c4deszes/bike-rotor-sensor/hardware/docs/index.rst

Rotor Sensor PCBA
=================

.. toctree::
    :maxdepth: 4

    arch/index.rst
    design/index.rst
