c4deszes/bike-rotor-sensor/software/docs/design/device_config.rst

Device configuration
--------------------

The device configuration is a single NVM sector (256 bytes).

Layout
------

Front wheel circumference (16 bit)
Rear wheel circumference (16 bit)
Crankset circumference (16 bit)

Front sensor type (8 bit)
Rear sensor type (8 bit)
Cadence sensor type (8 bit)

iTPMS threshold (16 bit)
iTPMS cycles/duration (16 bit)

IMU Acc. level X (16)
IMU Acc. level Y (16)
IMU Acc. level Z (16)
