c4deszes/bike-rotor-sensor/system/docs/reqs/mechanical.rst

Mechanical requirements
=======================

Mounting
--------

.. req-sys:: Mounting area
    :id: REQ_SYS_MECHANICAL_MOUNTING_AREA
    :status: accepted

    The mounting area can be seen on the picture below, it's where kickstands would normally be
    mounted.

    The area is a ``31mm x 52 mm`` rectangle with a ``10mm`` hole in the middle.

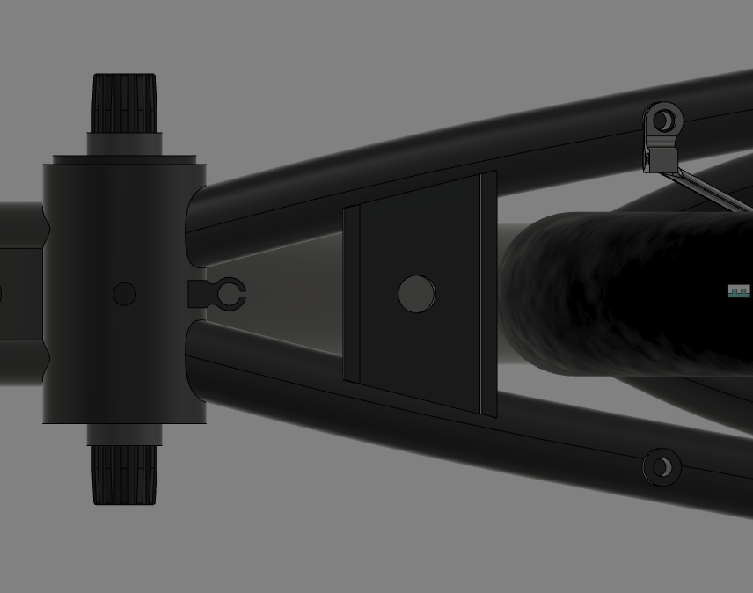
[picture p1: system/docs/reqs/assets/mounting.png]
