c4deszes/bike-rotor-sensor/hardware/docs/design/index.rst

Design
======

.. toctree::
    :maxdepth: 4

    pwr_conditioning
    output_stage
    communication
    controller
    sensor
