c4deszes/bike-rotor-sensor/hardware/docs/design/sensor.rst

Sensor
======

:download:`BMI088 <../datasheets/BMI088.pdf>` is chosen for motion sensing, it incorporates an
accelerometer and a gyroscope in one chip.

Schematic
---------

See SPI connection diagram :download:`BMI088 <../datasheets/BMI088.pdf>` , section 7.2 - page 53.
