c4deszes/bike-rotor-sensor/software/docs/design/index.rst

Design
======

.. toctree::

    clock
    communication
    inertial_estimator
    itpms_service
    measurement
    output_stage
    sensor_control
    speed_monitor
