c4deszes/bike-rotor-sensor/software/docs/index.rst

Rotor Sensor software
=====================

.. toctree::

    arch/index
    design/index
