c4deszes/bike-rotor-sensor/hardware/design/connector-pcb/models/B04B-JWPF-SK-R.step

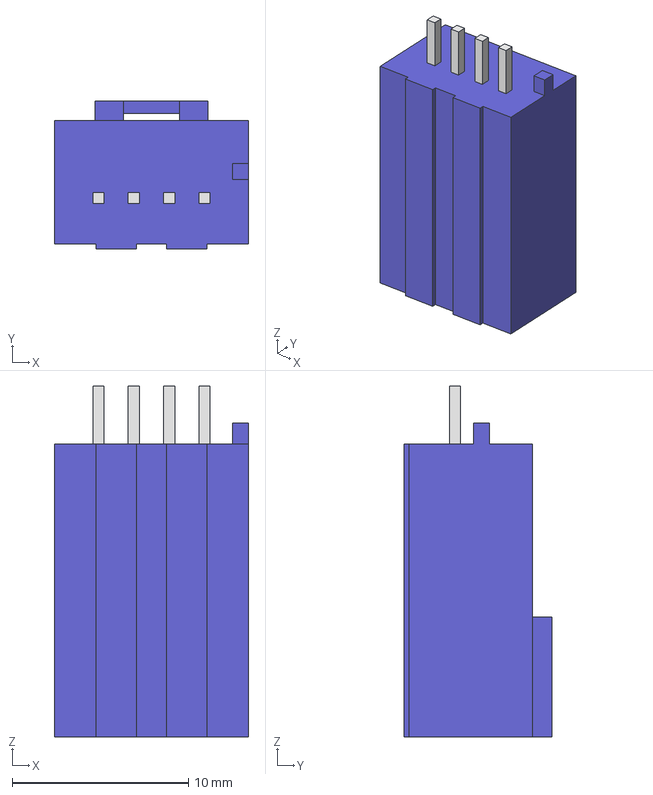
[picture p5: CAD file, 2024-10-27]
hardware/design/connector-pcb/models/B04B-JWPF-SK-R.step
11.0 x 8.40 x 19.9 mm
