c4deszes/bike-rotor-sensor/hardware/design/connector-pcb/pcba_outline.dxf

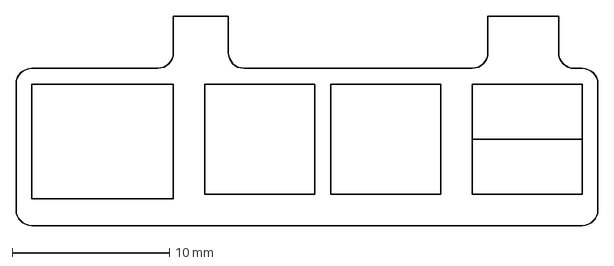
[picture p6: CAD file, 2025-10-19]
hardware/design/connector-pcb/pcba_outline.dxf
37.0 x 13.3 mm
