c4deszes/bike-rotor-sensor/hardware/design/optical-sensor/models/pcba_outline.dxf

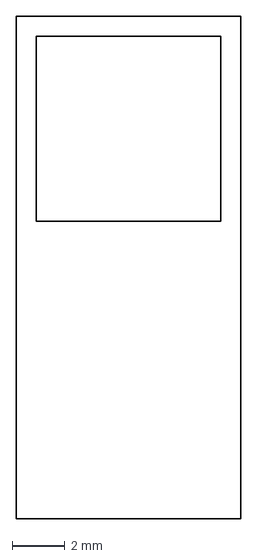
[picture p7: CAD file, 2024-10-27]
hardware/design/optical-sensor/models/pcba_outline.dxf
8.50 x 19.0 mm
