c4deszes/bike-rotor-sensor/hardware/design/rotor-sensor/models/VLS3015CX-1R0M-1.step

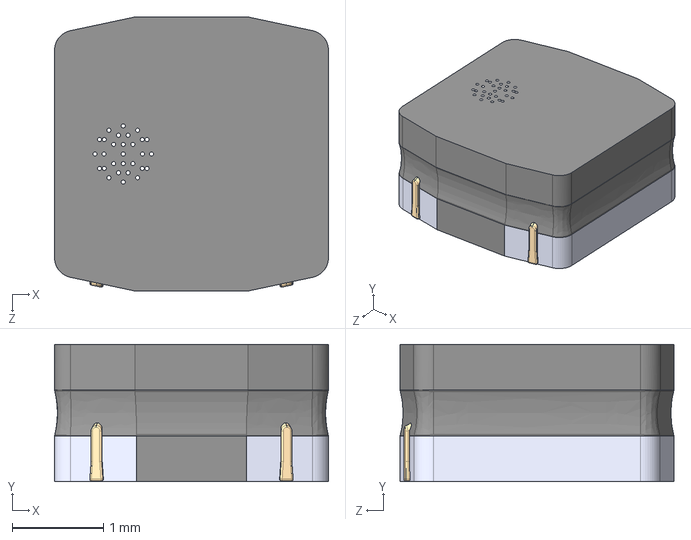
[picture p8: CAD file, 2025-10-19]
hardware/design/rotor-sensor/models/VLS3015CX-1R0M-1.step
3.00 x 1.50 x 3.00 mm
