c4deszes/bike-rotor-sensor/hardware/design/rotor-sensor/pcba_outline.dxf

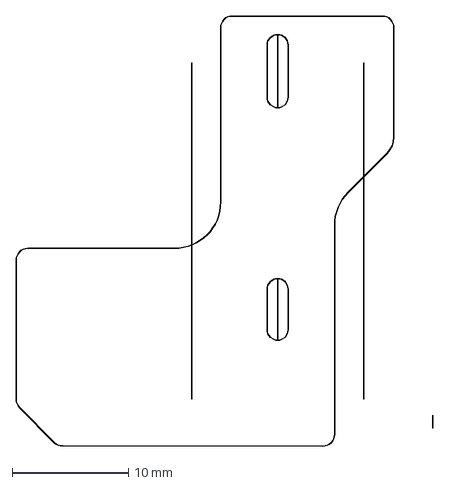
[picture p9: CAD file, 2025-10-19]
hardware/design/rotor-sensor/pcba_outline.dxf
35.9 x 37.0 mm
