c4deszes/bike-rotor-sensor/hardware/design/connector-pcb/models/B03B-JWPF-SK-R.STEP

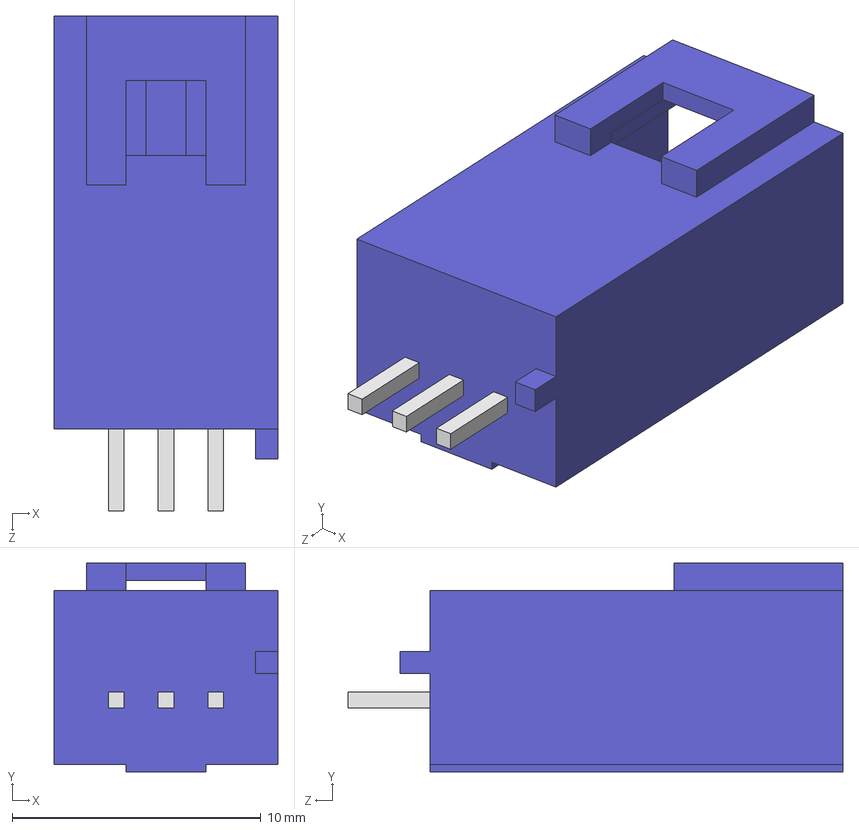
[picture p10: CAD file, 2024-10-27]
hardware/design/connector-pcb/models/B03B-JWPF-SK-R.STEP
9.00 x 8.40 x 19.9 mm
