c4deszes/bike-rotor-sensor/hardware/design/rotor-sensor/models/BMI088.step

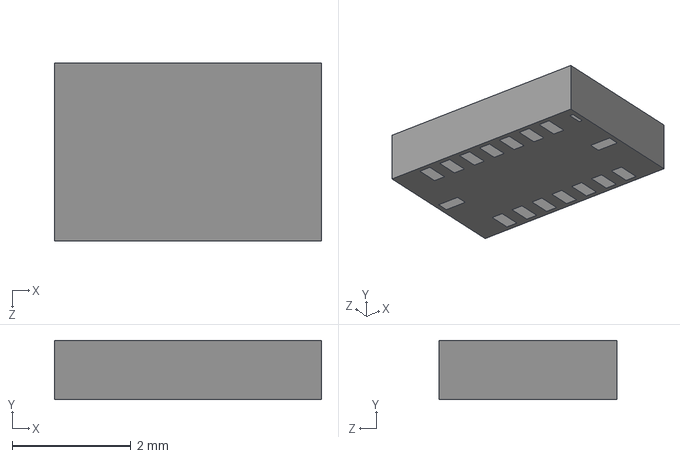
[picture p11: CAD file, 2025-10-19]
hardware/design/rotor-sensor/models/BMI088.step
4.50 x 1.00 x 3.00 mm
