c4deszes/bike-rotor-sensor/hardware/design/connector-pcb/models/B02B-JWPF-SK-R.step

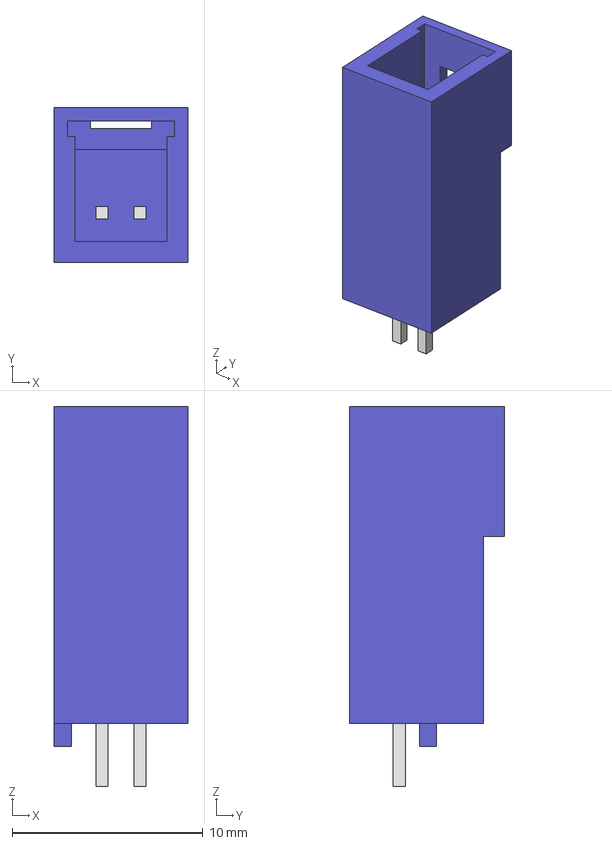
[picture p12: CAD file, 2024-10-27]
hardware/design/connector-pcb/models/B02B-JWPF-SK-R.step
7.00 x 8.10 x 19.9 mm
