c4deszes/bike-rotor-sensor/hardware/design/rotor-sensor/models/BMP581.step

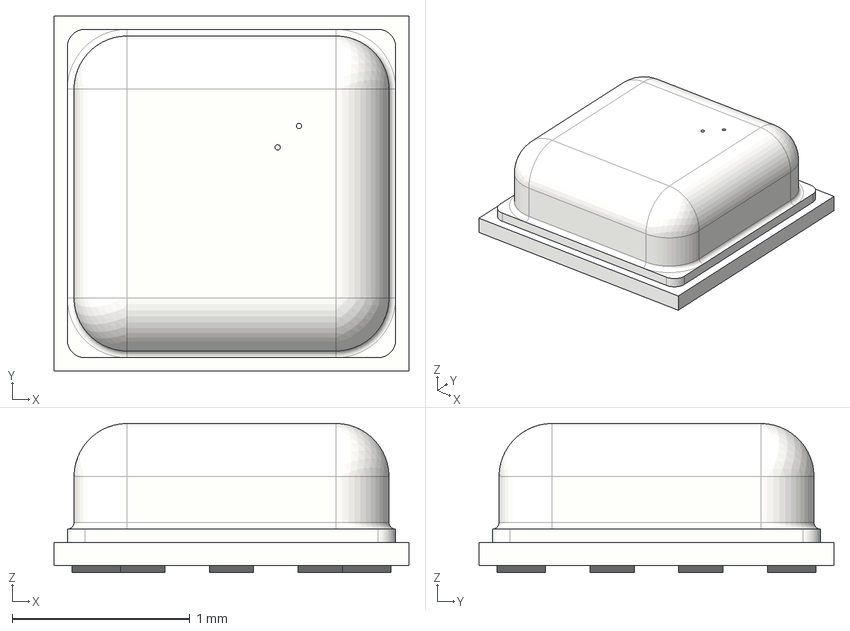
[picture p13: CAD file, 2025-10-19]
hardware/design/rotor-sensor/models/BMP581.step
2.00 x 2.00 x 0.84 mm
