c4deszes/bike-rotor-sensor/(list of files, cad)

Other CAD files:
mechanics/design/gen1.0/Housing_v53.stl
mechanics/design/gen2.0/Cover_v54_2wire.stl
mechanics/design/gen2.1/Cover_v23.stl
mechanics/design/magnet-holder/ValveMagnetHolder_v6.stl
mechanics/design/sensor-holder/SpeedSensor_MagneticRear_wCrank_v18_Cover.stl
mechanics/tools/motor-jig/MotorHolder.stl
mechanics/tools/probe/SensorProbeMount.stl
mechanics/tools/testjig/BearingFlange.stl
mechanics/design/gen1.0/Cover_v53.stl
mechanics/design/gen2.0/Base_v54_2wire.stl
mechanics/design/gen2.1/Base_v23.stl
mechanics/design/magnet-holder/CrankMagnetHolder_Hex6_v3.stl
mechanics/design/sensor-holder/SpeedSensor_MagneticRear_wCrank_v18_Body.stl
mechanics/tools/motor-jig/RotorHolder2.stl
mechanics/tools/probe/ProbeBottomHolder.stl
mechanics/tools/testjig/Base.stl
mechanics/design/gen2.0/Base_v9_3wire.stl
mechanics/design/gen2.1/Seal_v23.stl
mechanics/design/sensor-holder/SpeedSensor_MagneticFront_v26.stl
mechanics/tools/motor-jig/RotorHolder.stl
mechanics/tools/probe/SensorProbeMount2.stl
mechanics/tools/testjig/MotorHolder.stl
mechanics/design/gen2.0/Cover_v9_3wire.stl
mechanics/design/sensor-holder/SpeedSensor_OpticalRear_v11.stl
mechanics/tools/motor-jig/RotorBase.stl
mechanics/tools/testjig/MagnetHolderTop.stl
mechanics/design/sensor-holder/SpeedSensor_MagneticRear_v16.stl
mechanics/tools/motor-jig/Rotor.stl
mechanics/tools/testjig/CenterLockCarrier.stl
mechanics/tools/testjig/MagnetHolderBottom.stl
mechanics/tools/testjig/MotorFlange.stl
hardware/design/connector-pcb/models/pcba_outline.dxf
hardware/design/rotor-sensor/models/TPS629210DRLR.step
hardware/design/rotor-sensor/models/pcba_outline.dxf
