c4deszes/bike-rotor-sensor/system/docs/tests/index.rst

Test plan
---------

.. toctree::
    :maxdepth: 1

    electrical
    environmental
