c4deszes/bike-rotor-sensor/system/docs/fmea/index.rst

Failure mode analysis and evaluation
====================================

.. toctree::

    measurement
    sensors
