c4deszes/bike-rotor-sensor/hardware/design/rotor-sensor/rotor-sensor.kicad_pcb

## KiCad design hardware/design/rotor-sensor/rotor-sensor.kicad_pcb (2025-10-19)

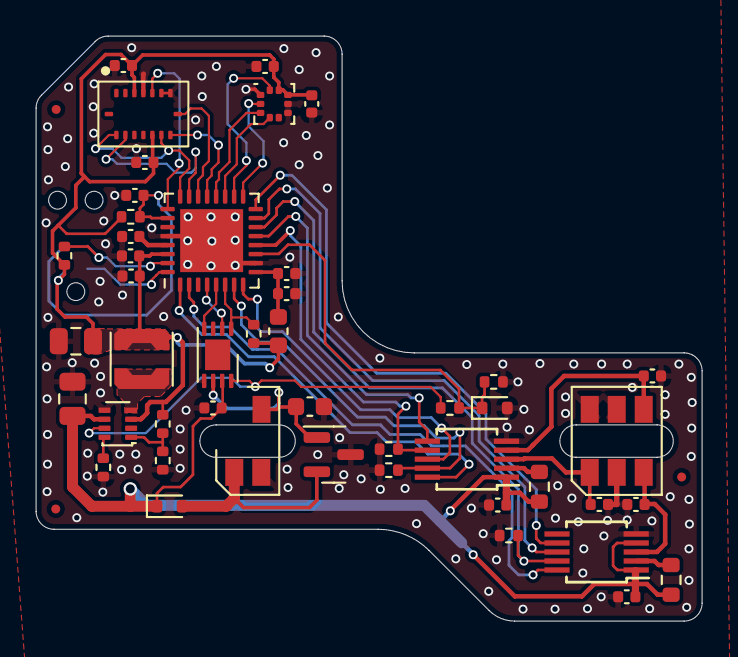
[picture p14: board rotor-sensor.kicad_pcb from above]

Board: 2 copper layers, 37.0 x 32.5 mm, 50 parts (1 on the bottom side), 41 nets.

Parts:
C1, C2, C3, C6, C8, C9, C12, C15, C20, C23, C27, C600, C601: 100n; C_0402_1005Metric
C4, C5: 10u; C_0402_1005Metric
C7: 2.2u; C_0402_1005Metric
C10: 220p; C_0603_1608Metric
C11: 22u; C_0805_2012Metric
C16: 10u; C_0805_2012Metric
D1: BAS3005B02; D_SOD-523
D2: MM5Z3V6T1G; D_SOD-523
D4: SDT23C15L02; SOT-23
FID1, FID3, FID4: Fiducial; Fiducial_0.5mm_Mask1mm
J1: Conn_ARM_SWD_TagConnect_TC2030-NL; Tag-Connect_TC2030-IDC-NL_2x03_P1.27mm_Vertical
J2: Conn_01x06; SOIC-6
L1: 10uH; L_0603_1608Metric
L3: 2.2u; L_Coilcraft_LPS3010
R1, R3, R4, R6, R15, R17: 4.7k; R_0402_1005Metric
R2: 47k; R_0402_1005Metric
R5: 20k; R_0402_1005Metric
R7: 0; R_0402_1005Metric
R9, R18: 63.4k; R_0603_1608Metric
R12: 1k; R_0402_1005Metric
R13: 10k; R_0402_1005Metric
U1, U8: MAX9621AUB+T; MSOP-10_3x3mm_P0.5mm
U2: MCP2003BT-E/MC; DFN-8-1EP_3x2mm_P0.5mm_EP1.7x1.4mm
U3: BMI088; Bosch_LGA16
U6: TPS629210DRLR; SOT-583-8
U7: SOIC-4
U10: ATSAMD21E18A-MUT; VQFN-32-1EP_5x5mm_P0.5mm_EP3.5x3.5mm
U600: BMP581; Bosch_LGA10

Connections:
+3.3V: C4.2, C8.2, C9.1, C11.1, C12.2, C600.2, C601.2, J1.1 (VCC), L1.1, L3.2, R4.1, R5.1, R12.1, R13.1, U3.3 (VDD), U3.11 (VDDIO), U6.3 (VOS), U10.30 (VDDIN), U600.1 (VDDIO), U600.10 (VDD)
+BATT: C1.2, C2.2, C6.2, C16.2, D1.1 (K), R9.1, R18.1, U1.1 (BAT), U2.7 (V_{BB}), U6.6 (VIN), U8.1 (BAT), U8.4 (IN2)
/M03_EN: U2.2 (CS), U10.4 (PA03)
/M03_LINE: C10.1, D4.1 (K), U2.6 (L_{BUS}), U7.3
/M03_REGEN: R2.1, U2.8 (V_{REN}), U6.7 (EN)
/M03_RXD: R4.2, U2.1 (R_{XD}), U10.6 (PA05)
/M03_TXD: U2.4 (T_{XD}), U10.5 (PA04)
/M03_VMON: D2.1 (K), R2.2, R3.1, U10.11 (PA08)
/M04_IN1_IN: C3.2, J2.1, U1.3 (IN1)
/M04_IN2_IN: C27.2, J2.4, U1.4 (IN2)
/M04_IN3_IN: C23.2, J2.3, U8.3 (IN1)
/M04_INPUT1_DIAG/OE: R17.2, U1.9 (AOUT1), U10.7 (PA06)
/M04_INPUT1/~ERR: U1.8 (DOUT1), U10.8 (PA07)
/M04_INPUT2_DIAG/INPUT1: R15.2, U1.7 (AOUT2), U10.12 (PA09)
/M04_INPUT2/INPUT2: U1.6 (DOUT2), U10.13 (PA10)
/M04_INPUT3_DIAG/OE: R1.2, U8.9 (AOUT1), U10.14 (PA11)
/M04_INPUT3/~ERR: U8.8 (DOUT1), U10.15 (PA14)
/M04_NC/INPUT3: U8.7 (AOUT2), U10.16 (PA15)
/M04_~SLEEP1/DIAG1: U1.10 (~SLEEP), U10.1 (PA00)
/M04_~SLEEP2/DIAG2: U8.10 (~SLEEP), U10.2 (PA01)
/M05_BMI088_MOSI: U3.9 (SDI), U10.21 (PA22)
/M05_BMI088_SCK: U3.8 (SCK), U10.22 (PA23)
/M05_RESET: C20.2, J1.3 (~RESET), R13.2, U10.26 (~RESET)
/M05_SWCLK: J1.4 (SWCLK), R12.2, U10.31 (PA30)
/M05_SWDIO: J1.2 (SWDIO), U10.32 (PA31)
/M06_BMI088_CSA: U3.14 (CSB1), U10.23 (PA24)
/M06_BMI088_CSG: U3.5 (CSB2), U10.25 (PA27)
/M06_BMI088_MISO: U3.10 (SDO2), U3.15 (SDO1), U10.24 (PA25)
/M06_BMP581_CS: U10.19 (PA18), U600.6 (CSB)
/M06_BMP581_MISO: U10.20 (PA19), U600.5 (SDO)
/M06_BMP581_MOSI: U10.17 (PA16), U600.4 (SDI)
/M06_BMP581_SCK: U10.18 (PA17), U600.2 (SCK)
/TPS629210_FB: R5.2, R6.1, U6.1 (FB)
/TPS629210_MODE: R7.1, U6.8 (MODE)
/TPS629210_SW: L3.1, U6.4 (SW)
/VDDANA: C5.2, C15.2, L1.2, U10.9 (VDDANA)
/VDDCORE: C7.2, U10.29 (VDDCORE)
GND: C1.1, C2.1, C3.1, C4.1, C5.1, C6.1, C7.1, C8.1, C9.2, C10.2, C11.2, C12.1, C15.1, C16.1, C20.1, C23.1, C27.1, C600.1, C601.1, D2.2 (A), D4.3 (A), J1.5 (GND), J2.2, J2.5, J2.6, R1.1, R3.2, R6.2, R7.2, R15.1, R17.1, U1.5 (GND), U2.5 (V_{SS}), U3.4 (GND), U3.6 (GNDIO), U3.7 (PS), U6.5 (GND), U7.2, U8.5 (GND), U10.10 (GND), U10.28 (GND), U10.33 (GND), U600.3 (GND), U600.8 (GND), U600.9 (GND)
unnamed: R18.2, U1.2 (ISET)
unnamed: R9.2, U8.2 (ISET)
VS: D1.2 (A), D4.2 (K), U7.1
