c4deszes/bike-rotor-sensor/hardware/design/connector-pcb/connector-pcb.kicad_pcb

## KiCad design hardware/design/connector-pcb/connector-pcb.kicad_pcb (2025-10-19)

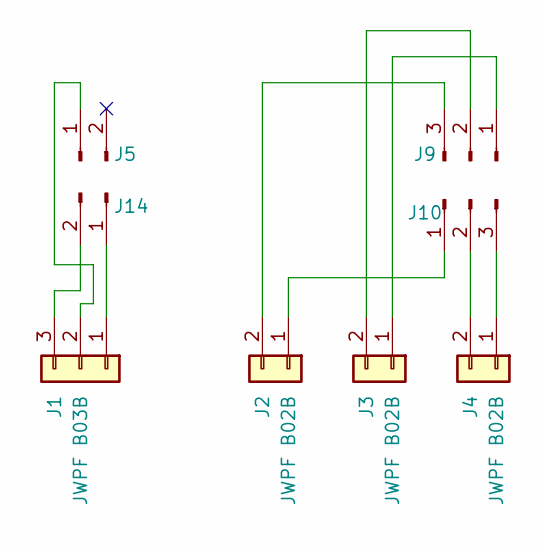
[picture p15: schematic connector-pcb.kicad_sch]

Parts:
J1: JWPF B03B; JST_JWPF_B03B-JWPF-SK-R_1x03_P2.00mm_Vertical
J2, J3, J4: JWPF B02B; JST_JWPF_B02B-JWPF-SK-R_1x02_P2.00mm_Vertical
J5, J14: Conn_01x02_Pin; SMD_2PIN
J9, J10: Conn_01x03_Pin; SMD_3PIN

Connections:
unnamed: J1.1, J14.1
unnamed: J1.2, J5.1
unnamed: J1.3, J14.2
unnamed: J2.2, J9.3
unnamed: J3.1, J9.1
unnamed: J3.2, J9.2
unnamed: J2.1, J10.1
unnamed: J4.2, J10.2
unnamed: J4.1, J10.3

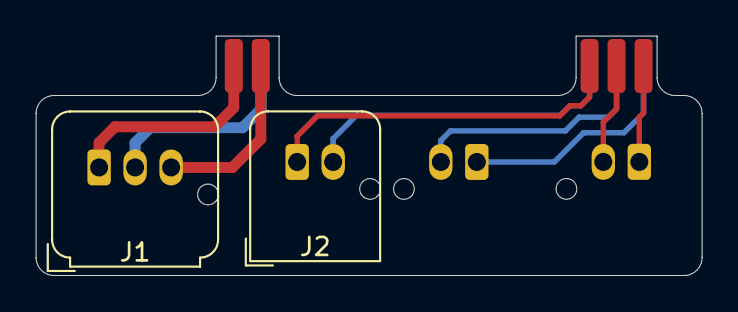
[picture p16: board connector-pcb.kicad_pcb from above]

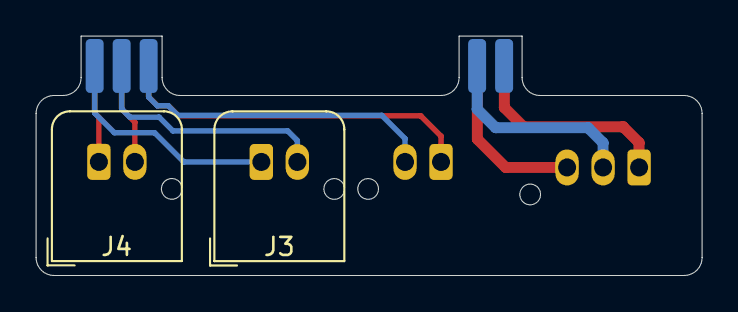
[picture p17: board connector-pcb.kicad_pcb from below]

Board: 2 copper layers, 37.0 x 13.3 mm, 8 parts (4 on the bottom side), 9 nets.
