c4deszes/bike-rotor-sensor/hardware/design/optical-sensor/optical-sensor.kicad_pcb

## KiCad design hardware/design/optical-sensor/optical-sensor.kicad_pcb (2024-10-27)

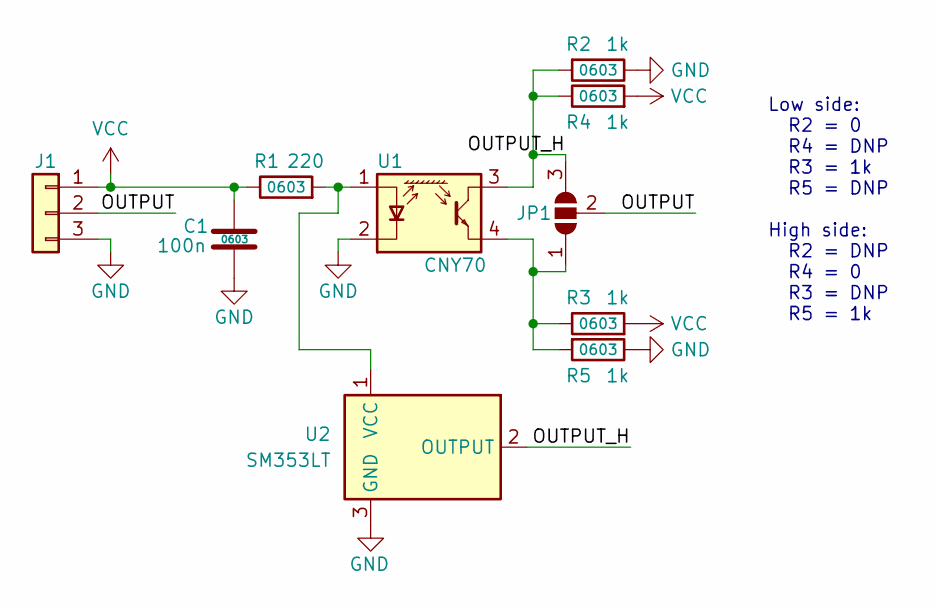
[picture p18: schematic optical-sensor.kicad_sch]

Parts:
C1: 100n; C_0603_1608Metric
J1: PinHeader_1x03_P2.54mm_Vertical
JP1: SolderJumper_3_Open; SolderJumper-3_P1.3mm_Open_RoundedPad1.0x1.5mm
R1: 220; R_0603_1608Metric
R2, R3, R4, R5: 1k; R_0603_1608Metric
U1: CNY70; Vishay_CNY70
U2: SM353LT; SOT-23

Connections:
/OUTPUT: J1.2, JP1.2 (C)
/OUTPUT_H: JP1.3 (B), R2.2, R4.1, U1.3 (C), U2.2 (OUTPUT)
GND: C1.2, J1.3, R2.1, R5.1, U1.2 (K), U2.3 (GND)
unnamed: JP1.1 (A), R3.1, R5.2, U1.4 (E)
unnamed: R1.2, U1.1 (A), U2.1 (VCC)
VCC: C1.1, J1.1, R1.1, R3.2, R4.2

Notes on the sheet:
Low side: R2 = 0 R4 = DNP R3 = 1k R5 = DNP High side: R2 = DNP R4 = 0 R3 = DNP R5 = 1k

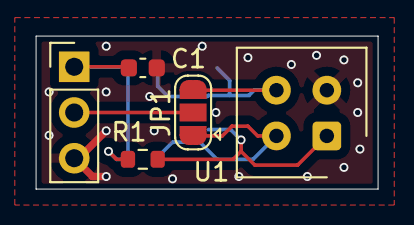
[picture p19: board optical-sensor.kicad_pcb from above]

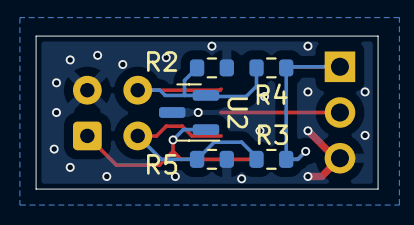
[picture p20: board optical-sensor.kicad_pcb from below]

Board: 2 copper layers, 19.0 x 8.5 mm, 10 parts (5 on the bottom side), 6 nets.
