c4deszes/bike-rotor-sensor/software/include/app/sys_state.h

#if !defined(APP_SYS_STATE_H_)
#define APP_SYS_STATE_H_

/**
 * @brief Initialize the system state machine
 */
void SYSSTATE_Initialize(void);

/**
 * @brief Updates the system state machine
 */
void SYSSTATE_Update(void);

#endif // APP_SYS_STATE_H_
