c4deszes/bike-rotor-sensor/software/src/app/altitude.c

#include "app/altitude.h"
#include "bsp/bmp581.h"
#include "app/config.h"

#include "common/swtimer.h"

#include "bmp5.h"
#include "bmp5_defs.h"

/* Altitude measurement status */
static ALT_Status_t ALT_Status;
static uint32_t ALT_Pressure;
static int16_t ALT_Altitude;
static uint16_t ALT_Temperature;

/* Altitude sensor */
static swtimer_t* ALT_SensorTimer;
static uint8_t ALT_StartupAttempts;
static bool ALT_SensorInitialized;
static int8_t ALT_BMP5_InitCode;
static uint8_t ALT_RuntimeErrorCnt;

/* BMP58X configuration */
static struct bmp5_osr_odr_press_config ALT_BMP5_RateConfig = { 0 };
static struct bmp5_iir_config ALT_BMP5_IIRConfig = {
    .set_iir_t = BMP5_IIR_FILTER_COEFF_1,   // TODO: choose filter coefficient
    .set_iir_p = BMP5_IIR_FILTER_COEFF_1,   // TODO: choose filter coefficient
    .shdw_set_iir_t = BMP5_ENABLE,
    .shdw_set_iir_p = BMP5_ENABLE
};
static struct bmp5_sensor_data ALT_BMP5_SensorData = { 0 };

static void ALT_SetupSensor() {
    bmp5_init(&BMP581_Device);

    ALT_BMP5_InitCode = bmp5_set_power_mode(BMP5_POWERMODE_STANDBY, &BMP581_Device);

    if (ALT_BMP5_InitCode != BMP5_OK) {
        return;
    }

    ALT_BMP5_InitCode = bmp5_get_osr_odr_press_config(&ALT_BMP5_RateConfig, &BMP581_Device);
    if (ALT_BMP5_InitCode != BMP5_OK) {
        return;
    }

    ALT_BMP5_RateConfig.press_en = BMP5_ENABLE;
    // TODO: output data rate

    ALT_BMP5_InitCode = bmp5_set_osr_odr_press_config(&ALT_BMP5_RateConfig, &BMP581_Device);
    if (ALT_BMP5_InitCode != BMP5_OK) {
        return;
    }

    ALT_BMP5_InitCode = bmp5_set_iir_config(&ALT_BMP5_IIRConfig, &BMP581_Device);
    if (ALT_BMP5_InitCode != BMP5_OK) {
        return;
    }

    ALT_BMP5_InitCode = bmp5_set_power_mode(BMP5_POWERMODE_CONTINOUS, &BMP581_Device);
    if (ALT_BMP5_InitCode != BMP5_OK) {
        return;
    }
}

void ALT_Initialize(void) {
    ALT_Status = ALT_Status_NotAvailable;
    ALT_Pressure = 0;
    ALT_Altitude = 0;
    ALT_Temperature = 0;

    ALT_SensorTimer = SWTIMER_Create();
    ALT_StartupAttempts = 0;
    ALT_SensorInitialized = false;
    ALT_BMP5_InitCode = BMP5_OK;
    ALT_RuntimeErrorCnt = 0;

    SWTIMER_Setup(ALT_SensorTimer, ALT_SENSOR_STARTUP_TIME);
}

ALT_Status_t ALT_GetStatus(void) {
    return ALT_Status;
}

bool ALT_HasPressureError(void) {
    // TODO: implement
    return false;
}

bool ALT_HasTemperatureError(void) {
    // TODO: implement
    return false;
}

int16_t ALT_GetAltitude(void) {
    return ALT_Altitude;
}

uint32_t ALT_GetPressure(void) {
    return ALT_Pressure;
}

uint16_t ALT_GetTemperature(void) {
    return ALT_Temperature;
}

int16_t CalculateAltitude(uint32_t qnh, uint16_t temperature, uint32_t pressure);

void ALT_Update(void) {
    if (!ALT_SensorInitialized && CONFIG_Props.Altitude_Enabled && SWTIMER_Elapsed(ALT_SensorTimer)) {
        ALT_SetupSensor();

        if (ALT_BMP5_InitCode == BMP5_OK) {
            ALT_Status = ALT_Status_Ok;
            ALT_SensorInitialized = true;
        } else {
            SWTIMER_Setup(ALT_SensorTimer, ALT_SENSOR_STARTUP_ATTEMPT_DELAY);
            ALT_Status = ALT_Status_Error;

#if ALT_SENSOR_STARTUP_ATTEMPTS > 0
            if (ALT_StartupAttempts < ALT_SENSOR_STARTUP_ATTEMPTS) {
                ALT_StartupAttempts++;
            }
            else {
                ALT_Status = ALT_Status_PermanentError;
            }
#endif
        }
    }

    if (ALT_SensorInitialized && ALT_Status != ALT_Status_PermanentError) {
        int8_t read_status = bmp5_get_sensor_data(&ALT_BMP5_SensorData,
                                                  &ALT_BMP5_RateConfig,
                                                  &BMP581_Device);

        if (read_status == BMP5_OK) {
            ALT_Pressure = ALT_BMP5_SensorData.pressure / 100;
            ALT_Temperature = ALT_BMP5_SensorData.temperature / 100 + 273;
            ALT_Altitude = CalculateAltitude(CONFIG_Props.Altitude_QNH * 100,
                                             ALT_Temperature,
                                             ALT_Pressure);
            
            // TODO: verify pressure, temperature in plausible range
            if (ALT_Altitude > 5000 || ALT_Altitude < -500) {
                ALT_Status = ALT_Status_Error;
            }
            else {
                ALT_Status = ALT_Status_Ok;
            }
        }
        else {
            ALT_Status = ALT_Status_Error;
#if ALT_SENSOR_POLL_MAX_ERRORS > 0
            if (ALT_RuntimeErrorCnt < ALT_SENSOR_POLL_MAX_ERRORS) {
                ALT_RuntimeErrorCnt++;
            }
            else {
                ALT_Status = ALT_Status_PermanentError;
            }
#endif
        }
    }
}

#define LOOKUP_OUT_OF_RANGE 0xFF

static inline uint8_t QNH_Index(uint32_t qnh) {
    if (qnh < 100000 || qnh > 104000) {
        return LOOKUP_OUT_OF_RANGE;
    }
    uint8_t index = (qnh - 100000) / 100;
    if (index >= 41) {
        return LOOKUP_OUT_OF_RANGE;
    }
    return index;
}

static inline uint8_t TEMP_Index(uint16_t temp) {
    if (temp < 263) {
        return LOOKUP_OUT_OF_RANGE;
    } else if (temp < 268) {
        return 0;
    } else if (temp < 278) {
        return 1;
    } else if (temp < 288) {
        return 2;
    } else if (temp < 298) {
        return 3;
    } else if (temp < 308) {
        return 4;
    } else if (temp < 318) {
        return 5;
    } else if (temp <= 338) {
        return 6;
    }
    return LOOKUP_OUT_OF_RANGE;
}

static inline int16_t Index_ToAlt(uint8_t index) {
    return 100 * index - 500;
}

#define ALTITUDE_LOOKUP_SIZE 56
#define PRESSURE_OFFSET 48000u

const uint16_t ALT_Lookup[41][7][56] = {
  /*  */
  { /* QNH=100000 Pa */
 /* T=263K (-10.1C) */   {58666u, 57305u, 55958u, 54624u, 53305u, 52000u, 50708u, 49429u, 48164u, 46913u, 45674u, 44449u, 43237u, 42037u, 40851u, 39677u, 38515u, 37367u, 36230u, 35106u, 33994u, 32894u, 31806u, 30730u, 29666u, 28613u, 27572u, 26543u, 25525u, 24518u, 23522u, 22538u, 21564u, 20601u, 19650u, 18709u, 17778u, 16858u, 15949u, 15049u, 14161u, 13282u, 12413u, 11555u, 10706u, 9867u, 9038u, 8218u, 7408u, 6608u, 5817u, 5035u, 4262u, 3499u, 2745u, 1999u},
 /* T=273K (-0.1C) */   {58416u, 57107u, 55811u, 54527u, 53257u, 52000u, 50755u, 49522u, 48303u, 47095u, 45900u, 44717u, 43546u, 42387u, 41240u, 40105u, 38982u, 37870u, 36770u, 35681u, 34604u, 33537u, 32482u, 31438u, 30405u, 29383u, 28372u, 27372u, 26382u, 25402u, 24434u, 23475u, 22527u, 21589u, 20661u, 19743u, 18835u, 17937u, 17049u, 16171u, 15302u, 14443u, 13593u, 12753u, 11921u, 11100u, 10287u, 9483u, 8688u, 7903u, 7126u, 6358u, 5598u, 4847u, 4105u, 3371u},
 /* T=283K (9.9C) */   {58184u, 56923u, 55674u, 54437u, 53212u, 52000u, 50798u, 49609u, 48431u, 47265u, 46110u, 44967u, 43835u, 42714u, 41604u, 40505u, 39417u, 38340u, 37274u, 36218u, 35173u, 34139u, 33115u, 32101u, 31098u, 30105u, 29121u, 28148u, 27185u, 26232u, 25289u, 24355u, 23431u, 22517u, 21612u, 20717u, 19830u, 18954u, 18086u, 17227u, 16378u, 15537u, 14706u, 13883u, 13069u, 12264u, 11467u, 10679u, 9899u, 9128u, 8365u, 7611u, 6864u, 6126u, 5396u, 4674u},
 /* T=293K (19.9C) */   {57968u, 56752u, 55547u, 54353u, 53171u, 52000u, 50839u, 49690u, 48551u, 47424u, 46306u, 45200u, 44104u, 43019u, 41944u, 40879u, 39824u, 38780u, 37746u, 36721u, 35707u, 34702u, 33708u, 32723u, 31747u, 30781u, 29825u, 28878u, 27941u, 27012u, 26093u, 25183u, 24282u, 23391u, 22508u, 21634u, 20768u, 19912u, 19064u, 18225u, 17394u, 16571u, 15757u, 14952u, 14155u, 13365u, 12584u, 11811u, 11047u, 10290u, 9540u, 8799u, 8066u, 7340u, 6622u, 5911u},
 /* T=303K (29.9C) */   {57766u, 56592u, 55428u, 54275u, 53132u, 52000u, 50877u, 49765u, 48664u, 47572u, 46490u, 45418u, 44356u, 43304u, 42262u, 41229u, 40206u, 39192u, 38188u, 37193u, 36208u, 35232u, 34264u, 33307u, 32358u, 31418u, 30487u, 29565u, 28651u, 27747u, 26851u, 25963u, 25085u, 24214u, 23352u, 22499u, 21654u, 20817u, 19988u, 19167u, 18354u, 17549u, 16753u, 15964u, 15182u, 14409u, 13643u, 12885u, 12134u, 11391u, 10656u, 9928u, 9207u, 8493u, 7787u, 7088u},
 /* T=313K (39.9C) */   {57578u, 56443u, 55317u, 54201u, 53096u, 52000u, 50913u, 49836u, 48769u, 47711u, 46662u, 45623u, 44593u, 43572u, 42561u, 41558u, 40564u, 39580u, 38604u, 37637u, 36679u, 35729u, 34789u, 33856u, 32933u, 32017u, 31110u, 30212u, 29322u, 28440u, 27566u, 26700u, 25842u, 24993u, 24151u, 23317u, 22491u, 21672u, 20862u, 20059u, 19263u, 18476u, 17695u, 16922u, 16157u, 15399u, 14648u, 13904u, 13168u, 12438u, 11716u, 11000u, 10292u, 9590u, 8896u, 8208u},
 /* T=323K (49.9C) */   {57401u, 56303u, 55213u, 54133u, 53062u, 52000u, 50947u, 49903u, 48867u, 47841u, 46824u, 45815u, 44815u, 43824u, 42842u, 41867u, 40902u, 39945u, 38996u, 38055u, 37123u, 36199u, 35283u, 34375u, 33475u, 32583u, 31699u, 30823u, 29955u, 29094u, 28241u, 27396u, 26559u, 25729u, 24906u, 24091u, 23283u, 22483u, 21690u, 20904u, 20126u, 19354u, 18590u, 17832u, 17082u, 16339u, 15602u, 14873u, 14150u, 13434u, 12724u, 12021u, 11325u, 10635u, 9952u, 9276u},
  },
  { /* QNH=100100 Pa */
 /* T=263K (-10.1C) */   {58773u, 57410u, 56062u, 54727u, 53406u, 52100u, 50806u, 49527u, 48260u, 47007u, 45768u, 44541u, 43328u, 42127u, 40939u, 39764u, 38602u, 37452u, 36314u, 35189u, 34076u, 32975u, 31886u, 30809u, 29744u, 28690u, 27648u, 26617u, 25598u, 24590u, 23594u, 22608u, 21634u, 20670u, 19717u, 18775u, 17844u, 16923u, 16013u, 15113u, 14223u, 13343u, 12474u, 11614u, 10765u, 9925u, 9095u, 8275u, 7464u, 6663u, 5871u, 5088u, 4315u, 3551u, 2795u, 2049u},
 /* T=273K (-0.1C) */   {58522u, 57212u, 55914u, 54630u, 53358u, 52100u, 50853u, 49620u, 48399u, 47190u, 45994u, 44810u, 43638u, 42478u, 41330u, 40193u, 39069u, 37956u, 36855u, 35765u, 34686u, 33619u, 32563u, 31518u, 30484u, 29461u, 28448u, 27447u, 26456u, 25476u, 24506u, 23547u, 22597u, 21659u, 20730u, 19811u, 18902u, 18003u, 17114u, 16235u, 15365u, 14505u, 13655u, 12813u, 11981u, 11159u, 10345u, 9541u, 8745u, 7959u, 7181u, 6412u, 5652u, 4900u, 4157u, 3423u},
 /* T=283K (9.9C) */   {58290u, 57028u, 55778u, 54540u, 53314u, 52100u, 50897u, 49707u, 48528u, 47360u, 46204u, 45060u, 43926u, 42804u, 41693u, 40593u, 39505u, 38426u, 37359u, 36302u, 35256u, 34221u, 33196u, 32181u, 31177u, 30183u, 29199u, 28225u, 27261u, 26306u, 25362u, 24428u, 23503u, 22587u, 21682u, 20785u, 19898u, 19021u, 18152u, 17293u, 16442u, 15601u, 14769u, 13945u, 13130u, 12324u, 11527u, 10738u, 9957u, 9185u, 8422u, 7666u, 6919u, 6180u, 5449u, 4726u},
 /* T=293K (19.9C) */   {58074u, 56856u, 55650u, 54456u, 53272u, 52100u, 50938u, 49788u, 48648u, 47519u, 46401u, 45293u, 44196u, 43110u, 42034u, 40968u, 39912u, 38867u, 37831u, 36806u, 35791u, 34785u, 33789u, 32803u, 31827u, 30860u, 29903u, 28955u, 28016u, 27087u, 26167u, 25256u, 24355u, 23462u, 22578u, 21703u, 20837u, 19980u, 19131u, 18291u, 17459u, 16636u, 15821u, 15015u, 14217u, 13427u, 12645u, 11871u, 11106u, 10348u, 9598u, 8856u, 8122u, 7395u, 6676u, 5965u},
 /* T=303K (29.9C) */   {57872u, 56696u, 55531u, 54377u, 53233u, 52100u, 50976u, 49863u, 48760u, 47667u, 46585u, 45512u, 44449u, 43396u, 42352u, 41318u, 40294u, 39279u, 38274u, 37278u, 36292u, 35315u, 34347u, 33388u, 32438u, 31497u, 30565u, 29642u, 28728u, 27823u, 26926u, 26037u, 25158u, 24287u, 23424u, 22569u, 21723u, 20885u, 20056u, 19234u, 18420u, 17615u, 16817u, 16028u, 15246u, 14471u, 13705u, 12946u, 12195u, 11451u, 10714u, 9986u, 9264u, 8550u, 7843u, 7143u},
 /* T=313K (39.9C) */   {57683u, 56547u, 55420u, 54304u, 53197u, 52100u, 51012u, 49934u, 48865u, 47806u, 46757u, 45717u, 44686u, 43664u, 42651u, 41648u, 40653u, 39667u, 38691u, 37723u, 36764u, 35813u, 34871u, 33938u, 33014u, 32097u, 31190u, 30290u, 29399u, 28516u, 27641u, 26775u, 25916u, 25066u, 24223u, 23388u, 22561u, 21742u, 20931u, 20127u, 19331u, 18542u, 17761u, 16987u, 16221u, 15462u, 14710u, 13966u, 13229u, 12499u, 11775u, 11059u, 10350u, 9648u, 8953u, 8264u},
 /* T=323K (49.9C) */   {57507u, 56407u, 55316u, 54235u, 53163u, 52100u, 51045u, 50000u, 48964u, 47937u, 46919u, 45909u, 44908u, 43916u, 42932u, 41957u, 40991u, 40032u, 39083u, 38141u, 37208u, 36283u, 35366u, 34457u, 33556u, 32664u, 31779u, 30902u, 30033u, 29171u, 28318u, 27472u, 26633u, 25802u, 24979u, 24163u, 23355u, 22554u, 21760u, 20973u, 20194u, 19422u, 18656u, 17898u, 17147u, 16403u, 15666u, 14935u, 14212u, 13495u, 12785u, 12081u, 11384u, 10694u, 10010u, 9333u},
  },
  { /* QNH=100200 Pa */
 /* T=263K (-10.1C) */   {58880u, 57516u, 56166u, 54830u, 53508u, 52200u, 50905u, 49624u, 48357u, 47102u, 45861u, 44634u, 43419u, 42217u, 41028u, 39852u, 38688u, 37537u, 36399u, 35272u, 34158u, 33056u, 31966u, 30888u, 29821u, 28767u, 27723u, 26692u, 25672u, 24663u, 23665u, 22679u, 21703u, 20739u, 19785u, 18842u, 17910u, 16988u, 16077u, 15176u, 14285u, 13404u, 12534u, 11674u, 10823u, 9983u, 9152u, 8331u, 7519u, 6717u, 5924u, 5141u, 4367u, 3602u, 2846u, 2099u},
 /* T=273K (-0.1C) */   {58629u, 57317u, 56018u, 54732u, 53460u, 52200u, 50952u, 49717u, 48495u, 47285u, 46088u, 44902u, 43729u, 42568u, 41419u, 40281u, 39156u, 38042u, 36939u, 35848u, 34769u, 33700u, 32643u, 31597u, 30562u, 29538u, 28525u, 27522u, 26530u, 25549u, 24578u, 23618u, 22668u, 21728u, 20798u, 19879u, 18969u, 18069u, 17179u, 16299u, 15429u, 14568u, 13716u, 12874u, 12041u, 11218u, 10403u, 9598u, 8802u, 8015u, 7236u, 6466u, 5705u, 4953u, 4209u, 3474u},
 /* T=283K (9.9C) */   {58396u, 57133u, 55881u, 54642u, 53415u, 52200u, 50996u, 49804u, 48624u, 47456u, 46298u, 45153u, 44018u, 42895u, 41783u, 40682u, 39592u, 38513u, 37444u, 36387u, 35340u, 34303u, 33277u, 32261u, 31256u, 30261u, 29276u, 28301u, 27336u, 26381u, 25435u, 24500u, 23574u, 22658u, 21751u, 20854u, 19966u, 19087u, 18218u, 17358u, 16507u, 15665u, 14831u, 14007u, 13191u, 12384u, 11586u, 10796u, 10015u, 9243u, 8478u, 7722u, 6974u, 6234u, 5503u, 4779u},
 /* T=293K (19.9C) */   {58180u, 56961u, 55754u, 54558u, 53373u, 52200u, 51037u, 49885u, 48744u, 47614u, 46495u, 45386u, 44288u, 43201u, 42123u, 41057u, 40000u, 38953u, 37917u, 36891u, 35874u, 34868u, 33871u, 32884u, 31907u, 30939u, 29981u, 29032u, 28092u, 27162u, 26241u, 25330u, 24427u, 23533u, 22649u, 21773u, 20906u, 20048u, 19198u, 18357u, 17525u, 16701u, 15885u, 15078u, 14279u, 13488u, 12706u, 11931u, 11165u, 10406u, 9656u, 8913u, 8178u, 7450u, 6731u, 6019u},
 /* T=303K (29.9C) */   {57978u, 56801u, 55635u, 54479u, 53334u, 52200u, 51075u, 49961u, 48857u, 47763u, 46679u, 45605u, 44541u, 43487u, 42442u, 41408u, 40382u, 39367u, 38360u, 37364u, 36376u, 35398u, 34429u, 33469u, 32518u, 31577u, 30644u, 29720u, 28805u, 27898u, 27001u, 26111u, 25231u, 24359u, 23495u, 22640u, 21793u, 20954u, 20124u, 19301u, 18487u, 17680u, 16882u, 16091u, 15309u, 14534u, 13766u, 13007u, 12255u, 11510u, 10773u, 10043u, 9321u, 8606u, 7898u, 7198u},
 /* T=313K (39.9C) */   {57789u, 56651u, 55524u, 54406u, 53298u, 52200u, 51111u, 50032u, 48962u, 47902u, 46852u, 45810u, 44778u, 43755u, 42742u, 41737u, 40742u, 39755u, 38777u, 37808u, 36848u, 35897u, 34954u, 34020u, 33094u, 32177u, 31269u, 30368u, 29476u, 28592u, 27717u, 26849u, 25990u, 25139u, 24295u, 23459u, 22632u, 21812u, 21000u, 20195u, 19398u, 18609u, 17827u, 17052u, 16285u, 15526u, 14773u, 14028u, 13290u, 12559u, 11835u, 11118u, 10409u, 9706u, 9010u, 8320u},
 /* T=323K (49.9C) */   {57612u, 56511u, 55419u, 54337u, 53264u, 52200u, 51144u, 50098u, 49061u, 48033u, 47014u, 46003u, 45001u, 44008u, 43023u, 42047u, 41080u, 40120u, 39170u, 38227u, 37293u, 36367u, 35449u, 34540u, 33638u, 32744u, 31858u, 30981u, 30111u, 29248u, 28394u, 27547u, 26708u, 25876u, 25052u, 24235u, 23426u, 22624u, 21829u, 21042u, 20262u, 19489u, 18723u, 17964u, 17212u, 16467u, 15729u, 14998u, 14274u, 13556u, 12846u, 12141u, 11444u, 10753u, 10068u, 9390u},
  },
  { /* QNH=100300 Pa */
 /* T=263K (-10.1C) */   {58986u, 57621u, 56270u, 54932u, 53609u, 52300u, 51004u, 49721u, 48453u, 47197u, 45955u, 44726u, 43510u, 42307u, 41117u, 39940u, 38775u, 37623u, 36483u, 35355u, 34240u, 33137u, 32046u, 30966u, 29899u, 28843u, 27799u, 26766u, 25745u, 24735u, 23737u, 22749u, 21773u, 20807u, 19853u, 18909u, 17975u, 17053u, 16140u, 15239u, 14347u, 13466u, 12595u, 11733u, 10882u, 10041u, 9209u, 8387u, 7575u, 6772u, 5978u, 5194u, 4419u, 3654u, 2897u, 2149u},
 /* T=273K (-0.1C) */   {58735u, 57422u, 56122u, 54835u, 53561u, 52300u, 51051u, 49815u, 48591u, 47380u, 46182u, 44995u, 43821u, 42658u, 41508u, 40370u, 39243u, 38128u, 37024u, 35932u, 34851u, 33782u, 32724u, 31677u, 30641u, 29615u, 28601u, 27598u, 26605u, 25623u, 24651u, 23689u, 22738u, 21798u, 20867u, 19947u, 19036u, 18135u, 17244u, 16363u, 15492u, 14630u, 13778u, 12935u, 12101u, 11277u, 10462u, 9656u, 8859u, 8070u, 7291u, 6521u, 5759u, 5006u, 4261u, 3525u},
 /* T=283K (9.9C) */   {58502u, 57237u, 55985u, 54744u, 53516u, 52300u, 51095u, 49902u, 48721u, 47551u, 46393u, 45246u, 44110u, 42986u, 41873u, 40771u, 39679u, 38599u, 37530u, 36471u, 35423u, 34385u, 33358u, 32341u, 31335u, 30339u, 29353u, 28377u, 27411u, 26455u, 25509u, 24572u, 23646u, 22728u, 21821u, 20923u, 20034u, 19154u, 18284u, 17423u, 16571u, 15728u, 14894u, 14069u, 13252u, 12445u, 11646u, 10855u, 10073u, 9300u, 8534u, 7778u, 7029u, 6288u, 5556u, 4832u},
 /* T=293K (19.9C) */   {58286u, 57066u, 55857u, 54660u, 53474u, 52300u, 51136u, 49983u, 48841u, 47710u, 46589u, 45480u, 44380u, 43292u, 42213u, 41145u, 40088u, 39040u, 38003u, 36975u, 35958u, 34950u, 33953u, 32965u, 31986u, 31018u, 30058u, 29109u, 28168u, 27237u, 26315u, 25403u, 24499u, 23605u, 22719u, 21842u, 20975u, 20115u, 19265u, 18423u, 17590u, 16765u, 15949u, 15141u, 14341u, 13550u, 12766u, 11991u, 11224u, 10464u, 9713u, 8970u, 8234u, 7506u, 6785u, 6073u},
 /* T=303K (29.9C) */   {58083u, 56906u, 55738u, 54582u, 53435u, 52300u, 51174u, 50059u, 48954u, 47859u, 46774u, 45699u, 44633u, 43578u, 42533u, 41497u, 40471u, 39454u, 38447u, 37449u, 36460u, 35481u, 34511u, 33550u, 32599u, 31656u, 30722u, 29797u, 28881u, 27974u, 27075u, 26185u, 25304u, 24431u, 23567u, 22710u, 21863u, 21023u, 20192u, 19368u, 18553u, 17746u, 16947u, 16155u, 15372u, 14596u, 13828u, 13068u, 12315u, 11570u, 10832u, 10101u, 9378u, 8663u, 7954u, 7253u},
 /* T=313K (39.9C) */   {57895u, 56756u, 55627u, 54508u, 53399u, 52300u, 51210u, 50130u, 49059u, 47998u, 46946u, 45904u, 44871u, 43847u, 42832u, 41827u, 40830u, 39842u, 38864u, 37894u, 36933u, 35981u, 35037u, 34102u, 33175u, 32257u, 31348u, 30447u, 29554u, 28669u, 27792u, 26924u, 26064u, 25212u, 24367u, 23531u, 22702u, 21881u, 21068u, 20263u, 19465u, 18675u, 17892u, 17117u, 16349u, 15589u, 14836u, 14090u, 13351u, 12619u, 11895u, 11177u, 10467u, 9763u, 9067u, 8377u},
 /* T=323K (49.9C) */   {57718u, 56616u, 55523u, 54439u, 53365u, 52300u, 51243u, 50196u, 49158u, 48129u, 47108u, 46097u, 45094u, 44100u, 43114u, 42137u, 41168u, 40208u, 39257u, 38313u, 37378u, 36451u, 35533u, 34622u, 33719u, 32825u, 31938u, 31059u, 30189u, 29325u, 28470u, 27622u, 26782u, 25950u, 25125u, 24307u, 23497u, 22695u, 21899u, 21111u, 20330u, 19556u, 18790u, 18030u, 17277u, 16532u, 15793u, 15061u, 14336u, 13618u, 12906u, 12201u, 11503u, 10811u, 10126u, 9447u},
  },
  { /* QNH=100400 Pa */
 /* T=263K (-10.1C) */   {59093u, 57726u, 56374u, 55035u, 53710u, 52400u, 51102u, 49819u, 48549u, 47292u, 46049u, 44819u, 43601u, 42397u, 41206u, 40027u, 38861u, 37708u, 36567u, 35438u, 34322u, 33218u, 32125u, 31045u, 29977u, 28920u, 27875u, 26841u, 25819u, 24808u, 23808u, 22820u, 21842u, 20876u, 19920u, 18975u, 18041u, 17118u, 16204u, 15302u, 14409u, 13527u, 12655u, 11793u, 10941u, 10099u, 9266u, 8443u, 7630u, 6826u, 6032u, 5247u, 4472u, 3705u, 2948u, 2199u},
 /* T=273K (-0.1C) */   {58842u, 57527u, 56226u, 54937u, 53662u, 52400u, 51150u, 49912u, 48688u, 47475u, 46276u, 45088u, 43912u, 42749u, 41597u, 40458u, 39330u, 38214u, 37109u, 36016u, 34934u, 33863u, 32804u, 31756u, 30719u, 29693u, 28678u, 27673u, 26679u, 25696u, 24723u, 23761u, 22809u, 21867u, 20936u, 20014u, 19103u, 18201u, 17310u, 16428u, 15555u, 14693u, 13839u, 12996u, 12161u, 11336u, 10520u, 9713u, 8915u, 8126u, 7346u, 6575u, 5813u, 5059u, 4314u, 3577u},
 /* T=283K (9.9C) */   {58608u, 57342u, 56089u, 54847u, 53617u, 52400u, 51194u, 49999u, 48817u, 47646u, 46487u, 45339u, 44202u, 43077u, 41962u, 40859u, 39767u, 38685u, 37615u, 36555u, 35506u, 34467u, 33439u, 32421u, 31414u, 30417u, 29430u, 28453u, 27486u, 26529u, 25582u, 24645u, 23717u, 22799u, 21890u, 20991u, 20102u, 19221u, 18350u, 17488u, 16635u, 15792u, 14957u, 14131u, 13313u, 12505u, 11705u, 10914u, 10131u, 9357u, 8591u, 7833u, 7084u, 6343u, 5609u, 4884u},
 /* T=293K (19.9C) */   {58392u, 57171u, 55961u, 54763u, 53575u, 52400u, 51235u, 50081u, 48938u, 47805u, 46684u, 45573u, 44473u, 43383u, 42303u, 41234u, 40176u, 39127u, 38089u, 37060u, 36042u, 35033u, 34034u, 33045u, 32066u, 31096u, 30136u, 29186u, 28244u, 27312u, 26390u, 25476u, 24572u, 23676u, 22790u, 21912u, 21043u, 20183u, 19332u, 18489u, 17655u, 16830u, 16013u, 15204u, 14403u, 13611u, 12827u, 12051u, 11283u, 10523u, 9771u, 9026u, 8290u, 7561u, 6840u, 6127u},
 /* T=303K (29.9C) */   {58189u, 57010u, 55842u, 54684u, 53536u, 52400u, 51273u, 50156u, 49050u, 47954u, 46868u, 45792u, 44726u, 43669u, 42623u, 41586u, 40559u, 39541u, 38533u, 37534u, 36545u, 35564u, 34594u, 33632u, 32679u, 31735u, 30801u, 29875u, 28958u, 28050u, 27150u, 26259u, 25377u, 24503u, 23638u, 22781u, 21932u, 21092u, 20260u, 19436u, 18620u, 17812u, 17012u, 16219u, 15435u, 14659u, 13890u, 13129u, 12375u, 11629u, 10890u, 10159u, 9436u, 8719u, 8010u, 7308u},
 /* T=313K (39.9C) */   {58000u, 56860u, 55730u, 54610u, 53500u, 52400u, 51309u, 50227u, 49156u, 48094u, 47041u, 45997u, 44963u, 43939u, 42923u, 41916u, 40919u, 39930u, 38950u, 37980u, 37018u, 36064u, 35120u, 34184u, 33256u, 32337u, 31427u, 30525u, 29631u, 28745u, 27868u, 26999u, 26138u, 25285u, 24439u, 23602u, 22773u, 21951u, 21137u, 20331u, 19533u, 18742u, 17958u, 17182u, 16414u, 15652u, 14898u, 14152u, 13412u, 12680u, 11955u, 11236u, 10525u, 9821u, 9123u, 8433u},
 /* T=323K (49.9C) */   {57823u, 56720u, 55626u, 54541u, 53466u, 52400u, 51342u, 50294u, 49255u, 48225u, 47203u, 46191u, 45187u, 44191u, 43205u, 42227u, 41257u, 40296u, 39344u, 38399u, 37463u, 36535u, 35616u, 34704u, 33801u, 32905u, 32018u, 31138u, 30267u, 29403u, 28546u, 27698u, 26857u, 26024u, 25198u, 24379u, 23569u, 22765u, 21969u, 21180u, 20398u, 19624u, 18856u, 18096u, 17342u, 16596u, 15857u, 15124u, 14398u, 13679u, 12967u, 12261u, 11562u, 10870u, 10184u, 9505u},
  },
  { /* QNH=100500 Pa */
 /* T=263K (-10.1C) */   {59200u, 57832u, 56478u, 55138u, 53812u, 52500u, 51201u, 49916u, 48645u, 47387u, 46143u, 44911u, 43693u, 42487u, 41295u, 40115u, 38948u, 37793u, 36651u, 35522u, 34404u, 33299u, 32205u, 31124u, 30054u, 28996u, 27950u, 26916u, 25892u, 24880u, 23880u, 22890u, 21912u, 20944u, 19988u, 19042u, 18107u, 17182u, 16268u, 15365u, 14471u, 13588u, 12715u, 11852u, 10999u, 10156u, 9323u, 8499u, 7685u, 6881u, 6086u, 5300u, 4524u, 3757u, 2998u, 2249u},
 /* T=273K (-0.1C) */   {58948u, 57632u, 56330u, 55040u, 53763u, 52500u, 51248u, 50010u, 48784u, 47571u, 46369u, 45181u, 44004u, 42839u, 41687u, 40546u, 39417u, 38299u, 37194u, 36099u, 35017u, 33945u, 32885u, 31836u, 30797u, 29770u, 28754u, 27748u, 26754u, 25769u, 24796u, 23832u, 22880u, 21937u, 21004u, 20082u, 19170u, 18267u, 17375u, 16492u, 15619u, 14755u, 13901u, 13056u, 12221u, 11395u, 10578u, 9771u, 8972u, 8182u, 7401u, 6630u, 5866u, 5112u, 4366u, 3628u},
 /* T=283K (9.9C) */   {58715u, 57447u, 56192u, 54949u, 53718u, 52500u, 51292u, 50097u, 48913u, 47741u, 46581u, 45432u, 44294u, 43167u, 42052u, 40948u, 39854u, 38772u, 37700u, 36639u, 35589u, 34549u, 33520u, 32502u, 31493u, 30495u, 29507u, 28529u, 27561u, 26603u, 25655u, 24717u, 23788u, 22869u, 21960u, 21060u, 20170u, 19288u, 18416u, 17554u, 16700u, 15855u, 15019u, 14193u, 13375u, 12565u, 11765u, 10973u, 10189u, 9414u, 8647u, 7889u, 7139u, 6397u, 5663u, 4937u},
 /* T=293K (19.9C) */   {58497u, 57275u, 56064u, 54865u, 53677u, 52500u, 51333u, 50178u, 49034u, 47901u, 46778u, 45666u, 44565u, 43474u, 42393u, 41323u, 40263u, 39214u, 38174u, 37145u, 36125u, 35116u, 34116u, 33126u, 32146u, 31175u, 30214u, 29262u, 28320u, 27387u, 26464u, 25549u, 24644u, 23747u, 22860u, 21982u, 21112u, 20251u, 19399u, 18556u, 17721u, 16894u, 16076u, 15267u, 14465u, 13672u, 12887u, 12111u, 11342u, 10581u, 9828u, 9083u, 8346u, 7616u, 6895u, 6180u},
 /* T=303K (29.9C) */   {58295u, 57115u, 55945u, 54786u, 53638u, 52500u, 51372u, 50254u, 49147u, 48050u, 46963u, 45885u, 44818u, 43761u, 42713u, 41675u, 40647u, 39628u, 38619u, 37619u, 36629u, 35648u, 34676u, 33713u, 32759u, 31815u, 30879u, 29953u, 29035u, 28125u, 27225u, 26333u, 25450u, 24575u, 23709u, 22851u, 22002u, 21161u, 20328u, 19503u, 18686u, 17877u, 17076u, 16283u, 15498u, 14721u, 13951u, 13189u, 12435u, 11688u, 10949u, 10217u, 9493u, 8776u, 8066u, 7363u},
 /* T=313K (39.9C) */   {58106u, 56965u, 55834u, 54712u, 53601u, 52500u, 51408u, 50325u, 49253u, 48189u, 47136u, 46091u, 45056u, 44030u, 43013u, 42006u, 41007u, 40018u, 39037u, 38065u, 37102u, 36148u, 35203u, 34266u, 33337u, 32417u, 31506u, 30603u, 29708u, 28822u, 27944u, 27073u, 26211u, 25357u, 24512u, 23673u, 22843u, 22021u, 21206u, 20399u, 19600u, 18808u, 18024u, 17247u, 16478u, 15716u, 14961u, 14214u, 13473u, 12740u, 12014u, 11295u, 10583u, 9878u, 9180u, 8489u},
 /* T=323K (49.9C) */   {57928u, 56824u, 55729u, 54643u, 53567u, 52500u, 51441u, 50392u, 49352u, 48320u, 47298u, 46284u, 45280u, 44283u, 43296u, 42317u, 41346u, 40384u, 39431u, 38485u, 37548u, 36620u, 35699u, 34787u, 33882u, 32986u, 32098u, 31217u, 30344u, 29480u, 28623u, 27773u, 26931u, 26097u, 25271u, 24452u, 23640u, 22836u, 22039u, 21249u, 20466u, 19691u, 18923u, 18162u, 17408u, 16660u, 15920u, 15187u, 14460u, 13741u, 13028u, 12321u, 11622u, 10929u, 10242u, 9562u},
  },
  { /* QNH=100600 Pa */
 /* T=263K (-10.1C) */   {59306u, 57937u, 56581u, 55240u, 53913u, 52600u, 51300u, 50014u, 48741u, 47482u, 46236u, 45004u, 43784u, 42577u, 41384u, 40203u, 39034u, 37879u, 36736u, 35605u, 34486u, 33380u, 32285u, 31203u, 30132u, 29073u, 28026u, 26990u, 25966u, 24953u, 23951u, 22961u, 21981u, 21013u, 20056u, 19109u, 18173u, 17247u, 16332u, 15428u, 14534u, 13650u, 12776u, 11912u, 11058u, 10214u, 9380u, 8556u, 7741u, 6936u, 6140u, 5353u, 4576u, 3808u, 3049u, 2299u},
 /* T=273K (-0.1C) */   {59054u, 57737u, 56433u, 55143u, 53865u, 52600u, 51347u, 50107u, 48880u, 47666u, 46463u, 45273u, 44095u, 42930u, 41776u, 40634u, 39504u, 38385u, 37278u, 36183u, 35099u, 34027u, 32965u, 31915u, 30876u, 29848u, 28830u, 27824u, 26828u, 25843u, 24868u, 23904u, 22950u, 22006u, 21073u, 20150u, 19236u, 18333u, 17440u, 16556u, 15682u, 14817u, 13963u, 13117u, 12281u, 11454u, 10637u, 9828u, 9029u, 8238u, 7457u, 6684u, 5920u, 5165u, 4418u, 3680u},
 /* T=283K (9.9C) */   {58821u, 57552u, 56296u, 55052u, 53820u, 52600u, 51391u, 50195u, 49010u, 47837u, 46675u, 45525u, 44386u, 43258u, 42141u, 41036u, 39942u, 38858u, 37785u, 36723u, 35672u, 34632u, 33601u, 32582u, 31572u, 30573u, 29584u, 28605u, 27637u, 26678u, 25729u, 24789u, 23860u, 22940u, 22030u, 21129u, 20237u, 19355u, 18482u, 17619u, 16764u, 15919u, 15082u, 14254u, 13436u, 12625u, 11824u, 11031u, 10247u, 9471u, 8704u, 7944u, 7193u, 6451u, 5716u, 4990u},
 /* T=293K (19.9C) */   {58603u, 57380u, 56168u, 54967u, 53778u, 52600u, 51432u, 50276u, 49131u, 47996u, 46872u, 45759u, 44657u, 43565u, 42483u, 41412u, 40351u, 39301u, 38260u, 37230u, 36209u, 35199u, 34198u, 33207u, 32226u, 31254u, 30292u, 29339u, 28396u, 27462u, 26538u, 25622u, 24716u, 23819u, 22931u, 22051u, 21181u, 20319u, 19466u, 18622u, 17786u, 16959u, 16140u, 15330u, 14527u, 13734u, 12948u, 12170u, 11401u, 10639u, 9886u, 9140u, 8402u, 7672u, 6949u, 6234u},
 /* T=303K (29.9C) */   {58401u, 57219u, 56049u, 54888u, 53739u, 52600u, 51471u, 50352u, 49244u, 48145u, 47057u, 45979u, 44911u, 43852u, 42803u, 41764u, 40735u, 39715u, 38705u, 37704u, 36713u, 35731u, 34758u, 33794u, 32840u, 31894u, 30958u, 30030u, 29111u, 28201u, 27300u, 26407u, 25523u, 24648u, 23781u, 22922u, 22072u, 21229u, 20396u, 19570u, 18752u, 17943u, 17141u, 16347u, 15561u, 14783u, 14013u, 13250u, 12495u, 11748u, 11008u, 10275u, 9550u, 8832u, 8122u, 7418u},
 /* T=313K (39.9C) */   {58211u, 57069u, 55937u, 54815u, 53702u, 52600u, 51506u, 50423u, 49349u, 48285u, 47230u, 46185u, 45149u, 44122u, 43104u, 42095u, 41096u, 40105u, 39124u, 38151u, 37187u, 36232u, 35285u, 34347u, 33418u, 32497u, 31585u, 30681u, 29786u, 28898u, 28019u, 27148u, 26285u, 25430u, 24584u, 23745u, 22914u, 22090u, 21275u, 20467u, 19667u, 18875u, 18090u, 17312u, 16542u, 15779u, 15024u, 14276u, 13535u, 12801u, 12074u, 11354u, 10642u, 9936u, 9237u, 8545u},
 /* T=323K (49.9C) */   {58034u, 56928u, 55832u, 54746u, 53668u, 52600u, 51540u, 50490u, 49449u, 48416u, 47393u, 46378u, 45372u, 44375u, 43387u, 42407u, 41435u, 40472u, 39518u, 38571u, 37634u, 36704u, 35782u, 34869u, 33964u, 33067u, 32177u, 31296u, 30422u, 29557u, 28699u, 27849u, 27006u, 26171u, 25344u, 24524u, 23711u, 22906u, 22108u, 21318u, 20534u, 19758u, 18989u, 18227u, 17473u, 16725u, 15984u, 15250u, 14523u, 13802u, 13088u, 12381u, 11681u, 10987u, 10300u, 9619u},
  },
  { /* QNH=100700 Pa */
 /* T=263K (-10.1C) */   {59413u, 58042u, 56685u, 55343u, 54014u, 52700u, 51399u, 50111u, 48837u, 47577u, 46330u, 45096u, 43875u, 42667u, 41473u, 40290u, 39121u, 37964u, 36820u, 35688u, 34568u, 33460u, 32365u, 31281u, 30210u, 29150u, 28101u, 27065u, 26039u, 25025u, 24023u, 23031u, 22051u, 21082u, 20123u, 19175u, 18239u, 17312u, 16396u, 15491u, 14596u, 13711u, 12836u, 11972u, 11117u, 10272u, 9437u, 8612u, 7796u, 6990u, 6194u, 5406u, 4628u, 3860u, 3100u, 2349u},
 /* T=273K (-0.1C) */   {59161u, 57842u, 56537u, 55245u, 53966u, 52700u, 51446u, 50205u, 48977u, 47761u, 46557u, 45366u, 44187u, 43020u, 41865u, 40722u, 39591u, 38471u, 37363u, 36267u, 35182u, 34108u, 33046u, 31994u, 30954u, 29925u, 28907u, 27899u, 26902u, 25916u, 24941u, 23975u, 23021u, 22076u, 21142u, 20217u, 19303u, 18399u, 17505u, 16620u, 15745u, 14880u, 14024u, 13178u, 12341u, 11513u, 10695u, 9886u, 9085u, 8294u, 7512u, 6738u, 5973u, 5217u, 4470u, 3731u},
 /* T=283K (9.9C) */   {58927u, 57657u, 56400u, 55154u, 53921u, 52700u, 51490u, 50292u, 49106u, 47932u, 46769u, 45618u, 44477u, 43349u, 42231u, 41125u, 40029u, 38944u, 37871u, 36808u, 35755u, 34714u, 33683u, 32662u, 31651u, 30651u, 29661u, 28681u, 27712u, 26752u, 25802u, 24862u, 23931u, 23011u, 22099u, 21198u, 20305u, 19422u, 18549u, 17684u, 16829u, 15982u, 15145u, 14316u, 13497u, 12686u, 11884u, 11090u, 10305u, 9528u, 8760u, 8000u, 7248u, 6505u, 5770u, 5042u},
 /* T=293K (19.9C) */   {58709u, 57485u, 56272u, 55070u, 53879u, 52700u, 51531u, 50374u, 49227u, 48092u, 46967u, 45852u, 44749u, 43656u, 42573u, 41501u, 40439u, 39387u, 38346u, 37314u, 36293u, 35281u, 34280u, 33288u, 32305u, 31333u, 30370u, 29416u, 28472u, 27537u, 26612u, 25696u, 24788u, 23890u, 23001u, 22121u, 21250u, 20387u, 19533u, 18688u, 17851u, 17023u, 16204u, 15393u, 14590u, 13795u, 13009u, 12230u, 11460u, 10698u, 9943u, 9197u, 8458u, 7727u, 7004u, 6288u},
 /* T=303K (29.9C) */   {58507u, 57324u, 56152u, 54991u, 53840u, 52700u, 51569u, 50450u, 49340u, 48241u, 47152u, 46072u, 45003u, 43943u, 42894u, 41854u, 40823u, 39803u, 38791u, 37790u, 36797u, 35814u, 34840u, 33876u, 32920u, 31974u, 31036u, 30108u, 29188u, 28277u, 27375u, 26481u, 25596u, 24720u, 23852u, 22992u, 22141u, 21298u, 20464u, 19637u, 18819u, 18008u, 17206u, 16411u, 15625u, 14846u, 14075u, 13311u, 12555u, 11807u, 11066u, 10333u, 9607u, 8889u, 8177u, 7473u},
 /* T=313K (39.9C) */   {58317u, 57174u, 56040u, 54917u, 53803u, 52700u, 51605u, 50521u, 49446u, 48381u, 47325u, 46278u, 45241u, 44213u, 43194u, 42185u, 41184u, 40193u, 39210u, 38237u, 37272u, 36316u, 35368u, 34429u, 33499u, 32577u, 31664u, 30759u, 29863u, 28975u, 28095u, 27223u, 26359u, 25503u, 24656u, 23816u, 22984u, 22160u, 21344u, 20535u, 19734u, 18941u, 18155u, 17377u, 16606u, 15843u, 15086u, 14337u, 13596u, 12861u, 12134u, 11413u, 10700u, 9994u, 9294u, 8601u},
 /* T=323K (49.9C) */   {58139u, 57033u, 55936u, 54848u, 53769u, 52700u, 51639u, 50588u, 49546u, 48512u, 47488u, 46472u, 45465u, 44467u, 43477u, 42496u, 41524u, 40560u, 39605u, 38657u, 37719u, 36788u, 35866u, 34951u, 34045u, 33147u, 32257u, 31375u, 30500u, 29634u, 28775u, 27924u, 27081u, 26245u, 25417u, 24596u, 23782u, 22976u, 22178u, 21387u, 20603u, 19826u, 19056u, 18293u, 17538u, 16789u, 16047u, 15313u, 14585u, 13864u, 13149u, 12441u, 11740u, 11046u, 10358u, 9677u},
  },
  { /* QNH=100800 Pa */
 /* T=263K (-10.1C) */   {59520u, 58147u, 56789u, 55445u, 54116u, 52800u, 51497u, 50209u, 48933u, 47672u, 46424u, 45188u, 43966u, 42757u, 41561u, 40378u, 39208u, 38050u, 36904u, 35771u, 34650u, 33541u, 32445u, 31360u, 30287u, 29226u, 28177u, 27139u, 26113u, 25098u, 24094u, 23102u, 22121u, 21150u, 20191u, 19242u, 18304u, 17377u, 16460u, 15554u, 14658u, 13772u, 12897u, 12031u, 11176u, 10330u, 9494u, 8668u, 7852u, 7045u, 6247u, 5459u, 4681u, 3911u, 3151u, 2399u},
 /* T=273K (-0.1C) */   {59267u, 57948u, 56641u, 55348u, 54067u, 52800u, 51545u, 50303u, 49073u, 47856u, 46651u, 45459u, 44279u, 43110u, 41954u, 40810u, 39678u, 38557u, 37448u, 36350u, 35264u, 34190u, 33126u, 32074u, 31033u, 30002u, 28983u, 27975u, 26977u, 25990u, 25013u, 24047u, 23091u, 22146u, 21210u, 20285u, 19370u, 18465u, 17570u, 16684u, 15808u, 14942u, 14086u, 13239u, 12401u, 11572u, 10753u, 9943u, 9142u, 8350u, 7567u, 6793u, 6027u, 5270u, 4522u, 3782u},
 /* T=283K (9.9C) */   {59033u, 57762u, 56503u, 55257u, 54022u, 52800u, 51589u, 50390u, 49203u, 48027u, 46863u, 45711u, 44569u, 43439u, 42321u, 41213u, 40116u, 39031u, 37956u, 36892u, 35839u, 34796u, 33764u, 32742u, 31730u, 30729u, 29738u, 28758u, 27787u, 26826u, 25875u, 24934u, 24003u, 23081u, 22169u, 21266u, 20373u, 19489u, 18615u, 17749u, 16893u, 16046u, 15208u, 14378u, 13558u, 12746u, 11943u, 11149u, 10363u, 9585u, 8816u, 8056u, 7303u, 6559u, 5823u, 5095u},
 /* T=293K (19.9C) */   {58815u, 57590u, 56375u, 55172u, 53980u, 52800u, 51630u, 50471u, 49324u, 48187u, 47061u, 45946u, 44841u, 43747u, 42663u, 41590u, 40527u, 39474u, 38432u, 37399u, 36377u, 35364u, 34361u, 33368u, 32385u, 31412u, 30448u, 29493u, 28548u, 27612u, 26686u, 25769u, 24861u, 23962u, 23072u, 22191u, 21318u, 20455u, 19600u, 18754u, 17917u, 17088u, 16268u, 15456u, 14652u, 13856u, 13069u, 12290u, 11519u, 10756u, 10001u, 9254u, 8514u, 7782u, 7058u, 6342u},
 /* T=303K (29.9C) */   {58612u, 57429u, 56255u, 55093u, 53941u, 52800u, 51668u, 50547u, 49437u, 48336u, 47246u, 46166u, 45095u, 44035u, 42984u, 41943u, 40912u, 39890u, 38878u, 37875u, 36881u, 35897u, 34923u, 33957u, 33001u, 32053u, 31115u, 30185u, 29265u, 28353u, 27450u, 26555u, 25669u, 24792u, 23923u, 23063u, 22211u, 21367u, 20532u, 19704u, 18885u, 18074u, 17271u, 16475u, 15688u, 14908u, 14136u, 13372u, 12616u, 11867u, 11125u, 10391u, 9664u, 8945u, 8233u, 7528u},
 /* T=313K (39.9C) */   {58422u, 57278u, 56144u, 55019u, 53904u, 52800u, 51704u, 50619u, 49543u, 48476u, 47420u, 46372u, 45334u, 44305u, 43285u, 42274u, 41273u, 40280u, 39297u, 38322u, 37356u, 36399u, 35451u, 34511u, 33580u, 32657u, 31743u, 30838u, 29940u, 29051u, 28170u, 27298u, 26433u, 25576u, 24728u, 23887u, 23055u, 22230u, 21413u, 20603u, 19802u, 19007u, 18221u, 17442u, 16670u, 15906u, 15149u, 14399u, 13657u, 12922u, 12193u, 11472u, 10758u, 10051u, 9351u, 8658u},
 /* T=323K (49.9C) */   {58245u, 57137u, 56039u, 54950u, 53870u, 52800u, 51738u, 50686u, 49642u, 48608u, 47583u, 46566u, 45558u, 44559u, 43568u, 42586u, 41613u, 40648u, 39692u, 38744u, 37804u, 36872u, 35949u, 35034u, 34127u, 33228u, 32337u, 31454u, 30578u, 29711u, 28851u, 27999u, 27155u, 26319u, 25489u, 24668u, 23854u, 23047u, 22248u, 21456u, 20671u, 19893u, 19123u, 18359u, 17603u, 16853u, 16111u, 15376u, 14647u, 13925u, 13210u, 12501u, 11800u, 11105u, 10416u, 9734u},
  },
  { /* QNH=100900 Pa */
 /* T=263K (-10.1C) */   {59626u, 58253u, 56893u, 55548u, 54217u, 52900u, 51596u, 50306u, 49030u, 47767u, 46517u, 45281u, 44058u, 42848u, 41650u, 40466u, 39294u, 38135u, 36988u, 35854u, 34732u, 33622u, 32524u, 31439u, 30365u, 29303u, 28253u, 27214u, 26186u, 25171u, 24166u, 23172u, 22190u, 21219u, 20258u, 19309u, 18370u, 17442u, 16524u, 15617u, 14720u, 13833u, 12957u, 12091u, 11234u, 10388u, 9551u, 8724u, 7907u, 7099u, 6301u, 5512u, 4733u, 3963u, 3201u, 2449u},
 /* T=273K (-0.1C) */   {59374u, 58053u, 56745u, 55450u, 54168u, 52900u, 51643u, 50400u, 49169u, 47951u, 46745u, 45551u, 44370u, 43201u, 42044u, 40898u, 39765u, 38643u, 37533u, 36434u, 35347u, 34271u, 33207u, 32153u, 31111u, 30080u, 29059u, 28050u, 27051u, 26063u, 25085u, 24118u, 23162u, 22215u, 21279u, 20353u, 19437u, 18531u, 17635u, 16748u, 15872u, 15005u, 14147u, 13299u, 12461u, 11631u, 10811u, 10001u, 9199u, 8406u, 7622u, 6847u, 6081u, 5323u, 4574u, 3834u},
 /* T=283K (9.9C) */   {59139u, 57867u, 56607u, 55359u, 54123u, 52900u, 51688u, 50488u, 49299u, 48122u, 46957u, 45804u, 44661u, 43530u, 42410u, 41302u, 40204u, 39117u, 38041u, 36976u, 35922u, 34878u, 33845u, 32822u, 31810u, 30807u, 29816u, 28834u, 27862u, 26900u, 25948u, 25006u, 24074u, 23152u, 22239u, 21335u, 20441u, 19556u, 18681u, 17814u, 16957u, 16109u, 15270u, 14440u, 13619u, 12806u, 12002u, 11207u, 10421u, 9642u, 8873u, 8111u, 7358u, 6613u, 5876u, 5148u},
 /* T=293K (19.9C) */   {58921u, 57694u, 56479u, 55274u, 54081u, 52900u, 51729u, 50569u, 49420u, 48282u, 47155u, 46039u, 44933u, 43838u, 42753u, 41679u, 40615u, 39561u, 38517u, 37484u, 36460u, 35447u, 34443u, 33449u, 32465u, 31490u, 30525u, 29570u, 28624u, 27687u, 26760u, 25842u, 24933u, 24033u, 23142u, 22260u, 21387u, 20523u, 19667u, 18821u, 17982u, 17153u, 16331u, 15518u, 14714u, 13918u, 13130u, 12350u, 11578u, 10814u, 10058u, 9310u, 8570u, 7838u, 7113u, 6396u},
 /* T=303K (29.9C) */   {58718u, 57533u, 56359u, 55195u, 54042u, 52900u, 51767u, 50645u, 49534u, 48432u, 47341u, 46259u, 45188u, 44126u, 43074u, 42032u, 41000u, 39977u, 38964u, 37960u, 36966u, 35981u, 35005u, 34038u, 33081u, 32133u, 31193u, 30263u, 29341u, 28428u, 27524u, 26629u, 25742u, 24864u, 23995u, 23133u, 22280u, 21436u, 20600u, 19771u, 18951u, 18139u, 17335u, 16539u, 15751u, 14971u, 14198u, 13433u, 12676u, 11926u, 11184u, 10449u, 9722u, 9002u, 8289u, 7583u},
 /* T=313K (39.9C) */   {58528u, 57383u, 56247u, 55121u, 54005u, 52900u, 51803u, 50717u, 49640u, 48572u, 47514u, 46466u, 45426u, 44396u, 43376u, 42364u, 41361u, 40368u, 39383u, 38408u, 37441u, 36483u, 35534u, 34593u, 33661u, 32737u, 31822u, 30916u, 30018u, 29128u, 28246u, 27372u, 26507u, 25649u, 24800u, 23959u, 23125u, 22299u, 21482u, 20671u, 19869u, 19074u, 18287u, 17507u, 16734u, 15969u, 15212u, 14461u, 13718u, 12982u, 12253u, 11531u, 10817u, 10109u, 9408u, 8714u},
 /* T=323K (49.9C) */   {58350u, 57241u, 56142u, 55052u, 53971u, 52900u, 51837u, 50784u, 49739u, 48704u, 47677u, 46660u, 45651u, 44651u, 43659u, 42676u, 41702u, 40736u, 39779u, 38830u, 37889u, 36956u, 36032u, 35116u, 34208u, 33308u, 32416u, 31532u, 30656u, 29788u, 28928u, 28075u, 27230u, 26392u, 25562u, 24740u, 23925u, 23117u, 22317u, 21524u, 20739u, 19960u, 19189u, 18425u, 17668u, 16918u, 16175u, 15438u, 14709u, 13986u, 13271u, 12561u, 11859u, 11163u, 10474u, 9791u},
  },
  { /* QNH=101000 Pa */
 /* T=263K (-10.1C) */   {59733u, 58358u, 56997u, 55651u, 54318u, 53000u, 51695u, 50403u, 49126u, 47862u, 46611u, 45373u, 44149u, 42938u, 41739u, 40553u, 39381u, 38220u, 37072u, 35937u, 34814u, 33703u, 32604u, 31517u, 30443u, 29379u, 28328u, 27288u, 26260u, 25243u, 24237u, 23243u, 22260u, 21287u, 20326u, 19376u, 18436u, 17507u, 16588u, 15680u, 14782u, 13895u, 13017u, 12150u, 11293u, 10446u, 9608u, 8781u, 7963u, 7154u, 6355u, 5565u, 4785u, 4014u, 3252u, 2499u},
 /* T=273K (-0.1C) */   {59480u, 58158u, 56849u, 55553u, 54270u, 53000u, 51742u, 50498u, 49266u, 48046u, 46839u, 45644u, 44462u, 43291u, 42133u, 40986u, 39852u, 38729u, 37617u, 36518u, 35430u, 34353u, 33287u, 32233u, 31189u, 30157u, 29136u, 28125u, 27126u, 26136u, 25158u, 24190u, 23232u, 22285u, 21348u, 20421u, 19504u, 18597u, 17700u, 16813u, 15935u, 15067u, 14209u, 13360u, 12521u, 11691u, 10870u, 10058u, 9255u, 8462u, 7677u, 6901u, 6134u, 5376u, 4626u, 3885u},
 /* T=283K (9.9C) */   {59246u, 57972u, 56711u, 55462u, 54225u, 53000u, 51786u, 50585u, 49396u, 48218u, 47051u, 45896u, 44753u, 43621u, 42500u, 41390u, 40291u, 39203u, 38127u, 37060u, 36005u, 34960u, 33926u, 32902u, 31889u, 30886u, 29893u, 28910u, 27937u, 26975u, 26022u, 25079u, 24146u, 23222u, 22308u, 21404u, 20509u, 19623u, 18747u, 17880u, 17022u, 16173u, 15333u, 14502u, 13680u, 12867u, 12062u, 11266u, 10478u, 9700u, 8929u, 8167u, 7413u, 6667u, 5930u, 5200u},
 /* T=293K (19.9C) */   {59027u, 57799u, 56582u, 55377u, 54183u, 53000u, 51828u, 50667u, 49517u, 48378u, 47250u, 46132u, 45025u, 43929u, 42843u, 41768u, 40702u, 39648u, 38603u, 37568u, 36544u, 35529u, 34525u, 33530u, 32545u, 31569u, 30603u, 29647u, 28700u, 27762u, 26834u, 25915u, 25005u, 24104u, 23213u, 22330u, 21456u, 20591u, 19734u, 18887u, 18048u, 17217u, 16395u, 15581u, 14776u, 13979u, 13190u, 12410u, 11637u, 10872u, 10116u, 9367u, 8626u, 7893u, 7168u, 6450u},
 /* T=303K (29.9C) */   {58824u, 57638u, 56462u, 55298u, 54143u, 53000u, 51866u, 50743u, 49630u, 48528u, 47435u, 46352u, 45280u, 44217u, 43164u, 42121u, 41088u, 40064u, 39050u, 38045u, 37050u, 36064u, 35087u, 34120u, 33161u, 32212u, 31272u, 30340u, 29418u, 28504u, 27599u, 26703u, 25816u, 24937u, 24066u, 23204u, 22350u, 21505u, 20668u, 19839u, 19018u, 18205u, 17400u, 16603u, 15814u, 15033u, 14260u, 13494u, 12736u, 11985u, 11242u, 10507u, 9779u, 9058u, 8345u, 7639u},
 /* T=313K (39.9C) */   {58634u, 57487u, 56350u, 55223u, 54107u, 53000u, 51902u, 50814u, 49736u, 48668u, 47609u, 46559u, 45519u, 44488u, 43466u, 42454u, 41450u, 40456u, 39470u, 38493u, 37526u, 36567u, 35616u, 34675u, 33742u, 32817u, 31902u, 30994u, 30095u, 29204u, 28321u, 27447u, 26581u, 25722u, 24872u, 24030u, 23196u, 22369u, 21550u, 20739u, 19936u, 19140u, 18352u, 17572u, 16798u, 16033u, 15274u, 14523u, 13779u, 13043u, 12313u, 11590u, 10875u, 10166u, 9465u, 8770u},
 /* T=323K (49.9C) */   {58455u, 57346u, 56245u, 55154u, 54072u, 53000u, 51936u, 50882u, 49836u, 48800u, 47772u, 46753u, 45744u, 44742u, 43750u, 42766u, 41791u, 40824u, 39866u, 38916u, 37974u, 37041u, 36116u, 35199u, 34290u, 33389u, 32496u, 31611u, 30734u, 29865u, 29004u, 28150u, 27304u, 26466u, 25635u, 24812u, 23996u, 23188u, 22387u, 21593u, 20807u, 20028u, 19256u, 18491u, 17733u, 16982u, 16238u, 15501u, 14771u, 14048u, 13331u, 12621u, 11918u, 11222u, 10532u, 9848u},
  },
  { /* QNH=101100 Pa */
 /* T=263K (-10.1C) */   {59840u, 58463u, 57101u, 55753u, 54419u, 53100u, 51793u, 50501u, 49222u, 47957u, 46705u, 45466u, 44240u, 43028u, 41828u, 40641u, 39467u, 38306u, 37157u, 36020u, 34896u, 33784u, 32684u, 31596u, 30520u, 29456u, 28404u, 27363u, 26333u, 25316u, 24309u, 23314u, 22329u, 21356u, 20394u, 19442u, 18502u, 17572u, 16652u, 15743u, 14844u, 13956u, 13078u, 12210u, 11352u, 10504u, 9665u, 8837u, 8018u, 7209u, 6409u, 5618u, 4837u, 4066u, 3303u, 2549u},
 /* T=273K (-0.1C) */   {59587u, 58263u, 56952u, 55655u, 54371u, 53100u, 51841u, 50595u, 49362u, 48141u, 46933u, 45737u, 44553u, 43382u, 42222u, 41074u, 39939u, 38815u, 37702u, 36601u, 35512u, 34434u, 33368u, 32312u, 31268u, 30235u, 29212u, 28201u, 27200u, 26210u, 25230u, 24261u, 23303u, 22354u, 21416u, 20488u, 19571u, 18663u, 17765u, 16877u, 15998u, 15130u, 14270u, 13421u, 12581u, 11750u, 10928u, 10115u, 9312u, 8518u, 7732u, 6956u, 6188u, 5429u, 4678u, 3936u},
 /* T=283K (9.9C) */   {59352u, 58077u, 56814u, 55564u, 54326u, 53100u, 51885u, 50683u, 49492u, 48313u, 47145u, 45989u, 44845u, 43712u, 42589u, 41479u, 40379u, 39290u, 38212u, 37145u, 36088u, 35042u, 34007u, 32982u, 31968u, 30964u, 29970u, 28986u, 28012u, 27049u, 26095u, 25151u, 24217u, 23293u, 22378u, 21472u, 20577u, 19690u, 18813u, 17945u, 17086u, 16236u, 15396u, 14564u, 13741u, 12927u, 12121u, 11325u, 10536u, 9757u, 8985u, 8222u, 7468u, 6721u, 5983u, 5253u},
 /* T=293K (19.9C) */   {59133u, 57904u, 56686u, 55479u, 54284u, 53100u, 51926u, 50764u, 49613u, 48473u, 47344u, 46225u, 45117u, 44020u, 42933u, 41856u, 40790u, 39734u, 38689u, 37653u, 36628u, 35612u, 34606u, 33611u, 32624u, 31648u, 30681u, 29724u, 28776u, 27837u, 26908u, 25988u, 25077u, 24176u, 23283u, 22399u, 21525u, 20659u, 19802u, 18953u, 18113u, 17282u, 16459u, 15644u, 14838u, 14040u, 13251u, 12469u, 11696u, 10931u, 10173u, 9424u, 8682u, 7948u, 7222u, 6504u},
 /* T=303K (29.9C) */   {58930u, 57742u, 56566u, 55400u, 54244u, 53100u, 51965u, 50841u, 49727u, 48623u, 47529u, 46446u, 45372u, 44309u, 43255u, 42211u, 41176u, 40151u, 39136u, 38130u, 37134u, 36147u, 35169u, 34201u, 33242u, 32291u, 31350u, 30418u, 29495u, 28580u, 27674u, 26777u, 25889u, 25009u, 24137u, 23274u, 22420u, 21574u, 20736u, 19906u, 19084u, 18270u, 17465u, 16667u, 15877u, 15095u, 14321u, 13555u, 12796u, 12045u, 11301u, 10565u, 9836u, 9115u, 8400u, 7694u},
 /* T=313K (39.9C) */   {58739u, 57591u, 56454u, 55326u, 54208u, 53100u, 52001u, 50912u, 49833u, 48764u, 47704u, 46653u, 45612u, 44580u, 43557u, 42543u, 41539u, 40543u, 39557u, 38579u, 37610u, 36650u, 35699u, 34757u, 33823u, 32898u, 31981u, 31072u, 30172u, 29280u, 28397u, 27522u, 26655u, 25795u, 24944u, 24101u, 23266u, 22439u, 21619u, 20807u, 20003u, 19207u, 18418u, 17637u, 16863u, 16096u, 15337u, 14585u, 13840u, 13103u, 12373u, 11649u, 10933u, 10224u, 9522u, 8826u},
 /* T=323K (49.9C) */   {58561u, 57450u, 56348u, 55256u, 54173u, 53100u, 52035u, 50979u, 49933u, 48896u, 47867u, 46847u, 45836u, 44834u, 43841u, 42856u, 41880u, 40912u, 39953u, 39002u, 38059u, 37125u, 36199u, 35281u, 34371u, 33469u, 32576u, 31690u, 30812u, 29942u, 29080u, 28226u, 27379u, 26540u, 25708u, 24884u, 24068u, 23258u, 22457u, 21662u, 20875u, 20095u, 19322u, 18557u, 17798u, 17046u, 16302u, 15564u, 14833u, 14109u, 13392u, 12682u, 11978u, 11280u, 10590u, 9906u},
  },
  { /* QNH=101200 Pa */
 /* T=263K (-10.1C) */   {59946u, 58569u, 57205u, 55856u, 54521u, 53200u, 51892u, 50598u, 49318u, 48051u, 46798u, 45558u, 44331u, 43118u, 41917u, 40729u, 39554u, 38391u, 37241u, 36103u, 34978u, 33865u, 32764u, 31675u, 30598u, 29533u, 28479u, 27437u, 26407u, 25388u, 24380u, 23384u, 22399u, 21425u, 20461u, 19509u, 18567u, 17636u, 16716u, 15806u, 14907u, 14017u, 13138u, 12269u, 11410u, 10561u, 9722u, 8893u, 8073u, 7263u, 6463u, 5671u, 4890u, 4117u, 3354u, 2599u},
 /* T=273K (-0.1C) */   {59693u, 58368u, 57056u, 55758u, 54472u, 53200u, 51940u, 50693u, 49458u, 48236u, 47027u, 45830u, 44645u, 43472u, 42311u, 41162u, 40026u, 38900u, 37787u, 36685u, 35595u, 34516u, 33448u, 32392u, 31346u, 30312u, 29289u, 28276u, 27274u, 26283u, 25303u, 24333u, 23373u, 22424u, 21485u, 20556u, 19637u, 18729u, 17830u, 16941u, 16062u, 15192u, 14332u, 13482u, 12640u, 11809u, 10986u, 10173u, 9369u, 8574u, 7787u, 7010u, 6241u, 5482u, 4730u, 3988u},
 /* T=283K (9.9C) */   {59458u, 58182u, 56918u, 55666u, 54427u, 53200u, 51984u, 50780u, 49588u, 48408u, 47240u, 46082u, 44937u, 43802u, 42679u, 41567u, 40466u, 39376u, 38297u, 37229u, 36171u, 35124u, 34088u, 33062u, 32047u, 31042u, 30047u, 29062u, 28088u, 27123u, 26168u, 25224u, 24288u, 23363u, 22447u, 21541u, 20644u, 19757u, 18879u, 18010u, 17151u, 16300u, 15458u, 14626u, 13802u, 12987u, 12181u, 11383u, 10594u, 9814u, 9042u, 8278u, 7523u, 6776u, 6037u, 5306u},
 /* T=293K (19.9C) */   {59239u, 58009u, 56789u, 55581u, 54385u, 53200u, 52025u, 50862u, 49710u, 48569u, 47438u, 46318u, 45209u, 44111u, 43023u, 41945u, 40878u, 39821u, 38774u, 37738u, 36711u, 35695u, 34688u, 33691u, 32704u, 31727u, 30759u, 29801u, 28852u, 27912u, 26982u, 26061u, 25150u, 24247u, 23354u, 22469u, 21593u, 20727u, 19869u, 19019u, 18178u, 17346u, 16523u, 15707u, 14900u, 14102u, 13311u, 12529u, 11755u, 10989u, 10231u, 9481u, 8738u, 8004u, 7277u, 6558u},
 /* T=303K (29.9C) */   {59035u, 57847u, 56669u, 55502u, 54346u, 53200u, 52064u, 50939u, 49824u, 48719u, 47624u, 46539u, 45465u, 44400u, 43345u, 42300u, 41264u, 40239u, 39222u, 38216u, 37218u, 36230u, 35252u, 34282u, 33322u, 32371u, 31429u, 30495u, 29571u, 28656u, 27749u, 26851u, 25962u, 25081u, 24209u, 23345u, 22489u, 21642u, 20804u, 19973u, 19150u, 18336u, 17530u, 16731u, 15941u, 15158u, 14383u, 13616u, 12856u, 12104u, 11360u, 10623u, 9893u, 9171u, 8456u, 7749u},
 /* T=313K (39.9C) */   {58845u, 57696u, 56557u, 55428u, 54309u, 53200u, 52100u, 51010u, 49930u, 48859u, 47798u, 46746u, 45704u, 44671u, 43647u, 42633u, 41627u, 40631u, 39643u, 38665u, 37695u, 36734u, 35782u, 34839u, 33904u, 32978u, 32060u, 31150u, 30250u, 29357u, 28473u, 27596u, 26728u, 25868u, 25017u, 24173u, 23337u, 22508u, 21688u, 20876u, 20071u, 19273u, 18484u, 17702u, 16927u, 16160u, 15400u, 14647u, 13902u, 13163u, 12432u, 11708u, 10991u, 10282u, 9579u, 8882u},
 /* T=323K (49.9C) */   {58666u, 57554u, 56452u, 55358u, 54274u, 53200u, 52134u, 51077u, 50030u, 48991u, 47962u, 46941u, 45929u, 44926u, 43932u, 42946u, 41969u, 41000u, 40040u, 39088u, 38144u, 37209u, 36282u, 35363u, 34453u, 33550u, 32655u, 31769u, 30890u, 30019u, 29156u, 28301u, 27453u, 26613u, 25781u, 24956u, 24139u, 23329u, 22526u, 21731u, 20943u, 20162u, 19389u, 18622u, 17863u, 17111u, 16365u, 15627u, 14895u, 14171u, 13453u, 12742u, 12037u, 11339u, 10648u, 9963u},
  },
  { /* QNH=101300 Pa */
 /* T=263K (-10.1C) */   {60053u, 58674u, 57309u, 55959u, 54622u, 53300u, 51991u, 50696u, 49414u, 48146u, 46892u, 45651u, 44423u, 43208u, 42006u, 40817u, 39640u, 38476u, 37325u, 36186u, 35060u, 33946u, 32844u, 31754u, 30676u, 29609u, 28555u, 27512u, 26481u, 25461u, 24452u, 23455u, 22468u, 21493u, 20529u, 19576u, 18633u, 17701u, 16780u, 15869u, 14969u, 14079u, 13199u, 12329u, 11469u, 10619u, 9779u, 8949u, 8129u, 7318u, 6516u, 5725u, 4942u, 4169u, 3404u, 2649u},
 /* T=273K (-0.1C) */   {59799u, 58473u, 57160u, 55860u, 54573u, 53300u, 52038u, 50790u, 49554u, 48331u, 47121u, 45922u, 44736u, 43562u, 42400u, 41251u, 40113u, 38986u, 37872u, 36769u, 35677u, 34597u, 33529u, 32471u, 31425u, 30389u, 29365u, 28351u, 27349u, 26357u, 25375u, 24404u, 23444u, 22494u, 21554u, 20624u, 19704u, 18795u, 17895u, 17005u, 16125u, 15255u, 14394u, 13542u, 12700u, 11868u, 11045u, 10230u, 9425u, 8629u, 7842u, 7064u, 6295u, 5534u, 4783u, 4039u},
 /* T=283K (9.9C) */   {59564u, 58287u, 57022u, 55769u, 54528u, 53300u, 52083u, 50878u, 49685u, 48503u, 47334u, 46175u, 45029u, 43893u, 42769u, 41656u, 40554u, 39462u, 38382u, 37313u, 36254u, 35207u, 34169u, 33142u, 32126u, 31120u, 30124u, 29138u, 28163u, 27197u, 26242u, 25296u, 24360u, 23434u, 22517u, 21610u, 20712u, 19824u, 18945u, 18075u, 17215u, 16363u, 15521u, 14688u, 13863u, 13047u, 12240u, 11442u, 10652u, 9871u, 9098u, 8334u, 7578u, 6830u, 6090u, 5358u},
 /* T=293K (19.9C) */   {59345u, 58113u, 56893u, 55684u, 54486u, 53300u, 52124u, 50960u, 49806u, 48664u, 47532u, 46412u, 45301u, 44202u, 43113u, 42034u, 40966u, 39908u, 38860u, 37823u, 36795u, 35777u, 34770u, 33772u, 32784u, 31806u, 30837u, 29878u, 28928u, 27987u, 27056u, 26135u, 25222u, 24319u, 23424u, 22539u, 21662u, 20795u, 19936u, 19085u, 18244u, 17411u, 16586u, 15770u, 14963u, 14163u, 13372u, 12589u, 11814u, 11047u, 10288u, 9538u, 8794u, 8059u, 7332u, 6612u},
 /* T=303K (29.9C) */   {59141u, 57952u, 56773u, 55604u, 54447u, 53300u, 52163u, 51036u, 49920u, 48814u, 47718u, 46633u, 45557u, 44491u, 43435u, 42389u, 41353u, 40326u, 39309u, 38301u, 37302u, 36314u, 35334u, 34364u, 33402u, 32450u, 31507u, 30573u, 29648u, 28731u, 27824u, 26925u, 26035u, 25153u, 24280u, 23415u, 22559u, 21711u, 20872u, 20040u, 19217u, 18402u, 17594u, 16795u, 16004u, 15220u, 14445u, 13677u, 12916u, 12164u, 11418u, 10681u, 9950u, 9228u, 8512u, 7804u},
 /* T=313K (39.9C) */   {58950u, 57800u, 56660u, 55530u, 54410u, 53300u, 52199u, 51108u, 50027u, 48955u, 47893u, 46840u, 45797u, 44763u, 43738u, 42722u, 41716u, 40718u, 39730u, 38750u, 37780u, 36818u, 35865u, 34920u, 33985u, 33058u, 32139u, 31229u, 30327u, 29433u, 28548u, 27671u, 26802u, 25941u, 25089u, 24244u, 23407u, 22578u, 21757u, 20944u, 20138u, 19340u, 18549u, 17766u, 16991u, 16223u, 15462u, 14709u, 13963u, 13224u, 12492u, 11767u, 11050u, 10339u, 9635u, 8939u},
 /* T=323K (49.9C) */   {58772u, 57659u, 56555u, 55460u, 54375u, 53300u, 52233u, 51175u, 50127u, 49087u, 48057u, 47035u, 46022u, 45018u, 44022u, 43036u, 42057u, 41088u, 40127u, 39174u, 38229u, 37293u, 36365u, 35446u, 34534u, 33631u, 32735u, 31848u, 30968u, 30096u, 29233u, 28376u, 27528u, 26687u, 25854u, 25028u, 24210u, 23399u, 22596u, 21800u, 21011u, 20230u, 19456u, 18688u, 17928u, 17175u, 16429u, 15690u, 14958u, 14232u, 13513u, 12802u, 12096u, 11398u, 10706u, 10020u},
  },
  { /* QNH=101400 Pa */
 /* T=263K (-10.1C) */   {60160u, 58779u, 57413u, 56061u, 54723u, 53400u, 52089u, 50793u, 49510u, 48241u, 46986u, 45743u, 44514u, 43298u, 42095u, 40904u, 39727u, 38562u, 37409u, 36269u, 35142u, 34027u, 32924u, 31832u, 30753u, 29686u, 28630u, 27586u, 26554u, 25533u, 24524u, 23525u, 22538u, 21562u, 20597u, 19642u, 18699u, 17766u, 16844u, 15932u, 15031u, 14140u, 13259u, 12388u, 11528u, 10677u, 9836u, 9005u, 8184u, 7372u, 6570u, 5778u, 4994u, 4220u, 3455u, 2699u},
 /* T=273K (-0.1C) */   {59906u, 58578u, 57264u, 55963u, 54675u, 53400u, 52137u, 50888u, 49651u, 48426u, 47215u, 46015u, 44828u, 43653u, 42490u, 41339u, 40200u, 39072u, 37957u, 36853u, 35760u, 34679u, 33609u, 32550u, 31503u, 30467u, 29441u, 28427u, 27423u, 26430u, 25448u, 24476u, 23514u, 22563u, 21622u, 20692u, 19771u, 18861u, 17960u, 17069u, 16188u, 15317u, 14455u, 13603u, 12760u, 11927u, 11103u, 10288u, 9482u, 8685u, 7898u, 7119u, 6349u, 5587u, 4835u, 4091u},
 /* T=283K (9.9C) */   {59670u, 58392u, 57125u, 55871u, 54629u, 53400u, 52182u, 50976u, 49781u, 48599u, 47428u, 46268u, 45120u, 43984u, 42858u, 41744u, 40641u, 39549u, 38468u, 37397u, 36338u, 35289u, 34250u, 33222u, 32205u, 31198u, 30201u, 29215u, 28238u, 27271u, 26315u, 25368u, 24431u, 23504u, 22587u, 21679u, 20780u, 19891u, 19011u, 18141u, 17279u, 16427u, 15584u, 14750u, 13924u, 13108u, 12300u, 11501u, 10710u, 9928u, 9154u, 8389u, 7632u, 6884u, 6143u, 5411u},
 /* T=293K (19.9C) */   {59451u, 58218u, 56996u, 55786u, 54587u, 53400u, 52223u, 51057u, 49903u, 48759u, 47627u, 46505u, 45394u, 44293u, 43203u, 42123u, 41054u, 39995u, 38946u, 37907u, 36879u, 35860u, 34851u, 33853u, 32864u, 31884u, 30915u, 29954u, 29004u, 28062u, 27130u, 26208u, 25294u, 24390u, 23495u, 22608u, 21731u, 20862u, 20003u, 19152u, 18309u, 17475u, 16650u, 15833u, 15025u, 14225u, 13433u, 12649u, 11873u, 11106u, 10346u, 9594u, 8851u, 8115u, 7386u, 6666u},
 /* T=303K (29.9C) */   {59247u, 58056u, 56876u, 55707u, 54548u, 53400u, 52262u, 51134u, 50017u, 48910u, 47813u, 46726u, 45649u, 44582u, 43525u, 42478u, 41441u, 40413u, 39395u, 38386u, 37387u, 36397u, 35416u, 34445u, 33483u, 32530u, 31586u, 30651u, 29724u, 28807u, 27899u, 26999u, 26108u, 25225u, 24351u, 23486u, 22629u, 21780u, 20939u, 20107u, 19283u, 18467u, 17659u, 16859u, 16067u, 15283u, 14506u, 13737u, 12976u, 12223u, 11477u, 10739u, 10008u, 9284u, 8568u, 7859u},
 /* T=313K (39.9C) */   {59056u, 57905u, 56764u, 55632u, 54511u, 53400u, 52298u, 51206u, 50123u, 49051u, 47987u, 46934u, 45889u, 44854u, 43828u, 42812u, 41804u, 40806u, 39816u, 38836u, 37864u, 36902u, 35948u, 35002u, 34066u, 33138u, 32218u, 31307u, 30404u, 29510u, 28624u, 27746u, 26876u, 26014u, 25161u, 24315u, 23478u, 22648u, 21826u, 21012u, 20205u, 19406u, 18615u, 17831u, 17055u, 16286u, 15525u, 14771u, 14024u, 13284u, 12552u, 11826u, 11108u, 10397u, 9692u, 8995u},
 /* T=323K (49.9C) */   {58877u, 57763u, 56658u, 55563u, 54476u, 53400u, 52332u, 51273u, 50224u, 49183u, 48151u, 47129u, 46115u, 45110u, 44113u, 43126u, 42146u, 41176u, 40214u, 39260u, 38315u, 37377u, 36449u, 35528u, 34616u, 33711u, 32815u, 31927u, 31046u, 30174u, 29309u, 28452u, 27603u, 26761u, 25927u, 25100u, 24281u, 23470u, 22666u, 21869u, 21079u, 20297u, 19522u, 18754u, 17993u, 17239u, 16493u, 15753u, 15020u, 14294u, 13574u, 12862u, 12156u, 11456u, 10764u, 10077u},
  },
  { /* QNH=101500 Pa */
 /* T=263K (-10.1C) */   {60266u, 58885u, 57517u, 56164u, 54825u, 53500u, 52188u, 50891u, 49607u, 48336u, 47079u, 45836u, 44605u, 43388u, 42183u, 40992u, 39813u, 38647u, 37494u, 36353u, 35224u, 34108u, 33003u, 31911u, 30831u, 29763u, 28706u, 27661u, 26628u, 25606u, 24595u, 23596u, 22608u, 21630u, 20664u, 19709u, 18765u, 17831u, 16908u, 15995u, 15093u, 14201u, 13319u, 12448u, 11587u, 10735u, 9893u, 9062u, 8240u, 7427u, 6624u, 5831u, 5046u, 4272u, 3506u, 2749u},
 /* T=273K (-0.1C) */   {60012u, 58683u, 57368u, 56065u, 54776u, 53500u, 52236u, 50985u, 49747u, 48522u, 47308u, 46108u, 44919u, 43743u, 42579u, 41427u, 40287u, 39158u, 38041u, 36936u, 35843u, 34760u, 33690u, 32630u, 31581u, 30544u, 29518u, 28502u, 27497u, 26503u, 25520u, 24547u, 23585u, 22633u, 21691u, 20759u, 19838u, 18927u, 18025u, 17133u, 16252u, 15379u, 14517u, 13664u, 12820u, 11986u, 11161u, 10345u, 9539u, 8741u, 7953u, 7173u, 6402u, 5640u, 4887u, 4142u},
 /* T=283K (9.9C) */   {59776u, 58497u, 57229u, 55974u, 54731u, 53500u, 52280u, 51073u, 49878u, 48694u, 47522u, 46361u, 45212u, 44074u, 42948u, 41833u, 40728u, 39635u, 38553u, 37481u, 36421u, 35371u, 34331u, 33303u, 32284u, 31276u, 30278u, 29291u, 28313u, 27346u, 26388u, 25441u, 24503u, 23575u, 22656u, 21747u, 20848u, 19958u, 19077u, 18206u, 17344u, 16491u, 15647u, 14811u, 13985u, 13168u, 12359u, 11559u, 10768u, 9985u, 9211u, 8445u, 7687u, 6938u, 6197u, 5464u},
 /* T=293K (19.9C) */   {59557u, 58323u, 57100u, 55888u, 54688u, 53500u, 52322u, 51155u, 50000u, 48855u, 47721u, 46598u, 45486u, 44384u, 43293u, 42212u, 41142u, 40082u, 39032u, 37992u, 36962u, 35943u, 34933u, 33933u, 32943u, 31963u, 30992u, 30031u, 29080u, 28137u, 27205u, 26281u, 25367u, 24461u, 23565u, 22678u, 21800u, 20930u, 20070u, 19218u, 18375u, 17540u, 16714u, 15896u, 15087u, 14286u, 13493u, 12709u, 11932u, 11164u, 10404u, 9651u, 8907u, 8170u, 7441u, 6720u},
 /* T=303K (29.9C) */   {59353u, 58161u, 56979u, 55809u, 54649u, 53500u, 52360u, 51232u, 50114u, 49005u, 47907u, 46820u, 45742u, 44674u, 43616u, 42568u, 41529u, 40500u, 39481u, 38471u, 37471u, 36480u, 35498u, 34526u, 33563u, 32609u, 31664u, 30728u, 29801u, 28883u, 27974u, 27073u, 26181u, 25298u, 24423u, 23556u, 22698u, 21849u, 21007u, 20174u, 19349u, 18533u, 17724u, 16923u, 16130u, 15345u, 14568u, 13798u, 13037u, 12282u, 11536u, 10797u, 10065u, 9341u, 8624u, 7914u},
 /* T=313K (39.9C) */   {59162u, 58009u, 56867u, 55734u, 54612u, 53500u, 52397u, 51304u, 50220u, 49146u, 48082u, 47027u, 45982u, 44946u, 43919u, 42901u, 41893u, 40893u, 39903u, 38922u, 37949u, 36985u, 36030u, 35084u, 34147u, 33218u, 32297u, 31385u, 30481u, 29586u, 28699u, 27820u, 26950u, 26087u, 25233u, 24387u, 23548u, 22718u, 21895u, 21080u, 20272u, 19473u, 18681u, 17896u, 17119u, 16350u, 15588u, 14833u, 14085u, 13345u, 12611u, 11885u, 11166u, 10454u, 9749u, 9051u},
 /* T=323K (49.9C) */   {58982u, 57867u, 56761u, 55665u, 54577u, 53500u, 52431u, 51371u, 50320u, 49279u, 48246u, 47223u, 46208u, 45202u, 44204u, 43215u, 42235u, 41264u, 40301u, 39346u, 38400u, 37462u, 36532u, 35610u, 34697u, 33792u, 32895u, 32005u, 31124u, 30251u, 29385u, 28527u, 27677u, 26835u, 26000u, 25172u, 24353u, 23540u, 22735u, 21938u, 21148u, 20365u, 19589u, 18820u, 18058u, 17304u, 16556u, 15816u, 15082u, 14355u, 13635u, 12922u, 12215u, 11515u, 10822u, 10135u},
  },
  { /* QNH=101600 Pa */
 /* T=263K (-10.1C) */   {60373u, 58990u, 57621u, 56266u, 54926u, 53600u, 52287u, 50988u, 49703u, 48431u, 47173u, 45928u, 44696u, 43478u, 42272u, 41080u, 39900u, 38732u, 37578u, 36436u, 35306u, 34188u, 33083u, 31990u, 30909u, 29839u, 28782u, 27736u, 26701u, 25678u, 24667u, 23666u, 22677u, 21699u, 20732u, 19776u, 18831u, 17896u, 16972u, 16058u, 15155u, 14262u, 13380u, 12508u, 11645u, 10793u, 9951u, 9118u, 8295u, 7482u, 6678u, 5884u, 5099u, 4323u, 3557u, 2799u},
 /* T=273K (-0.1C) */   {60119u, 58788u, 57472u, 56168u, 54877u, 53600u, 52335u, 51083u, 49843u, 48617u, 47402u, 46200u, 45011u, 43834u, 42668u, 41515u, 40374u, 39244u, 38126u, 37020u, 35925u, 34842u, 33770u, 32709u, 31660u, 30621u, 29594u, 28578u, 27572u, 26577u, 25592u, 24619u, 23655u, 22702u, 21760u, 20827u, 19905u, 18992u, 18090u, 17198u, 16315u, 15442u, 14578u, 13725u, 12880u, 12045u, 11219u, 10403u, 9596u, 8797u, 8008u, 7227u, 6456u, 5693u, 4939u, 4193u},
 /* T=283K (9.9C) */   {59883u, 58601u, 57333u, 56076u, 54832u, 53600u, 52379u, 51171u, 49974u, 48789u, 47616u, 46454u, 45304u, 44165u, 43037u, 41921u, 40816u, 39721u, 38638u, 37566u, 36504u, 35453u, 34413u, 33383u, 32363u, 31354u, 30355u, 29367u, 28388u, 27420u, 26462u, 25513u, 24574u, 23645u, 22726u, 21816u, 20916u, 20025u, 19143u, 18271u, 17408u, 16554u, 15709u, 14873u, 14046u, 13228u, 12419u, 11618u, 10826u, 10042u, 9267u, 8501u, 7742u, 6992u, 6250u, 5516u},
 /* T=293K (19.9C) */   {59663u, 58428u, 57203u, 55991u, 54790u, 53600u, 52421u, 51253u, 50096u, 48950u, 47815u, 46691u, 45578u, 44475u, 43383u, 42301u, 41229u, 40168u, 39117u, 38077u, 37046u, 36026u, 35015u, 34014u, 33023u, 32042u, 31070u, 30108u, 29156u, 28212u, 27279u, 26354u, 25439u, 24533u, 23636u, 22748u, 21869u, 20998u, 20137u, 19284u, 18440u, 17605u, 16778u, 15959u, 15149u, 14347u, 13554u, 12768u, 11991u, 11222u, 10461u, 9708u, 8963u, 8225u, 7495u, 6773u},
 /* T=303K (29.9C) */   {59458u, 58265u, 57083u, 55911u, 54750u, 53600u, 52459u, 51330u, 50210u, 49101u, 48002u, 46913u, 45834u, 44765u, 43706u, 42657u, 41617u, 40587u, 39567u, 38556u, 37555u, 36563u, 35581u, 34607u, 33643u, 32688u, 31743u, 30806u, 29878u, 28959u, 28048u, 27147u, 26254u, 25370u, 24494u, 23627u, 22768u, 21918u, 21075u, 20242u, 19416u, 18598u, 17789u, 16987u, 16193u, 15407u, 14629u, 13859u, 13097u, 12342u, 11594u, 10854u, 10122u, 9397u, 8679u, 7969u},
 /* T=313K (39.9C) */   {59267u, 58114u, 56970u, 55837u, 54713u, 53600u, 52496u, 51401u, 50317u, 49242u, 48177u, 47121u, 46074u, 45037u, 44010u, 42991u, 41981u, 40981u, 39990u, 39007u, 38034u, 37069u, 36113u, 35166u, 34228u, 33298u, 32376u, 31463u, 30559u, 29663u, 28775u, 27895u, 27024u, 26160u, 25305u, 24458u, 23619u, 22787u, 21964u, 21148u, 20340u, 19539u, 18746u, 17961u, 17183u, 16413u, 15650u, 14895u, 14146u, 13405u, 12671u, 11944u, 11225u, 10512u, 9806u, 9107u},
 /* T=323K (49.9C) */   {59088u, 57971u, 56864u, 55767u, 54679u, 53600u, 52530u, 51469u, 50417u, 49375u, 48341u, 47316u, 46300u, 45293u, 44295u, 43305u, 42324u, 41352u, 40388u, 39432u, 38485u, 37546u, 36615u, 35693u, 34779u, 33872u, 32974u, 32084u, 31202u, 30328u, 29461u, 28603u, 27752u, 26908u, 26073u, 25245u, 24424u, 23611u, 22805u, 22007u, 21216u, 20432u, 19655u, 18886u, 18123u, 17368u, 16620u, 15879u, 15144u, 14416u, 13696u, 12982u, 12274u, 11574u, 10880u, 10192u},
  },
  { /* QNH=101700 Pa */
 /* T=263K (-10.1C) */   {60480u, 59095u, 57725u, 56369u, 55027u, 53700u, 52386u, 51085u, 49799u, 48526u, 47267u, 46020u, 44788u, 43568u, 42361u, 41167u, 39986u, 38818u, 37662u, 36519u, 35388u, 34269u, 33163u, 32069u, 30986u, 29916u, 28857u, 27810u, 26775u, 25751u, 24738u, 23737u, 22747u, 21768u, 20800u, 19843u, 18896u, 17961u, 17036u, 16121u, 15217u, 14324u, 13440u, 12567u, 11704u, 10851u, 10008u, 9174u, 8350u, 7536u, 6732u, 5937u, 5151u, 4375u, 3607u, 2849u},
 /* T=273K (-0.1C) */   {60225u, 58894u, 57575u, 56270u, 54978u, 53700u, 52433u, 51180u, 49940u, 48712u, 47496u, 46293u, 45102u, 43924u, 42757u, 41603u, 40461u, 39330u, 38211u, 37104u, 36008u, 34923u, 33850u, 32789u, 31738u, 30699u, 29670u, 28653u, 27646u, 26650u, 25665u, 24690u, 23726u, 22772u, 21828u, 20895u, 19972u, 19058u, 18155u, 17262u, 16378u, 15504u, 14640u, 13785u, 12940u, 12104u, 11278u, 10460u, 9652u, 8853u, 8063u, 7282u, 6509u, 5746u, 4991u, 4245u},
 /* T=283K (9.9C) */   {59989u, 58706u, 57436u, 56179u, 54933u, 53700u, 52478u, 51268u, 50071u, 48885u, 47710u, 46547u, 45396u, 44256u, 43127u, 42010u, 40903u, 39808u, 38723u, 37650u, 36587u, 35535u, 34494u, 33463u, 32442u, 31432u, 30433u, 29443u, 28464u, 27494u, 26535u, 25585u, 24646u, 23716u, 22795u, 21885u, 20984u, 20092u, 19209u, 18336u, 17472u, 16618u, 15772u, 14935u, 14107u, 13288u, 12478u, 11677u, 10884u, 10099u, 9324u, 8556u, 7797u, 7046u, 6304u, 5569u},
 /* T=293K (19.9C) */   {59769u, 58532u, 57307u, 56093u, 54891u, 53700u, 52519u, 51351u, 50193u, 49046u, 47910u, 46784u, 45670u, 44566u, 43473u, 42390u, 41317u, 40255u, 39203u, 38161u, 37130u, 36108u, 35097u, 34095u, 33103u, 32121u, 31148u, 30185u, 29232u, 28287u, 27353u, 26427u, 25511u, 24604u, 23706u, 22817u, 21937u, 21066u, 20204u, 19350u, 18505u, 17669u, 16841u, 16022u, 15211u, 14409u, 13614u, 12828u, 12050u, 11281u, 10519u, 9765u, 9019u, 8281u, 7550u, 6827u},
 /* T=303K (29.9C) */   {59564u, 58370u, 57186u, 56013u, 54851u, 53700u, 52558u, 51427u, 50307u, 49197u, 48096u, 47006u, 45926u, 44856u, 43796u, 42746u, 41705u, 40675u, 39653u, 38642u, 37639u, 36646u, 35663u, 34689u, 33724u, 32768u, 31821u, 30883u, 29954u, 29034u, 28123u, 27221u, 26327u, 25442u, 24565u, 23697u, 22838u, 21986u, 21143u, 20309u, 19482u, 18664u, 17853u, 17051u, 16256u, 15470u, 14691u, 13920u, 13157u, 12401u, 11653u, 10912u, 10179u, 9454u, 8735u, 8024u},
 /* T=313K (39.9C) */   {59373u, 58218u, 57073u, 55939u, 54814u, 53700u, 52595u, 51499u, 50414u, 49338u, 48271u, 47215u, 46167u, 45129u, 44100u, 43080u, 42070u, 41069u, 40076u, 39093u, 38118u, 37153u, 36196u, 35248u, 34308u, 33378u, 32455u, 31542u, 30636u, 29739u, 28850u, 27970u, 27098u, 26233u, 25377u, 24529u, 23689u, 22857u, 22032u, 21216u, 20407u, 19606u, 18812u, 18026u, 17248u, 16477u, 15713u, 14956u, 14207u, 13466u, 12731u, 12003u, 11283u, 10570u, 9863u, 9164u},
 /* T=323K (49.9C) */   {59193u, 58076u, 56968u, 55869u, 54780u, 53700u, 52629u, 51567u, 50514u, 49471u, 48436u, 47410u, 46393u, 45385u, 44386u, 43395u, 42413u, 41440u, 40475u, 39518u, 38570u, 37630u, 36699u, 35775u, 34860u, 33953u, 33054u, 32163u, 31280u, 30405u, 29538u, 28678u, 27826u, 26982u, 26146u, 25317u, 24495u, 23681u, 22875u, 22076u, 21284u, 20499u, 19722u, 18952u, 18189u, 17433u, 16683u, 15941u, 15206u, 14478u, 13756u, 13042u, 12334u, 11632u, 10938u, 10249u},
  },
  { /* QNH=101800 Pa */
 /* T=263K (-10.1C) */   {60586u, 59200u, 57829u, 56472u, 55129u, 53800u, 52484u, 51183u, 49895u, 48621u, 47360u, 46113u, 44879u, 43658u, 42450u, 41255u, 40073u, 38903u, 37746u, 36602u, 35470u, 34350u, 33243u, 32147u, 31064u, 29992u, 28933u, 27885u, 26848u, 25823u, 24810u, 23807u, 22816u, 21836u, 20867u, 19909u, 18962u, 18026u, 17100u, 16184u, 15279u, 14385u, 13501u, 12627u, 11763u, 10909u, 10065u, 9230u, 8406u, 7591u, 6786u, 5990u, 5203u, 4426u, 3658u, 2899u},
 /* T=273K (-0.1C) */   {60331u, 58999u, 57679u, 56373u, 55080u, 53800u, 52532u, 51278u, 50036u, 48807u, 47590u, 46386u, 45194u, 44014u, 42847u, 41691u, 40547u, 39416u, 38296u, 37187u, 36090u, 35005u, 33931u, 32868u, 31817u, 30776u, 29747u, 28728u, 27721u, 26724u, 25737u, 24762u, 23796u, 22842u, 21897u, 20963u, 20038u, 19124u, 18220u, 17326u, 16441u, 15567u, 14702u, 13846u, 13000u, 12163u, 11336u, 10518u, 9709u, 8909u, 8118u, 7336u, 6563u, 5799u, 5043u, 4296u},
 /* T=283K (9.9C) */   {60095u, 58811u, 57540u, 56281u, 55034u, 53800u, 52577u, 51366u, 50167u, 48980u, 47804u, 46640u, 45488u, 44347u, 43217u, 42098u, 40991u, 39894u, 38809u, 37734u, 36670u, 35617u, 34575u, 33543u, 32521u, 31510u, 30510u, 29519u, 28539u, 27568u, 26608u, 25658u, 24717u, 23786u, 22865u, 21953u, 21051u, 20159u, 19275u, 18402u, 17537u, 16681u, 15835u, 14997u, 14168u, 13349u, 12538u, 11735u, 10942u, 10157u, 9380u, 8612u, 7852u, 7100u, 6357u, 5622u},
 /* T=293K (19.9C) */   {59875u, 58637u, 57411u, 56196u, 54992u, 53800u, 52618u, 51448u, 50289u, 49141u, 48004u, 46878u, 45762u, 44657u, 43563u, 42479u, 41405u, 40342u, 39289u, 38246u, 37214u, 36191u, 35178u, 34176u, 33183u, 32199u, 31226u, 30262u, 29307u, 28362u, 27427u, 26501u, 25583u, 24676u, 23777u, 22887u, 22006u, 21134u, 20271u, 19417u, 18571u, 17734u, 16905u, 16085u, 15273u, 14470u, 13675u, 12888u, 12109u, 11339u, 10576u, 9822u, 9075u, 8336u, 7605u, 6881u},
 /* T=303K (29.9C) */   {59670u, 58474u, 57290u, 56116u, 54952u, 53800u, 52657u, 51525u, 50404u, 49292u, 48191u, 47100u, 46019u, 44948u, 43887u, 42835u, 41794u, 40762u, 39739u, 38727u, 37724u, 36730u, 35745u, 34770u, 33804u, 32847u, 31900u, 30961u, 30031u, 29110u, 28198u, 27295u, 26400u, 25514u, 24637u, 23768u, 22907u, 22055u, 21211u, 20376u, 19549u, 18729u, 17918u, 17115u, 16320u, 15532u, 14753u, 13981u, 13217u, 12460u, 11712u, 10970u, 10236u, 9510u, 8791u, 8079u},
 /* T=313K (39.9C) */   {59478u, 58322u, 57177u, 56041u, 54915u, 53800u, 52693u, 51597u, 50511u, 49434u, 48366u, 47308u, 46260u, 45221u, 44191u, 43170u, 42159u, 41156u, 40163u, 39179u, 38203u, 37237u, 36279u, 35330u, 34389u, 33458u, 32534u, 31620u, 30713u, 29816u, 28926u, 28045u, 27171u, 26306u, 25449u, 24601u, 23760u, 22927u, 22101u, 21284u, 20474u, 19672u, 18878u, 18091u, 17312u, 16540u, 15775u, 15018u, 14269u, 13526u, 12791u, 12062u, 11341u, 10627u, 9920u, 9220u},
 /* T=323K (49.9C) */   {59299u, 58180u, 57071u, 55971u, 54881u, 53800u, 52728u, 51665u, 50611u, 49566u, 48531u, 47504u, 46486u, 45477u, 44477u, 43485u, 42502u, 41528u, 40562u, 39604u, 38655u, 37714u, 36782u, 35858u, 34942u, 34034u, 33134u, 32242u, 31358u, 30482u, 29614u, 28753u, 27901u, 27056u, 26218u, 25389u, 24567u, 23752u, 22945u, 22145u, 21352u, 20567u, 19788u, 19017u, 18254u, 17497u, 16747u, 16004u, 15268u, 14539u, 13817u, 13102u, 12393u, 11691u, 10995u, 10307u},
  },
  { /* QNH=101900 Pa */
 /* T=263K (-10.1C) */   {60693u, 59306u, 57933u, 56574u, 55230u, 53900u, 52583u, 51280u, 49991u, 48716u, 47454u, 46205u, 44970u, 43748u, 42539u, 41343u, 40159u, 38989u, 37831u, 36685u, 35552u, 34431u, 33323u, 32226u, 31142u, 30069u, 29008u, 27959u, 26922u, 25896u, 24881u, 23878u, 22886u, 21905u, 20935u, 19976u, 19028u, 18090u, 17164u, 16247u, 15342u, 14446u, 13561u, 12686u, 11821u, 10967u, 10122u, 9287u, 8461u, 7646u, 6839u, 6043u, 5255u, 4478u, 3709u, 2949u},
 /* T=273K (-0.1C) */   {60438u, 59104u, 57783u, 56475u, 55181u, 53900u, 52631u, 51375u, 50132u, 48902u, 47684u, 46479u, 45286u, 44105u, 42936u, 41779u, 40634u, 39502u, 38380u, 37271u, 36173u, 35087u, 34011u, 32948u, 31895u, 30854u, 29823u, 28804u, 27795u, 26797u, 25810u, 24833u, 23867u, 22911u, 21966u, 21030u, 20105u, 19190u, 18285u, 17390u, 16505u, 15629u, 14763u, 13907u, 13060u, 12222u, 11394u, 10575u, 9766u, 8965u, 8173u, 7391u, 6617u, 5852u, 5095u, 4347u},
 /* T=283K (9.9C) */   {60201u, 58916u, 57644u, 56383u, 55135u, 53900u, 52676u, 51464u, 50263u, 49075u, 47898u, 46733u, 45580u, 44437u, 43306u, 42187u, 41078u, 39981u, 38894u, 37818u, 36753u, 35699u, 34656u, 33623u, 32601u, 31588u, 30587u, 29595u, 28614u, 27643u, 26681u, 25730u, 24788u, 23857u, 22935u, 22022u, 21119u, 20226u, 19342u, 18467u, 17601u, 16745u, 15897u, 15059u, 14230u, 13409u, 12597u, 11794u, 11000u, 10214u, 9436u, 8667u, 7907u, 7154u, 6410u, 5674u},
 /* T=293K (19.9C) */   {59981u, 58742u, 57514u, 56298u, 55093u, 53900u, 52717u, 51546u, 50386u, 49237u, 48098u, 46971u, 45854u, 44748u, 43653u, 42567u, 41493u, 40429u, 39375u, 38331u, 37297u, 36274u, 35260u, 34256u, 33262u, 32278u, 31304u, 30339u, 29383u, 28437u, 27501u, 26574u, 25656u, 24747u, 23847u, 22957u, 22075u, 21202u, 20338u, 19483u, 18636u, 17798u, 16969u, 16148u, 15336u, 14531u, 13736u, 12948u, 12168u, 11397u, 10634u, 9878u, 9131u, 8391u, 7659u, 6935u},
 /* T=303K (29.9C) */   {59776u, 58579u, 57393u, 56218u, 55053u, 53900u, 52756u, 51623u, 50500u, 49388u, 48285u, 47193u, 46111u, 45039u, 43977u, 42924u, 41882u, 40849u, 39826u, 38812u, 37808u, 36813u, 35828u, 34851u, 33884u, 32927u, 31978u, 31038u, 30108u, 29186u, 28273u, 27369u, 26473u, 25586u, 24708u, 23838u, 22977u, 22124u, 21279u, 20443u, 19615u, 18795u, 17983u, 17179u, 16383u, 15595u, 14814u, 14042u, 13277u, 12520u, 11770u, 11028u, 10294u, 9567u, 8847u, 8134u},
 /* T=313K (39.9C) */   {59584u, 58427u, 57280u, 56143u, 55016u, 53900u, 52792u, 51695u, 50607u, 49529u, 48461u, 47402u, 46352u, 45312u, 44281u, 43260u, 42247u, 41244u, 40249u, 39264u, 38288u, 37320u, 36362u, 35412u, 34470u, 33538u, 32614u, 31698u, 30791u, 29892u, 29001u, 28119u, 27245u, 26379u, 25522u, 24672u, 23830u, 22996u, 22170u, 21352u, 20541u, 19739u, 18944u, 18156u, 17376u, 16603u, 15838u, 15080u, 14330u, 13586u, 12850u, 12121u, 11400u, 10685u, 9977u, 9276u},
 /* T=323K (49.9C) */   {59404u, 58284u, 57174u, 56073u, 54982u, 53900u, 52827u, 51763u, 50708u, 49662u, 48626u, 47598u, 46579u, 45569u, 44568u, 43575u, 42591u, 41615u, 40649u, 39690u, 38740u, 37798u, 36865u, 35940u, 35023u, 34114u, 33213u, 32321u, 31436u, 30559u, 29690u, 28829u, 27975u, 27130u, 26291u, 25461u, 24638u, 23822u, 23014u, 22213u, 21420u, 20634u, 19855u, 19083u, 18319u, 17561u, 16811u, 16067u, 15331u, 14601u, 13878u, 13162u, 12452u, 11750u, 11053u, 10364u},
  },
  { /* QNH=102000 Pa */
 /* T=263K (-10.1C) */   {60800u, 59411u, 58037u, 56677u, 55331u, 54000u, 52682u, 51378u, 50087u, 48811u, 47548u, 46298u, 45061u, 43838u, 42628u, 41430u, 40246u, 39074u, 37915u, 36768u, 35634u, 34512u, 33402u, 32305u, 31219u, 30146u, 29084u, 28034u, 26995u, 25968u, 24953u, 23948u, 22955u, 21973u, 21003u, 20043u, 19094u, 18155u, 17228u, 16310u, 15404u, 14508u, 13622u, 12746u, 11880u, 11024u, 10179u, 9343u, 8517u, 7700u, 6893u, 6096u, 5308u, 4529u, 3760u, 2999u},
 /* T=273K (-0.1C) */   {60544u, 59209u, 57887u, 56578u, 55282u, 54000u, 52730u, 51473u, 50229u, 48997u, 47778u, 46571u, 45377u, 44195u, 43025u, 41867u, 40721u, 39587u, 38465u, 37355u, 36256u, 35168u, 34092u, 33027u, 31974u, 30931u, 29900u, 28879u, 27869u, 26870u, 25882u, 24905u, 23937u, 22981u, 22034u, 21098u, 20172u, 19256u, 18350u, 17454u, 16568u, 15692u, 14825u, 13968u, 13120u, 12282u, 11453u, 10633u, 9822u, 9021u, 8228u, 7445u, 6670u, 5904u, 5147u, 4399u},
 /* T=283K (9.9C) */   {60307u, 59021u, 57747u, 56486u, 55237u, 54000u, 52774u, 51561u, 50360u, 49170u, 47992u, 46826u, 45671u, 44528u, 43396u, 42275u, 41165u, 40067u, 38979u, 37903u, 36837u, 35782u, 34737u, 33703u, 32680u, 31667u, 30664u, 29671u, 28689u, 27717u, 26755u, 25802u, 24860u, 23927u, 23004u, 22091u, 21187u, 20293u, 19408u, 18532u, 17666u, 16808u, 15960u, 15121u, 14291u, 13469u, 12657u, 11853u, 11057u, 10271u, 9493u, 8723u, 7962u, 7209u, 6464u, 5727u},
 /* T=293K (19.9C) */   {60087u, 58847u, 57618u, 56400u, 55194u, 54000u, 52816u, 51644u, 50482u, 49332u, 48193u, 47064u, 45946u, 44839u, 43742u, 42656u, 41581u, 40515u, 39460u, 38416u, 37381u, 36356u, 35342u, 34337u, 33342u, 32357u, 31382u, 30416u, 29459u, 28513u, 27575u, 26647u, 25728u, 24818u, 23918u, 23026u, 22144u, 21270u, 20405u, 19549u, 18702u, 17863u, 17033u, 16211u, 15398u, 14593u, 13796u, 13008u, 12228u, 11455u, 10691u, 9935u, 9187u, 8447u, 7714u, 6989u},
 /* T=303K (29.9C) */   {59882u, 58684u, 57497u, 56320u, 55155u, 54000u, 52855u, 51721u, 50597u, 49483u, 48380u, 47287u, 46203u, 45130u, 44067u, 43014u, 41970u, 40936u, 39912u, 38897u, 37892u, 36896u, 35910u, 34933u, 33965u, 33006u, 32057u, 31116u, 30184u, 29262u, 28348u, 27443u, 26546u, 25659u, 24780u, 23909u, 23047u, 22193u, 21347u, 20510u, 19681u, 18860u, 18048u, 17243u, 16446u, 15657u, 14876u, 14103u, 13337u, 12579u, 11829u, 11086u, 10351u, 9623u, 8903u, 8189u},
 /* T=313K (39.9C) */   {59689u, 58531u, 57383u, 56246u, 55118u, 54000u, 52891u, 51793u, 50704u, 49625u, 48555u, 47495u, 46445u, 45404u, 44372u, 43349u, 42336u, 41331u, 40336u, 39350u, 38372u, 37404u, 36444u, 35493u, 34551u, 33618u, 32693u, 31776u, 30868u, 29968u, 29077u, 28194u, 27319u, 26452u, 25594u, 24743u, 23901u, 23066u, 22239u, 21420u, 20609u, 19805u, 19009u, 18221u, 17440u, 16667u, 15901u, 15142u, 14391u, 13647u, 12910u, 12180u, 11458u, 10742u, 10034u, 9332u},
 /* T=323K (49.9C) */   {59510u, 58389u, 57277u, 56175u, 55083u, 54000u, 52925u, 51861u, 50805u, 49758u, 48720u, 47692u, 46672u, 45661u, 44658u, 43665u, 42680u, 41703u, 40736u, 39776u, 38825u, 37883u, 36948u, 36022u, 35104u, 34195u, 33293u, 32399u, 31514u, 30636u, 29766u, 28904u, 28050u, 27203u, 26364u, 25533u, 24709u, 23893u, 23084u, 22282u, 21488u, 20701u, 19922u, 19149u, 18384u, 17626u, 16874u, 16130u, 15393u, 14662u, 13939u, 13222u, 12512u, 11808u, 11111u, 10421u},
  },
  { /* QNH=102100 Pa */
 /* T=263K (-10.1C) */   {60906u, 59516u, 58141u, 56780u, 55433u, 54100u, 52780u, 51475u, 50184u, 48906u, 47641u, 46390u, 45153u, 43928u, 42716u, 41518u, 40332u, 39159u, 37999u, 36851u, 35716u, 34593u, 33482u, 32384u, 31297u, 30222u, 29159u, 28108u, 27069u, 26041u, 25024u, 24019u, 23025u, 22042u, 21070u, 20109u, 19159u, 18220u, 17292u, 16374u, 15466u, 14569u, 13682u, 12805u, 11939u, 11082u, 10236u, 9399u, 8572u, 7755u, 6947u, 6149u, 5360u, 4581u, 3810u, 3049u},
 /* T=273K (-0.1C) */   {60651u, 59314u, 57991u, 56680u, 55383u, 54100u, 52828u, 51570u, 50325u, 49092u, 47872u, 46664u, 45469u, 44285u, 43114u, 41955u, 40808u, 39673u, 38550u, 37438u, 36338u, 35250u, 34172u, 33107u, 32052u, 31008u, 29976u, 28954u, 27944u, 26944u, 25955u, 24976u, 24008u, 23050u, 22103u, 21166u, 20239u, 19322u, 18415u, 17518u, 16631u, 15754u, 14886u, 14028u, 13180u, 12341u, 11511u, 10690u, 9879u, 9077u, 8284u, 7499u, 6724u, 5957u, 5199u, 4450u},
 /* T=283K (9.9C) */   {60414u, 59126u, 57851u, 56588u, 55338u, 54100u, 52873u, 51659u, 50456u, 49266u, 48087u, 46919u, 45763u, 44619u, 43486u, 42364u, 41253u, 40153u, 39065u, 37987u, 36920u, 35864u, 34818u, 33783u, 32759u, 31745u, 30741u, 29748u, 28764u, 27791u, 26828u, 25875u, 24931u, 23998u, 23074u, 22160u, 21255u, 20360u, 19474u, 18597u, 17730u, 16872u, 16023u, 15183u, 14352u, 13529u, 12716u, 11911u, 11115u, 10328u, 9549u, 8779u, 8016u, 7263u, 6517u, 5780u},
 /* T=293K (19.9C) */   {60193u, 58951u, 57721u, 56503u, 55295u, 54100u, 52915u, 51741u, 50579u, 49427u, 48287u, 47157u, 46038u, 44930u, 43832u, 42745u, 41669u, 40602u, 39546u, 38500u, 37465u, 36439u, 35423u, 34418u, 33422u, 32436u, 31459u, 30493u, 29535u, 28588u, 27649u, 26720u, 25800u, 24890u, 23988u, 23096u, 22212u, 21338u, 20472u, 19615u, 18767u, 17927u, 17096u, 16274u, 15460u, 14654u, 13857u, 13068u, 12287u, 11514u, 10749u, 9992u, 9243u, 8502u, 7769u, 7043u},
 /* T=303K (29.9C) */   {59987u, 58788u, 57600u, 56423u, 55256u, 54100u, 52954u, 51818u, 50693u, 49579u, 48474u, 47380u, 46296u, 45222u, 44157u, 43103u, 42058u, 41023u, 39998u, 38982u, 37976u, 36979u, 35992u, 35014u, 34045u, 33086u, 32135u, 31194u, 30261u, 29337u, 28423u, 27517u, 26619u, 25731u, 24851u, 23979u, 23116u, 22262u, 21415u, 20577u, 19748u, 18926u, 18112u, 17307u, 16509u, 15720u, 14938u, 14164u, 13397u, 12639u, 11888u, 11144u, 10408u, 9680u, 8958u, 8244u},
 /* T=313K (39.9C) */   {59795u, 58636u, 57487u, 56348u, 55219u, 54100u, 52990u, 51891u, 50801u, 49721u, 48650u, 47589u, 46537u, 45495u, 44462u, 43439u, 42424u, 41419u, 40423u, 39435u, 38457u, 37488u, 36527u, 35575u, 34632u, 33698u, 32772u, 31854u, 30945u, 30045u, 29153u, 28269u, 27393u, 26525u, 25666u, 24814u, 23971u, 23136u, 22308u, 21488u, 20676u, 19872u, 19075u, 18286u, 17504u, 16730u, 15963u, 15204u, 14452u, 13707u, 12970u, 12239u, 11516u, 10800u, 10091u, 9388u},
 /* T=323K (49.9C) */   {59615u, 58493u, 57381u, 56278u, 55184u, 54100u, 53024u, 51958u, 50902u, 49854u, 48815u, 47785u, 46765u, 45753u, 44749u, 43755u, 42769u, 41791u, 40823u, 39862u, 38910u, 37967u, 37032u, 36105u, 35186u, 34275u, 33373u, 32478u, 31592u, 30713u, 29842u, 28980u, 28124u, 27277u, 26437u, 25605u, 24780u, 23963u, 23154u, 22351u, 21556u, 20769u, 19988u, 19215u, 18449u, 17690u, 16938u, 16193u, 15455u, 14724u, 13999u, 13282u, 12571u, 11867u, 11169u, 10478u},
  },
  { /* QNH=102200 Pa */
 /* T=263K (-10.1C) */   {61013u, 59622u, 58245u, 56882u, 55534u, 54200u, 52879u, 51573u, 50280u, 49001u, 47735u, 46483u, 45244u, 44018u, 42805u, 41606u, 40419u, 39245u, 38083u, 36934u, 35798u, 34674u, 33562u, 32462u, 31375u, 30299u, 29235u, 28183u, 27142u, 26113u, 25096u, 24089u, 23095u, 22111u, 21138u, 20176u, 19225u, 18285u, 17355u, 16437u, 15528u, 14630u, 13742u, 12865u, 11997u, 11140u, 10293u, 9455u, 8627u, 7809u, 7001u, 6202u, 5412u, 4632u, 3861u, 3099u},
 /* T=273K (-0.1C) */   {60757u, 59419u, 58094u, 56783u, 55485u, 54200u, 52927u, 51668u, 50421u, 49187u, 47966u, 46757u, 45560u, 44376u, 43204u, 42044u, 40895u, 39759u, 38635u, 37522u, 36421u, 35331u, 34253u, 33186u, 32130u, 31086u, 30052u, 29030u, 28018u, 27017u, 26027u, 25048u, 24078u, 23120u, 22172u, 21234u, 20306u, 19388u, 18480u, 17583u, 16695u, 15817u, 14948u, 14089u, 13240u, 12400u, 11569u, 10748u, 9936u, 9133u, 8339u, 7554u, 6777u, 6010u, 5251u, 4502u},
 /* T=283K (9.9C) */   {60520u, 59231u, 57955u, 56691u, 55439u, 54200u, 52972u, 51756u, 50553u, 49361u, 48181u, 47012u, 45855u, 44709u, 43575u, 42452u, 41340u, 40240u, 39150u, 38071u, 37003u, 35946u, 34899u, 33863u, 32838u, 31823u, 30818u, 29824u, 28839u, 27865u, 26901u, 25947u, 25003u, 24068u, 23143u, 22228u, 21323u, 20427u, 19540u, 18662u, 17794u, 16935u, 16085u, 15245u, 14413u, 13590u, 12776u, 11970u, 11173u, 10385u, 9605u, 8834u, 8071u, 7317u, 6571u, 5832u},
 /* T=293K (19.9C) */   {60299u, 59056u, 57825u, 56605u, 55397u, 54200u, 53014u, 51839u, 50675u, 49523u, 48381u, 47250u, 46130u, 45021u, 43922u, 42834u, 41756u, 40689u, 39632u, 38585u, 37548u, 36522u, 35505u, 34498u, 33502u, 32515u, 31537u, 30569u, 29611u, 28663u, 27723u, 26793u, 25873u, 24961u, 24059u, 23165u, 22281u, 21406u, 20539u, 19681u, 18832u, 17992u, 17160u, 16337u, 15522u, 14715u, 13917u, 13127u, 12346u, 11572u, 10806u, 10049u, 9299u, 8557u, 7823u, 7097u},
 /* T=303K (29.9C) */   {60093u, 58893u, 57703u, 56525u, 55357u, 54200u, 53053u, 51916u, 50790u, 49674u, 48569u, 47474u, 46388u, 45313u, 44248u, 43192u, 42146u, 41111u, 40084u, 39068u, 38060u, 37063u, 36074u, 35095u, 34126u, 33165u, 32214u, 31271u, 30338u, 29413u, 28498u, 27591u, 26693u, 25803u, 24922u, 24050u, 23186u, 22331u, 21483u, 20645u, 19814u, 18991u, 18177u, 17371u, 16572u, 15782u, 14999u, 14225u, 13457u, 12698u, 11946u, 11202u, 10465u, 9736u, 9014u, 8300u},
 /* T=313K (39.9C) */   {59901u, 58740u, 57590u, 56450u, 55320u, 54200u, 53089u, 51989u, 50898u, 49816u, 48745u, 47683u, 46630u, 45587u, 44553u, 43528u, 42513u, 41507u, 40509u, 39521u, 38542u, 37571u, 36610u, 35657u, 34713u, 33778u, 32851u, 31933u, 31023u, 30121u, 29228u, 28343u, 27467u, 26598u, 25738u, 24886u, 24042u, 23205u, 22377u, 21556u, 20743u, 19938u, 19141u, 18351u, 17568u, 16793u, 16026u, 15266u, 14513u, 13768u, 13030u, 12298u, 11574u, 10857u, 10148u, 9445u},
 /* T=323K (49.9C) */   {59720u, 58597u, 57484u, 56380u, 55285u, 54200u, 53123u, 52056u, 50999u, 49950u, 48910u, 47879u, 46857u, 45844u, 44840u, 43844u, 42858u, 41879u, 40910u, 39948u, 38995u, 38051u, 37115u, 36187u, 35267u, 34356u, 33452u, 32557u, 31670u, 30790u, 29919u, 29055u, 28199u, 27351u, 26510u, 25677u, 24852u, 24034u, 23223u, 22420u, 21624u, 20836u, 20055u, 19281u, 18514u, 17754u, 17001u, 16256u, 15517u, 14785u, 14060u, 13342u, 12630u, 11925u, 11227u, 10536u},
  },
  { /* QNH=102300 Pa */
 /* T=263K (-10.1C) */   {61120u, 59727u, 58349u, 56985u, 55635u, 54300u, 52978u, 51670u, 50376u, 49096u, 47829u, 46575u, 45335u, 44108u, 42894u, 41693u, 40505u, 39330u, 38167u, 37017u, 35880u, 34755u, 33642u, 32541u, 31452u, 30375u, 29311u, 28257u, 27216u, 26186u, 25167u, 24160u, 23164u, 22179u, 21206u, 20243u, 19291u, 18350u, 17419u, 16500u, 15590u, 14691u, 13803u, 12924u, 12056u, 11198u, 10350u, 9511u, 8683u, 7864u, 7055u, 6255u, 5465u, 4684u, 3912u, 3149u},
 /* T=273K (-0.1C) */   {60864u, 59524u, 58198u, 56886u, 55586u, 54300u, 53026u, 51765u, 50517u, 49282u, 48060u, 46850u, 45652u, 44466u, 43293u, 42132u, 40982u, 39845u, 38719u, 37606u, 36503u, 35413u, 34333u, 33265u, 32209u, 31163u, 30129u, 29105u, 28093u, 27091u, 26100u, 25119u, 24149u, 23189u, 22240u, 21301u, 20373u, 19454u, 18545u, 17647u, 16758u, 15879u, 15010u, 14150u, 13300u, 12459u, 11627u, 10805u, 9992u, 9189u, 8394u, 7608u, 6831u, 6063u, 5304u, 4553u},
 /* T=283K (9.9C) */   {60626u, 59336u, 58058u, 56793u, 55540u, 54300u, 53071u, 51854u, 50649u, 49456u, 48275u, 47105u, 45947u, 44800u, 43665u, 42541u, 41428u, 40326u, 39235u, 38155u, 37086u, 36028u, 34980u, 33943u, 32917u, 31901u, 30895u, 29900u, 28915u, 27940u, 26975u, 26019u, 25074u, 24139u, 23213u, 22297u, 21391u, 20494u, 19606u, 18728u, 17859u, 16999u, 16148u, 15306u, 14474u, 13650u, 12835u, 12029u, 11231u, 10442u, 9662u, 8890u, 8126u, 7371u, 6624u, 5885u},
 /* T=293K (19.9C) */   {60405u, 59161u, 57928u, 56707u, 55498u, 54300u, 53113u, 51937u, 50772u, 49618u, 48476u, 47344u, 46223u, 45112u, 44012u, 42923u, 41844u, 40776u, 39718u, 38670u, 37632u, 36604u, 35587u, 34579u, 33581u, 32593u, 31615u, 30646u, 29687u, 28738u, 27797u, 26866u, 25945u, 25033u, 24129u, 23235u, 22350u, 21474u, 20606u, 19748u, 18898u, 18057u, 17224u, 16400u, 15584u, 14777u, 13978u, 13187u, 12405u, 11630u, 10864u, 10106u, 9355u, 8613u, 7878u, 7151u},
 /* T=303K (29.9C) */   {60199u, 58997u, 57807u, 56627u, 55458u, 54300u, 53152u, 52014u, 50887u, 49770u, 48663u, 47567u, 46481u, 45404u, 44338u, 43281u, 42235u, 41198u, 40170u, 39153u, 38145u, 37146u, 36157u, 35177u, 34206u, 33244u, 32292u, 31349u, 30414u, 29489u, 28572u, 27665u, 26766u, 25875u, 24994u, 24120u, 23256u, 22399u, 21551u, 20712u, 19880u, 19057u, 18242u, 17435u, 16636u, 15844u, 15061u, 14285u, 13518u, 12757u, 12005u, 11260u, 10523u, 9793u, 9070u, 8355u},
 /* T=313K (39.9C) */   {60006u, 58845u, 57693u, 56552u, 55421u, 54300u, 53188u, 52086u, 50994u, 49912u, 48839u, 47776u, 46723u, 45678u, 44643u, 43618u, 42601u, 41594u, 40596u, 39607u, 38627u, 37655u, 36693u, 35739u, 34794u, 33858u, 32930u, 32011u, 31100u, 30198u, 29304u, 28418u, 27541u, 26671u, 25810u, 24957u, 24112u, 23275u, 22446u, 21624u, 20811u, 20005u, 19206u, 18416u, 17633u, 16857u, 16089u, 15328u, 14574u, 13828u, 13089u, 12357u, 11633u, 10915u, 10204u, 9501u},
 /* T=323K (49.9C) */   {59826u, 58702u, 57587u, 56482u, 55386u, 54300u, 53222u, 52154u, 51095u, 50046u, 49005u, 47973u, 46950u, 45936u, 44931u, 43934u, 42947u, 41967u, 40997u, 40034u, 39081u, 38135u, 37198u, 36269u, 35349u, 34436u, 33532u, 32636u, 31748u, 30867u, 29995u, 29130u, 28274u, 27424u, 26583u, 25749u, 24923u, 24104u, 23293u, 22489u, 21693u, 20903u, 20121u, 19347u, 18579u, 17819u, 17065u, 16319u, 15579u, 14846u, 14121u, 13402u, 12690u, 11984u, 11285u, 10593u},
  },
  { /* QNH=102400 Pa */
 /* T=263K (-10.1C) */   {61226u, 59832u, 58453u, 57087u, 55736u, 54400u, 53077u, 51767u, 50472u, 49190u, 47922u, 46668u, 45426u, 44198u, 42983u, 41781u, 40592u, 39415u, 38252u, 37101u, 35962u, 34836u, 33722u, 32620u, 31530u, 30452u, 29386u, 28332u, 27289u, 26258u, 25239u, 24231u, 23234u, 22248u, 21273u, 20310u, 19357u, 18415u, 17483u, 16563u, 15652u, 14753u, 13863u, 12984u, 12115u, 11256u, 10407u, 9568u, 8738u, 7919u, 7108u, 6308u, 5517u, 4735u, 3963u, 3199u},
 /* T=273K (-0.1C) */   {60970u, 59629u, 58302u, 56988u, 55687u, 54400u, 53125u, 51863u, 50614u, 49377u, 48154u, 46942u, 45743u, 44557u, 43382u, 42220u, 41069u, 39931u, 38804u, 37689u, 36586u, 35494u, 34414u, 33345u, 32287u, 31241u, 30205u, 29181u, 28167u, 27164u, 26172u, 25190u, 24220u, 23259u, 22309u, 21369u, 20440u, 19520u, 18611u, 17711u, 16821u, 15941u, 15071u, 14211u, 13360u, 12518u, 11686u, 10863u, 10049u, 9244u, 8449u, 7662u, 6885u, 6116u, 5356u, 4604u},
 /* T=283K (9.9C) */   {60732u, 59441u, 58162u, 56896u, 55642u, 54400u, 53170u, 51952u, 50746u, 49551u, 48369u, 47198u, 46039u, 44891u, 43754u, 42629u, 41515u, 40412u, 39320u, 38239u, 37169u, 36110u, 35061u, 34023u, 32996u, 31979u, 30972u, 29976u, 28990u, 28014u, 27048u, 26092u, 25146u, 24209u, 23283u, 22366u, 21458u, 20560u, 19672u, 18793u, 17923u, 17062u, 16211u, 15368u, 14535u, 13710u, 12894u, 12087u, 11289u, 10499u, 9718u, 8945u, 8181u, 7425u, 6677u, 5938u},
 /* T=293K (19.9C) */   {60511u, 59266u, 58032u, 56810u, 55599u, 54400u, 53211u, 52034u, 50869u, 49714u, 48570u, 47437u, 46315u, 45203u, 44102u, 43012u, 41932u, 40863u, 39803u, 38755u, 37716u, 36687u, 35669u, 34660u, 33661u, 32672u, 31693u, 30723u, 29763u, 28813u, 27871u, 26940u, 26017u, 25104u, 24200u, 23305u, 22419u, 21542u, 20673u, 19814u, 18963u, 18121u, 17288u, 16463u, 15646u, 14838u, 14038u, 13247u, 12464u, 11689u, 10921u, 10162u, 9411u, 8668u, 7932u, 7205u},
 /* T=303K (29.9C) */   {60305u, 59102u, 57910u, 56729u, 55559u, 54400u, 53250u, 52112u, 50983u, 49866u, 48758u, 47660u, 46573u, 45496u, 44428u, 43371u, 42323u, 41285u, 40257u, 39238u, 38229u, 37229u, 36239u, 35258u, 34286u, 33324u, 32370u, 31426u, 30491u, 29565u, 28647u, 27739u, 26839u, 25948u, 25065u, 24191u, 23325u, 22468u, 21619u, 20779u, 19947u, 19123u, 18307u, 17499u, 16699u, 15907u, 15123u, 14346u, 13578u, 12817u, 12064u, 11318u, 10580u, 9849u, 9126u, 8410u},
 /* T=313K (39.9C) */   {60112u, 58949u, 57797u, 56654u, 55522u, 54400u, 53287u, 52184u, 51091u, 50008u, 48934u, 47870u, 46815u, 45770u, 44734u, 43707u, 42690u, 41682u, 40683u, 39692u, 38711u, 37739u, 36776u, 35821u, 34875u, 33938u, 33009u, 32089u, 31177u, 30274u, 29379u, 28493u, 27614u, 26744u, 25882u, 25028u, 24183u, 23345u, 22515u, 21692u, 20878u, 20071u, 19272u, 18481u, 17697u, 16920u, 16151u, 15390u, 14636u, 13889u, 13149u, 12416u, 11691u, 10973u, 10261u, 9557u},
 /* T=323K (49.9C) */   {59931u, 58806u, 57690u, 56584u, 55487u, 54400u, 53321u, 52252u, 51192u, 50141u, 49100u, 48067u, 47043u, 46028u, 45022u, 44024u, 43035u, 42055u, 41084u, 40120u, 39166u, 38219u, 37281u, 36352u, 35430u, 34517u, 33612u, 32715u, 31826u, 30944u, 30071u, 29206u, 28348u, 27498u, 26656u, 25821u, 24994u, 24175u, 23363u, 22558u, 21761u, 20971u, 20188u, 19412u, 18644u, 17883u, 17129u, 16381u, 15641u, 14908u, 14181u, 13462u, 12749u, 12043u, 11343u, 10650u},
  },
  { /* QNH=102500 Pa */
 /* T=263K (-10.1C) */   {61333u, 59938u, 58557u, 57190u, 55838u, 54500u, 53175u, 51865u, 50568u, 49285u, 48016u, 46760u, 45517u, 44288u, 43072u, 41869u, 40678u, 39501u, 38336u, 37184u, 36044u, 34917u, 33801u, 32698u, 31608u, 30529u, 29462u, 28406u, 27363u, 26331u, 25310u, 24301u, 23303u, 22317u, 21341u, 20376u, 19423u, 18480u, 17547u, 16626u, 15715u, 14814u, 13924u, 13044u, 12174u, 11314u, 10464u, 9624u, 8794u, 7973u, 7162u, 6361u, 5569u, 4787u, 4013u, 3249u},
 /* T=273K (-0.1C) */   {61076u, 59734u, 58406u, 57091u, 55788u, 54500u, 53224u, 51960u, 50710u, 49472u, 48247u, 47035u, 45835u, 44647u, 43471u, 42308u, 41156u, 40017u, 38889u, 37773u, 36669u, 35576u, 34494u, 33424u, 32366u, 31318u, 30281u, 29256u, 28241u, 27237u, 26244u, 25262u, 24290u, 23329u, 22378u, 21437u, 20506u, 19586u, 18676u, 17775u, 16885u, 16004u, 15133u, 14271u, 13419u, 12577u, 11744u, 10920u, 10106u, 9300u, 8504u, 7717u, 6938u, 6169u, 5408u, 4656u},
 /* T=283K (9.9C) */   {60838u, 59546u, 58266u, 56998u, 55743u, 54500u, 53268u, 52049u, 50842u, 49647u, 48463u, 47291u, 46131u, 44982u, 43844u, 42718u, 41603u, 40499u, 39406u, 38324u, 37253u, 36192u, 35143u, 34104u, 33075u, 32057u, 31050u, 30052u, 29065u, 28088u, 27121u, 26164u, 25217u, 24280u, 23352u, 22434u, 21526u, 20627u, 19738u, 18858u, 17987u, 17126u, 16274u, 15430u, 14596u, 13771u, 12954u, 12146u, 11347u, 10556u, 9774u, 9001u, 8236u, 7479u, 6731u, 5990u},
 /* T=293K (19.9C) */   {60617u, 59370u, 58135u, 56912u, 55700u, 54500u, 53310u, 52132u, 50965u, 49809u, 48664u, 47530u, 46407u, 45294u, 44192u, 43101u, 42020u, 40949u, 39889u, 38839u, 37800u, 36770u, 35750u, 34741u, 33741u, 32751u, 31771u, 30800u, 29839u, 28888u, 27946u, 27013u, 26089u, 25175u, 24270u, 23374u, 22487u, 21609u, 20740u, 19880u, 19029u, 18186u, 17351u, 16526u, 15708u, 14900u, 14099u, 13307u, 12523u, 11747u, 10979u, 10219u, 9467u, 8723u, 7987u, 7259u},
 /* T=303K (29.9C) */   {60410u, 59207u, 58014u, 56832u, 55660u, 54500u, 53349u, 52210u, 51080u, 49961u, 48852u, 47754u, 46665u, 45587u, 44518u, 43460u, 42411u, 41372u, 40343u, 39323u, 38313u, 37312u, 36321u, 35339u, 34367u, 33403u, 32449u, 31504u, 30568u, 29640u, 28722u, 27813u, 26912u, 26020u, 25136u, 24261u, 23395u, 22537u, 21687u, 20846u, 20013u, 19188u, 18371u, 17563u, 16762u, 15969u, 15184u, 14407u, 13638u, 12876u, 12122u, 11376u, 10637u, 9906u, 9182u, 8465u},
 /* T=313K (39.9C) */   {60217u, 59054u, 57900u, 56757u, 55623u, 54500u, 53386u, 52282u, 51188u, 50104u, 49029u, 47964u, 46908u, 45862u, 44825u, 43797u, 42779u, 41769u, 40769u, 39778u, 38796u, 37823u, 36858u, 35903u, 34956u, 34018u, 33088u, 32167u, 31255u, 30351u, 29455u, 28567u, 27688u, 26817u, 25955u, 25100u, 24253u, 23414u, 22583u, 21760u, 20945u, 20138u, 19338u, 18546u, 17761u, 16984u, 16214u, 15452u, 14697u, 13949u, 13209u, 12475u, 11749u, 11030u, 10318u, 9613u},
 /* T=323K (49.9C) */   {60037u, 58910u, 57793u, 56686u, 55588u, 54500u, 53420u, 52350u, 51289u, 50237u, 49195u, 48161u, 47136u, 46120u, 45113u, 44114u, 43124u, 42143u, 41171u, 40206u, 39251u, 38304u, 37365u, 36434u, 35512u, 34598u, 33692u, 32794u, 31904u, 31022u, 30147u, 29281u, 28423u, 27572u, 26729u, 25893u, 25066u, 24245u, 23432u, 22627u, 21829u, 21038u, 20255u, 19478u, 18709u, 17947u, 17192u, 16444u, 15703u, 14969u, 14242u, 13522u, 12808u, 12101u, 11401u, 10708u},
  },
  { /* QNH=102600 Pa */
 /* T=263K (-10.1C) */   {61440u, 60043u, 58661u, 57293u, 55939u, 54600u, 53274u, 51962u, 50664u, 49380u, 48110u, 46853u, 45609u, 44378u, 43161u, 41956u, 40765u, 39586u, 38420u, 37267u, 36126u, 34997u, 33881u, 32777u, 31685u, 30605u, 29537u, 28481u, 27436u, 26403u, 25382u, 24372u, 23373u, 22385u, 21409u, 20443u, 19488u, 18544u, 17611u, 16689u, 15777u, 14875u, 13984u, 13103u, 12232u, 11372u, 10521u, 9680u, 8849u, 8028u, 7216u, 6414u, 5621u, 4838u, 4064u, 3299u},
 /* T=273K (-0.1C) */   {61183u, 59840u, 58510u, 57193u, 55890u, 54600u, 53322u, 52058u, 50806u, 49568u, 48341u, 47128u, 45926u, 44737u, 43561u, 42396u, 41243u, 40103u, 38974u, 37857u, 36751u, 35657u, 34575u, 33504u, 32444u, 31395u, 30358u, 29331u, 28316u, 27311u, 26317u, 25333u, 24361u, 23398u, 22446u, 21505u, 20573u, 19652u, 18741u, 17839u, 16948u, 16066u, 15194u, 14332u, 13479u, 12636u, 11802u, 10978u, 10162u, 9356u, 8559u, 7771u, 6992u, 6221u, 5460u, 4707u},
 /* T=283K (9.9C) */   {60944u, 59651u, 58369u, 57101u, 55844u, 54600u, 53367u, 52147u, 50938u, 49742u, 48557u, 47384u, 46222u, 45072u, 43934u, 42806u, 41690u, 40585u, 39491u, 38408u, 37336u, 36274u, 35224u, 34184u, 33154u, 32135u, 31127u, 30128u, 29140u, 28162u, 27194u, 26237u, 25289u, 24350u, 23422u, 22503u, 21594u, 20694u, 19804u, 18923u, 18052u, 17189u, 16336u, 15492u, 14657u, 13831u, 13013u, 12205u, 11405u, 10614u, 9831u, 9057u, 8291u, 7533u, 6784u, 6043u},
 /* T=293K (19.9C) */   {60723u, 59475u, 58239u, 57014u, 55801u, 54600u, 53409u, 52230u, 51062u, 49905u, 48758u, 47623u, 46499u, 45385u, 44282u, 43190u, 42108u, 41036u, 39975u, 38924u, 37883u, 36853u, 35832u, 34821u, 33821u, 32830u, 31848u, 30877u, 29915u, 28963u, 28020u, 27086u, 26162u, 25247u, 24341u, 23444u, 22556u, 21677u, 20807u, 19946u, 19094u, 18250u, 17415u, 16589u, 15771u, 14961u, 14160u, 13367u, 12582u, 11805u, 11037u, 10276u, 9523u, 8779u, 8042u, 7313u},
 /* T=303K (29.9C) */   {60516u, 59311u, 58117u, 56934u, 55761u, 54600u, 53448u, 52307u, 51177u, 50057u, 48947u, 47847u, 46758u, 45678u, 44609u, 43549u, 42499u, 41459u, 40429u, 39408u, 38397u, 37396u, 36403u, 35421u, 34447u, 33483u, 32527u, 31581u, 30644u, 29716u, 28797u, 27887u, 26985u, 26092u, 25208u, 24332u, 23465u, 22606u, 21755u, 20913u, 20079u, 19254u, 18436u, 17627u, 16825u, 16032u, 15246u, 14468u, 13698u, 12936u, 12181u, 11434u, 10694u, 9962u, 9237u, 8520u},
 /* T=313K (39.9C) */   {60323u, 59158u, 58003u, 56859u, 55724u, 54600u, 53485u, 52380u, 51285u, 50199u, 49123u, 48057u, 47000u, 45953u, 44915u, 43886u, 42867u, 41857u, 40856u, 39864u, 38881u, 37906u, 36941u, 35985u, 35037u, 34098u, 33167u, 32245u, 31332u, 30427u, 29530u, 28642u, 27762u, 26890u, 26027u, 25171u, 24324u, 23484u, 22652u, 21828u, 21012u, 20204u, 19403u, 18610u, 17825u, 17047u, 16277u, 15514u, 14758u, 14010u, 13268u, 12534u, 11808u, 11088u, 10375u, 9669u},
 /* T=323K (49.9C) */   {60142u, 59014u, 57897u, 56788u, 55689u, 54600u, 53519u, 52448u, 51386u, 50333u, 49289u, 48255u, 47229u, 46212u, 45203u, 44204u, 43213u, 42231u, 41258u, 40293u, 39336u, 38388u, 37448u, 36517u, 35593u, 34678u, 33771u, 32872u, 31982u, 31099u, 30224u, 29357u, 28497u, 27646u, 26802u, 25965u, 25137u, 24316u, 23502u, 22696u, 21897u, 21105u, 20321u, 19544u, 18774u, 18012u, 17256u, 16507u, 15766u, 15031u, 14303u, 13582u, 12868u, 12160u, 11459u, 10765u},
  },
  { /* QNH=102700 Pa */
 /* T=263K (-10.1C) */   {61546u, 60148u, 58765u, 57395u, 56040u, 54700u, 53373u, 52060u, 50761u, 49475u, 48203u, 46945u, 45700u, 44468u, 43250u, 42044u, 40851u, 39671u, 38504u, 37350u, 36208u, 35078u, 33961u, 32856u, 31763u, 30682u, 29613u, 28556u, 27510u, 26476u, 25453u, 24442u, 23442u, 22454u, 21476u, 20510u, 19554u, 18609u, 17675u, 16752u, 15839u, 14937u, 14044u, 13163u, 12291u, 11429u, 10578u, 9736u, 8904u, 8082u, 7270u, 6467u, 5674u, 4890u, 4115u, 3349u},
 /* T=273K (-0.1C) */   {61289u, 59945u, 58613u, 57296u, 55991u, 54700u, 53421u, 52155u, 50903u, 49663u, 48435u, 47220u, 46018u, 44828u, 43650u, 42484u, 41330u, 40189u, 39059u, 37940u, 36834u, 35739u, 34655u, 33583u, 32522u, 31473u, 30434u, 29407u, 28390u, 27384u, 26389u, 25405u, 24431u, 23468u, 22515u, 21572u, 20640u, 19718u, 18806u, 17903u, 17011u, 16129u, 15256u, 14393u, 13539u, 12695u, 11861u, 11035u, 10219u, 9412u, 8614u, 7825u, 7045u, 6274u, 5512u, 4758u},
 /* T=283K (9.9C) */   {61051u, 59756u, 58473u, 57203u, 55945u, 54700u, 53466u, 52244u, 51035u, 49837u, 48651u, 47477u, 46314u, 45163u, 44023u, 42895u, 41777u, 40671u, 39576u, 38492u, 37419u, 36356u, 35305u, 34264u, 33233u, 32213u, 31204u, 30204u, 29215u, 28237u, 27268u, 26309u, 25360u, 24421u, 23492u, 22572u, 21662u, 20761u, 19870u, 18989u, 18116u, 17253u, 16399u, 15554u, 14718u, 13891u, 13073u, 12263u, 11463u, 10671u, 9887u, 9112u, 8346u, 7587u, 6837u, 6096u},
 /* T=293K (19.9C) */   {60829u, 59580u, 58343u, 57117u, 55902u, 54700u, 53508u, 52327u, 51158u, 50000u, 48853u, 47716u, 46591u, 45476u, 44372u, 43279u, 42196u, 41123u, 40061u, 39009u, 37967u, 36935u, 35914u, 34902u, 33900u, 32908u, 31926u, 30954u, 29991u, 29038u, 28094u, 27159u, 26234u, 25318u, 24411u, 23514u, 22625u, 21745u, 20875u, 20013u, 19159u, 18315u, 17479u, 16652u, 15833u, 15022u, 14220u, 13426u, 12641u, 11863u, 11094u, 10333u, 9579u, 8834u, 8096u, 7366u},
 /* T=303K (29.9C) */   {60622u, 59416u, 58221u, 57036u, 55863u, 54700u, 53547u, 52405u, 51273u, 50152u, 49041u, 47941u, 46850u, 45769u, 44699u, 43638u, 42587u, 41546u, 40515u, 39493u, 38481u, 37479u, 36486u, 35502u, 34527u, 33562u, 32606u, 31659u, 30721u, 29792u, 28872u, 27961u, 27058u, 26164u, 25279u, 24402u, 23534u, 22675u, 21823u, 20980u, 20146u, 19319u, 18501u, 17691u, 16888u, 16094u, 15308u, 14529u, 13758u, 12995u, 12240u, 11492u, 10751u, 10019u, 9293u, 8575u},
 /* T=313K (39.9C) */   {60428u, 59262u, 58107u, 56961u, 55825u, 54700u, 53584u, 52478u, 51381u, 50295u, 49218u, 48151u, 47093u, 46045u, 45006u, 43976u, 42956u, 41944u, 40942u, 39949u, 38965u, 37990u, 37024u, 36066u, 35118u, 34178u, 33246u, 32324u, 31409u, 30503u, 29606u, 28717u, 27836u, 26963u, 26099u, 25242u, 24394u, 23554u, 22721u, 21896u, 21080u, 20271u, 19469u, 18675u, 17889u, 17110u, 16339u, 15576u, 14819u, 14070u, 13328u, 12593u, 11866u, 11145u, 10432u, 9726u},
 /* T=323K (49.9C) */   {60247u, 59119u, 58000u, 56890u, 55790u, 54700u, 53618u, 52546u, 51483u, 50429u, 49384u, 48348u, 47321u, 46303u, 45294u, 44294u, 43302u, 42319u, 41345u, 40379u, 39421u, 38472u, 37531u, 36599u, 35675u, 34759u, 33851u, 32951u, 32060u, 31176u, 30300u, 29432u, 28572u, 27719u, 26875u, 26038u, 25208u, 24386u, 23572u, 22765u, 21965u, 21173u, 20388u, 19610u, 18839u, 18076u, 17319u, 16570u, 15828u, 15092u, 14364u, 13642u, 12927u, 12219u, 11517u, 10822u},
  },
  { /* QNH=102800 Pa */
 /* T=263K (-10.1C) */   {61653u, 60254u, 58869u, 57498u, 56142u, 54800u, 53471u, 52157u, 50857u, 49570u, 48297u, 47037u, 45791u, 44558u, 43338u, 42132u, 40938u, 39757u, 38589u, 37433u, 36290u, 35159u, 34041u, 32935u, 31841u, 30759u, 29688u, 28630u, 27583u, 26548u, 25525u, 24513u, 23512u, 22522u, 21544u, 20576u, 19620u, 18674u, 17739u, 16815u, 15901u, 14998u, 14105u, 13222u, 12350u, 11487u, 10635u, 9793u, 8960u, 8137u, 7324u, 6520u, 5726u, 4941u, 4166u, 3399u},
 /* T=273K (-0.1C) */   {61396u, 60050u, 58717u, 57398u, 56092u, 54800u, 53520u, 52253u, 50999u, 49758u, 48529u, 47313u, 46109u, 44918u, 43739u, 42572u, 41417u, 40274u, 39143u, 38024u, 36916u, 35820u, 34736u, 33663u, 32601u, 31550u, 30511u, 29482u, 28464u, 27458u, 26462u, 25476u, 24502u, 23537u, 22584u, 21640u, 20707u, 19784u, 18871u, 17968u, 17075u, 16191u, 15318u, 14454u, 13599u, 12754u, 11919u, 11093u, 10276u, 9468u, 8669u, 7880u, 7099u, 6327u, 5564u, 4810u},
 /* T=283K (9.9C) */   {61157u, 59861u, 58577u, 57305u, 56046u, 54800u, 53565u, 52342u, 51131u, 49932u, 48745u, 47570u, 46406u, 45254u, 44113u, 42983u, 41865u, 40758u, 39661u, 38576u, 37502u, 36439u, 35386u, 34344u, 33312u, 32291u, 31281u, 30281u, 29291u, 28311u, 27341u, 26381u, 25431u, 24491u, 23561u, 22641u, 21730u, 20828u, 19936u, 19054u, 18181u, 17317u, 16462u, 15616u, 14779u, 13951u, 13132u, 12322u, 11521u, 10728u, 9944u, 9168u, 8401u, 7642u, 6891u, 6148u},
 /* T=293K (19.9C) */   {60935u, 59685u, 58446u, 57219u, 56004u, 54800u, 53607u, 52425u, 51255u, 50095u, 48947u, 47810u, 46683u, 45567u, 44462u, 43367u, 42283u, 41210u, 40146u, 39093u, 38051u, 37018u, 35995u, 34983u, 33980u, 32987u, 32004u, 31031u, 30067u, 29113u, 28168u, 27232u, 26306u, 25389u, 24482u, 23583u, 22694u, 21813u, 20942u, 20079u, 19225u, 18379u, 17543u, 16715u, 15895u, 15084u, 14281u, 13486u, 12700u, 11922u, 11152u, 10390u, 9635u, 8889u, 8151u, 7420u},
 /* T=303K (29.9C) */   {60728u, 59520u, 58324u, 57139u, 55964u, 54800u, 53646u, 52503u, 51370u, 50248u, 49136u, 48034u, 46942u, 45861u, 44789u, 43727u, 42676u, 41634u, 40601u, 39579u, 38566u, 37562u, 36568u, 35583u, 34608u, 33641u, 32684u, 31737u, 30798u, 29868u, 28947u, 28034u, 27131u, 26236u, 25350u, 24473u, 23604u, 22743u, 21891u, 21048u, 20212u, 19385u, 18566u, 17755u, 16951u, 16156u, 15369u, 14590u, 13818u, 13054u, 12298u, 11550u, 10809u, 10075u, 9349u, 8630u},
 /* T=313K (39.9C) */   {60534u, 59367u, 58210u, 57063u, 55926u, 54800u, 53683u, 52576u, 51478u, 50391u, 49313u, 48244u, 47186u, 46136u, 45096u, 44066u, 43044u, 42032u, 41029u, 40035u, 39050u, 38074u, 37107u, 36148u, 35199u, 34258u, 33326u, 32402u, 31487u, 30580u, 29682u, 28792u, 27910u, 27036u, 26171u, 25314u, 24464u, 23623u, 22790u, 21965u, 21147u, 20337u, 19535u, 18740u, 17953u, 17174u, 16402u, 15637u, 14880u, 14130u, 13388u, 12652u, 11924u, 11203u, 10489u, 9782u},
 /* T=323K (49.9C) */   {60353u, 59223u, 58103u, 56992u, 55891u, 54800u, 53717u, 52644u, 51580u, 50525u, 49479u, 48442u, 47414u, 46395u, 45385u, 44384u, 43391u, 42407u, 41432u, 40465u, 39506u, 38556u, 37615u, 36681u, 35756u, 34839u, 33931u, 33030u, 32137u, 31253u, 30376u, 29507u, 28646u, 27793u, 26948u, 26110u, 25279u, 24457u, 23641u, 22834u, 22033u, 21240u, 20454u, 19676u, 18904u, 18140u, 17383u, 16633u, 15890u, 15154u, 14424u, 13702u, 12986u, 12277u, 11575u, 10879u},
  },
  { /* QNH=102900 Pa */
 /* T=263K (-10.1C) */   {61760u, 60359u, 58973u, 57601u, 56243u, 54900u, 53570u, 52255u, 50953u, 49665u, 48391u, 47130u, 45882u, 44648u, 43427u, 42219u, 41024u, 39842u, 38673u, 37516u, 36372u, 35240u, 34121u, 33013u, 31918u, 30835u, 29764u, 28705u, 27657u, 26621u, 25596u, 24583u, 23581u, 22591u, 21611u, 20643u, 19686u, 18739u, 17803u, 16878u, 15963u, 15059u, 14165u, 13282u, 12408u, 11545u, 10692u, 9849u, 9015u, 8192u, 7378u, 6573u, 5778u, 4993u, 4216u, 3449u},
 /* T=273K (-0.1C) */   {61502u, 60155u, 58821u, 57501u, 56194u, 54900u, 53619u, 52351u, 51095u, 49853u, 48623u, 47406u, 46201u, 45009u, 43828u, 42660u, 41504u, 40360u, 39228u, 38108u, 36999u, 35902u, 34816u, 33742u, 32679u, 31627u, 30587u, 29557u, 28539u, 27531u, 26534u, 25548u, 24572u, 23607u, 22652u, 21708u, 20774u, 19850u, 18936u, 18032u, 17138u, 16254u, 15379u, 14514u, 13659u, 12813u, 11977u, 11150u, 10332u, 9524u, 8725u, 7934u, 7153u, 6380u, 5616u, 4861u},
 /* T=283K (9.9C) */   {61263u, 59966u, 58680u, 57408u, 56148u, 54900u, 53664u, 52440u, 51228u, 50028u, 48839u, 47663u, 46498u, 45344u, 44202u, 43072u, 41952u, 40844u, 39747u, 38661u, 37585u, 36521u, 35467u, 34424u, 33392u, 32370u, 31358u, 30357u, 29366u, 28385u, 27414u, 26454u, 25503u, 24562u, 23631u, 22709u, 21798u, 20895u, 20002u, 19119u, 18245u, 17380u, 16524u, 15678u, 14840u, 14012u, 13192u, 12381u, 11579u, 10785u, 10000u, 9223u, 8455u, 7696u, 6944u, 6201u},
 /* T=293K (19.9C) */   {61041u, 59789u, 58550u, 57321u, 56105u, 54900u, 53706u, 52523u, 51351u, 50191u, 49041u, 47903u, 46775u, 45658u, 44552u, 43456u, 42371u, 41296u, 40232u, 39178u, 38134u, 37101u, 36077u, 35064u, 34060u, 33066u, 32082u, 31108u, 30143u, 29188u, 28242u, 27306u, 26379u, 25461u, 24552u, 23653u, 22763u, 21881u, 21009u, 20145u, 19290u, 18444u, 17606u, 16778u, 15957u, 15145u, 14341u, 13546u, 12759u, 11980u, 11209u, 10446u, 9692u, 8945u, 8206u, 7474u},
 /* T=303K (29.9C) */   {60833u, 59625u, 58427u, 57241u, 56065u, 54900u, 53745u, 52601u, 51467u, 50343u, 49230u, 48127u, 47035u, 45952u, 44879u, 43817u, 42764u, 41721u, 40688u, 39664u, 38650u, 37645u, 36650u, 35664u, 34688u, 33721u, 32763u, 31814u, 30874u, 29943u, 29022u, 28108u, 27204u, 26309u, 25422u, 24543u, 23674u, 22812u, 21959u, 21115u, 20278u, 19450u, 18630u, 17818u, 17015u, 16219u, 15431u, 14651u, 13878u, 13114u, 12357u, 11608u, 10866u, 10131u, 9405u, 8685u},
 /* T=313K (39.9C) */   {60640u, 59471u, 58313u, 57165u, 56027u, 54900u, 53782u, 52673u, 51575u, 50486u, 49407u, 48338u, 47278u, 46228u, 45187u, 44155u, 43133u, 42120u, 41116u, 40121u, 39135u, 38158u, 37189u, 36230u, 35280u, 34338u, 33405u, 32480u, 31564u, 30656u, 29757u, 28866u, 27984u, 27109u, 26243u, 25385u, 24535u, 23693u, 22859u, 22033u, 21214u, 20403u, 19601u, 18805u, 18017u, 17237u, 16465u, 15699u, 14941u, 14191u, 13448u, 12711u, 11982u, 11261u, 10546u, 9838u},
 /* T=323K (49.9C) */   {60458u, 59327u, 58206u, 57095u, 55992u, 54900u, 53816u, 52742u, 51677u, 50621u, 49574u, 48536u, 47507u, 46487u, 45476u, 44474u, 43480u, 42495u, 41519u, 40551u, 39591u, 38640u, 37698u, 36764u, 35838u, 34920u, 34010u, 33109u, 32215u, 31330u, 30452u, 29583u, 28721u, 27867u, 27020u, 26182u, 25351u, 24527u, 23711u, 22903u, 22101u, 21307u, 20521u, 19742u, 18970u, 18205u, 17447u, 16696u, 15952u, 15215u, 14485u, 13762u, 13046u, 12336u, 11633u, 10937u},
  },
  { /* QNH=103000 Pa */
 /* T=263K (-10.1C) */   {61866u, 60464u, 59076u, 57703u, 56344u, 55000u, 53669u, 52352u, 51049u, 49760u, 48484u, 47222u, 45974u, 44738u, 43516u, 42307u, 41111u, 39928u, 38757u, 37599u, 36454u, 35321u, 34200u, 33092u, 31996u, 30912u, 29840u, 28779u, 27730u, 26693u, 25668u, 24654u, 23651u, 22660u, 21679u, 20710u, 19751u, 18804u, 17867u, 16941u, 16025u, 15120u, 14226u, 13341u, 12467u, 11603u, 10749u, 9905u, 9071u, 8246u, 7431u, 6626u, 5830u, 5044u, 4267u, 3499u},
 /* T=273K (-0.1C) */   {61608u, 60260u, 58925u, 57603u, 56295u, 55000u, 53717u, 52448u, 51192u, 49948u, 48717u, 47499u, 46293u, 45099u, 43918u, 42748u, 41591u, 40446u, 39313u, 38191u, 37082u, 35983u, 34897u, 33822u, 32758u, 31705u, 30663u, 29633u, 28613u, 27604u, 26607u, 25619u, 24643u, 23677u, 22721u, 21776u, 20841u, 19916u, 19001u, 18096u, 17201u, 16316u, 15441u, 14575u, 13719u, 12873u, 12035u, 11208u, 10389u, 9580u, 8780u, 7988u, 7206u, 6433u, 5668u, 4912u},
 /* T=283K (9.9C) */   {61369u, 60070u, 58784u, 57510u, 56249u, 55000u, 53762u, 52537u, 51324u, 50123u, 48934u, 47756u, 46590u, 45435u, 44292u, 43160u, 42040u, 40930u, 39832u, 38745u, 37668u, 36603u, 35548u, 34504u, 33471u, 32448u, 31435u, 30433u, 29441u, 28459u, 27488u, 26526u, 25574u, 24632u, 23700u, 22778u, 21865u, 20962u, 20069u, 19184u, 18309u, 17444u, 16587u, 15740u, 14901u, 14072u, 13251u, 12440u, 11636u, 10842u, 10056u, 9279u, 8510u, 7750u, 6998u, 6254u},
 /* T=293K (19.9C) */   {61147u, 59894u, 58653u, 57424u, 56206u, 55000u, 53804u, 52621u, 51448u, 50286u, 49136u, 47996u, 46867u, 45749u, 44642u, 43545u, 42459u, 41383u, 40318u, 39263u, 38218u, 37183u, 36159u, 35144u, 34140u, 33145u, 32160u, 31184u, 30219u, 29263u, 28316u, 27379u, 26451u, 25532u, 24623u, 23723u, 22831u, 21949u, 21076u, 20211u, 19356u, 18509u, 17670u, 16840u, 16019u, 15206u, 14402u, 13606u, 12818u, 12038u, 11267u, 10503u, 9748u, 9000u, 8260u, 7528u},
 /* T=303K (29.9C) */   {60939u, 59730u, 58531u, 57343u, 56166u, 55000u, 53844u, 52698u, 51563u, 50439u, 49325u, 48221u, 47127u, 46043u, 44970u, 43906u, 42852u, 41808u, 40774u, 39749u, 38734u, 37729u, 36732u, 35746u, 34768u, 33800u, 32841u, 31892u, 30951u, 30019u, 29096u, 28182u, 27277u, 26381u, 25493u, 24614u, 23743u, 22881u, 22027u, 21182u, 20345u, 19516u, 18695u, 17882u, 17078u, 16281u, 15492u, 14712u, 13939u, 13173u, 12416u, 11665u, 10923u, 10188u, 9460u, 8740u},
 /* T=313K (39.9C) */   {60745u, 59576u, 58417u, 57268u, 56129u, 55000u, 53880u, 52771u, 51672u, 50582u, 49502u, 48432u, 47371u, 46319u, 45277u, 44245u, 43221u, 42207u, 41202u, 40206u, 39219u, 38241u, 37272u, 36312u, 35361u, 34418u, 33484u, 32558u, 31641u, 30733u, 29833u, 28941u, 28058u, 27182u, 26315u, 25456u, 24605u, 23763u, 22928u, 22101u, 21281u, 20470u, 19666u, 18870u, 18082u, 17301u, 16527u, 15761u, 15003u, 14251u, 13507u, 12770u, 12041u, 11318u, 10603u, 9894u},
 /* T=323K (49.9C) */   {60564u, 59432u, 58309u, 57197u, 56093u, 55000u, 53915u, 52840u, 51773u, 50717u, 49669u, 48630u, 47600u, 46579u, 45567u, 44563u, 43569u, 42583u, 41606u, 40637u, 39676u, 38725u, 37781u, 36846u, 35919u, 35001u, 34090u, 33188u, 32293u, 31407u, 30529u, 29658u, 28795u, 27941u, 27093u, 26254u, 25422u, 24598u, 23781u, 22971u, 22169u, 21375u, 20588u, 19807u, 19035u, 18269u, 17510u, 16759u, 16014u, 15277u, 14546u, 13822u, 13105u, 12395u, 11691u, 10994u},
  },
  { /* QNH=103100 Pa */
 /* T=263K (-10.1C) */   {61973u, 60569u, 59180u, 57806u, 56446u, 55100u, 53767u, 52449u, 51145u, 49855u, 48578u, 47315u, 46065u, 44828u, 43605u, 42395u, 41197u, 40013u, 38841u, 37682u, 36536u, 35402u, 34280u, 33171u, 32074u, 30988u, 29915u, 28854u, 27804u, 26766u, 25739u, 24724u, 23721u, 22728u, 21747u, 20777u, 19817u, 18869u, 17931u, 17004u, 16088u, 15182u, 14286u, 13401u, 12526u, 11661u, 10806u, 9961u, 9126u, 8301u, 7485u, 6679u, 5883u, 5096u, 4318u, 3549u},
 /* T=273K (-0.1C) */   {61715u, 60365u, 59029u, 57706u, 56396u, 55100u, 53816u, 52546u, 51288u, 50043u, 48811u, 47591u, 46384u, 45189u, 44007u, 42837u, 41678u, 40532u, 39398u, 38275u, 37164u, 36065u, 34977u, 33901u, 32836u, 31782u, 30740u, 29708u, 28688u, 27678u, 26679u, 25691u, 24713u, 23746u, 22790u, 21843u, 20907u, 19982u, 19066u, 18160u, 17264u, 16379u, 15502u, 14636u, 13779u, 12932u, 12094u, 11265u, 10446u, 9636u, 8835u, 8043u, 7260u, 6486u, 5720u, 4964u},
 /* T=283K (9.9C) */   {61475u, 60175u, 58888u, 57613u, 56350u, 55100u, 53861u, 52635u, 51421u, 50218u, 49028u, 47849u, 46682u, 45526u, 44382u, 43249u, 42127u, 41017u, 39917u, 38829u, 37752u, 36685u, 35629u, 34584u, 33550u, 32526u, 31512u, 30509u, 29516u, 28533u, 27561u, 26598u, 25646u, 24703u, 23770u, 22847u, 21933u, 21029u, 20135u, 19249u, 18374u, 17507u, 16650u, 15802u, 14962u, 14132u, 13311u, 12498u, 11694u, 10899u, 10113u, 9335u, 8565u, 7804u, 7051u, 6306u},
 /* T=293K (19.9C) */   {61253u, 59999u, 58757u, 57526u, 56307u, 55100u, 53903u, 52718u, 51544u, 50382u, 49230u, 48089u, 46959u, 45840u, 44732u, 43634u, 42547u, 41470u, 40404u, 39348u, 38302u, 37266u, 36241u, 35225u, 34219u, 33224u, 32238u, 31261u, 30295u, 29338u, 28390u, 27452u, 26523u, 25604u, 24693u, 23792u, 22900u, 22017u, 21143u, 20277u, 19421u, 18573u, 17734u, 16903u, 16081u, 15268u, 14463u, 13666u, 12877u, 12097u, 11324u, 10560u, 9804u, 9055u, 8315u, 7582u},
 /* T=303K (29.9C) */   {61045u, 59834u, 58634u, 57445u, 56267u, 55100u, 53943u, 52796u, 51660u, 50535u, 49419u, 48314u, 47219u, 46135u, 45060u, 43995u, 42940u, 41895u, 40860u, 39834u, 38818u, 37812u, 36815u, 35827u, 34849u, 33880u, 32920u, 31969u, 31028u, 30095u, 29171u, 28256u, 27350u, 26453u, 25564u, 24684u, 23813u, 22950u, 22095u, 21249u, 20411u, 19581u, 18760u, 17946u, 17141u, 16344u, 15554u, 14772u, 13999u, 13233u, 12474u, 11723u, 10980u, 10244u, 9516u, 8795u},
 /* T=313K (39.9C) */   {60851u, 59680u, 58520u, 57370u, 56230u, 55100u, 53979u, 52869u, 51769u, 50678u, 49597u, 48525u, 47463u, 46411u, 45368u, 44334u, 43310u, 42295u, 41289u, 40292u, 39304u, 38325u, 37355u, 36394u, 35442u, 34498u, 33563u, 32636u, 31719u, 30809u, 29908u, 29016u, 28131u, 27255u, 26387u, 25528u, 24676u, 23832u, 22997u, 22169u, 21349u, 20536u, 19732u, 18935u, 18146u, 17364u, 16590u, 15823u, 15064u, 14312u, 13567u, 12829u, 12099u, 11376u, 10660u, 9950u},
 /* T=323K (49.9C) */   {60669u, 59536u, 58413u, 57299u, 56194u, 55100u, 54014u, 52938u, 51870u, 50812u, 49763u, 48724u, 47693u, 46671u, 45658u, 44653u, 43658u, 42671u, 41693u, 40723u, 39762u, 38809u, 37864u, 36928u, 36001u, 35081u, 34170u, 33267u, 32371u, 31484u, 30605u, 29734u, 28870u, 28014u, 27166u, 26326u, 25493u, 24668u, 23850u, 23040u, 22238u, 21442u, 20654u, 19873u, 19100u, 18333u, 17574u, 16822u, 16076u, 15338u, 14607u, 13882u, 13164u, 12453u, 11749u, 11051u},
  },
  { /* QNH=103200 Pa */
 /* T=263K (-10.1C) */   {62080u, 60675u, 59284u, 57908u, 56547u, 55200u, 53866u, 52547u, 51241u, 49950u, 48672u, 47407u, 46156u, 44918u, 43694u, 42482u, 41284u, 40098u, 38926u, 37765u, 36618u, 35483u, 34360u, 33250u, 32151u, 31065u, 29991u, 28928u, 27878u, 26838u, 25811u, 24795u, 23790u, 22797u, 21814u, 20843u, 19883u, 18934u, 17995u, 17067u, 16150u, 15243u, 14347u, 13460u, 12585u, 11719u, 10863u, 10017u, 9182u, 8355u, 7539u, 6732u, 5935u, 5147u, 4369u, 3599u},
 /* T=273K (-0.1C) */   {61821u, 60470u, 59133u, 57808u, 56497u, 55200u, 53915u, 52643u, 51384u, 50138u, 48905u, 47684u, 46476u, 45280u, 44096u, 42925u, 41765u, 40618u, 39482u, 38359u, 37247u, 36147u, 35058u, 33980u, 32914u, 31860u, 30816u, 29783u, 28762u, 27751u, 26751u, 25762u, 24784u, 23816u, 22858u, 21911u, 20974u, 20048u, 19131u, 18224u, 17328u, 16441u, 15564u, 14697u, 13839u, 12991u, 12152u, 11323u, 10503u, 9692u, 8890u, 8097u, 7313u, 6539u, 5773u, 5015u},
 /* T=283K (9.9C) */   {61582u, 60280u, 58991u, 57715u, 56451u, 55200u, 53960u, 52733u, 51517u, 50314u, 49122u, 47942u, 46773u, 45617u, 44471u, 43337u, 42214u, 41103u, 40003u, 38913u, 37835u, 36767u, 35710u, 34664u, 33629u, 32604u, 31589u, 30585u, 29591u, 28608u, 27634u, 26671u, 25717u, 24773u, 23840u, 22915u, 22001u, 21096u, 20201u, 19315u, 18438u, 17571u, 16713u, 15863u, 15023u, 14192u, 13370u, 12557u, 11752u, 10956u, 10169u, 9390u, 8620u, 7858u, 7104u, 6359u},
 /* T=293K (19.9C) */   {61359u, 60104u, 58860u, 57629u, 56408u, 55200u, 54002u, 52816u, 51641u, 50477u, 49324u, 48182u, 47051u, 45931u, 44822u, 43723u, 42635u, 41557u, 40489u, 39432u, 38385u, 37349u, 36322u, 35306u, 34299u, 33302u, 32315u, 31338u, 30371u, 29413u, 28464u, 27525u, 26595u, 25675u, 24764u, 23862u, 22969u, 22085u, 21210u, 20344u, 19486u, 18638u, 17798u, 16966u, 16144u, 15329u, 14523u, 13725u, 12936u, 12155u, 11382u, 10617u, 9860u, 9111u, 8369u, 7636u},
 /* T=303K (29.9C) */   {61151u, 59939u, 58738u, 57548u, 56368u, 55200u, 54041u, 52894u, 51757u, 50630u, 49514u, 48408u, 47312u, 46226u, 45150u, 44084u, 43029u, 41982u, 40946u, 39919u, 38902u, 37895u, 36897u, 35908u, 34929u, 33959u, 32998u, 32047u, 31104u, 30171u, 29246u, 28330u, 27423u, 26525u, 25636u, 24755u, 23883u, 23019u, 22163u, 21316u, 20477u, 19647u, 18825u, 18010u, 17204u, 16406u, 15616u, 14833u, 14059u, 13292u, 12533u, 11781u, 11037u, 10301u, 9572u, 8850u},
 /* T=313K (39.9C) */   {60956u, 59785u, 58623u, 57472u, 56331u, 55200u, 54078u, 52967u, 51865u, 50774u, 49691u, 48619u, 47556u, 46503u, 45459u, 44424u, 43398u, 42382u, 41375u, 40377u, 39389u, 38409u, 37438u, 36476u, 35522u, 34578u, 33642u, 32715u, 31796u, 30886u, 29984u, 29090u, 28205u, 27328u, 26460u, 25599u, 24746u, 23902u, 23065u, 22237u, 21416u, 20603u, 19798u, 19000u, 18210u, 17427u, 16653u, 15885u, 15125u, 14372u, 13627u, 12888u, 12157u, 11433u, 10716u, 10007u},
 /* T=323K (49.9C) */   {60774u, 59640u, 58516u, 57401u, 56296u, 55200u, 54113u, 53035u, 51967u, 50908u, 49858u, 48817u, 47786u, 46763u, 45748u, 44743u, 43747u, 42759u, 41780u, 40809u, 39847u, 38893u, 37948u, 37011u, 36082u, 35162u, 34249u, 33345u, 32449u, 31561u, 30681u, 29809u, 28945u, 28088u, 27239u, 26398u, 25565u, 24739u, 23920u, 23109u, 22306u, 21510u, 20721u, 19939u, 19165u, 18398u, 17638u, 16884u, 16138u, 15399u, 14667u, 13942u, 13224u, 12512u, 11807u, 11108u},
  },
  { /* QNH=103300 Pa */
 /* T=263K (-10.1C) */   {62186u, 60780u, 59388u, 58011u, 56648u, 55300u, 53965u, 52644u, 51338u, 50045u, 48765u, 47500u, 46247u, 45008u, 43783u, 42570u, 41370u, 40184u, 39010u, 37849u, 36700u, 35564u, 34440u, 33328u, 32229u, 31142u, 30066u, 29003u, 27951u, 26911u, 25882u, 24865u, 23860u, 22865u, 21882u, 20910u, 19949u, 18998u, 18059u, 17130u, 16212u, 15304u, 14407u, 13520u, 12643u, 11777u, 10920u, 10074u, 9237u, 8410u, 7593u, 6785u, 5987u, 5199u, 4419u, 3649u},
 /* T=273K (-0.1C) */   {61928u, 60575u, 59236u, 57911u, 56599u, 55300u, 54014u, 52741u, 51481u, 50233u, 48999u, 47777u, 46567u, 45370u, 44185u, 43013u, 41852u, 40704u, 39567u, 38442u, 37329u, 36228u, 35138u, 34060u, 32993u, 31937u, 30892u, 29859u, 28836u, 27825u, 26824u, 25834u, 24854u, 23885u, 22927u, 21979u, 21041u, 20113u, 19196u, 18289u, 17391u, 16503u, 15626u, 14757u, 13899u, 13050u, 12210u, 11380u, 10559u, 9748u, 8945u, 8152u, 7367u, 6591u, 5825u, 5067u},
 /* T=283K (9.9C) */   {61688u, 60385u, 59095u, 57818u, 56552u, 55300u, 54059u, 52830u, 51613u, 50409u, 49216u, 48035u, 46865u, 45707u, 44561u, 43426u, 42302u, 41189u, 40088u, 38997u, 37918u, 36849u, 35792u, 34744u, 33708u, 32682u, 31666u, 30661u, 29667u, 28682u, 27707u, 26743u, 25789u, 24844u, 23909u, 22984u, 22069u, 21163u, 20267u, 19380u, 18502u, 17634u, 16775u, 15925u, 15084u, 14253u, 13430u, 12616u, 11810u, 11013u, 10225u, 9446u, 8675u, 7912u, 7158u, 6412u},
 /* T=293K (19.9C) */   {61465u, 60208u, 58964u, 57731u, 56509u, 55300u, 54101u, 52914u, 51738u, 50573u, 49419u, 48276u, 47144u, 46022u, 44912u, 43812u, 42722u, 41644u, 40575u, 39517u, 38469u, 37432u, 36404u, 35386u, 34379u, 33381u, 32393u, 31415u, 30447u, 29488u, 28538u, 27598u, 26668u, 25746u, 24834u, 23931u, 23038u, 22153u, 21277u, 20410u, 19552u, 18702u, 17862u, 17029u, 16206u, 15391u, 14584u, 13785u, 12995u, 12213u, 11439u, 10674u, 9916u, 9166u, 8424u, 7690u},
 /* T=303K (29.9C) */   {61256u, 60043u, 58841u, 57650u, 56469u, 55300u, 54140u, 52992u, 51853u, 50726u, 49608u, 48501u, 47404u, 46317u, 45240u, 44174u, 43117u, 42070u, 41032u, 40005u, 38987u, 37978u, 36979u, 35990u, 35009u, 34039u, 33077u, 32124u, 31181u, 30246u, 29321u, 28404u, 27497u, 26597u, 25707u, 24825u, 23952u, 23088u, 22231u, 21383u, 20544u, 19713u, 18889u, 18074u, 17267u, 16468u, 15677u, 14894u, 14119u, 13351u, 12591u, 11839u, 11095u, 10357u, 9628u, 8906u},
 /* T=313K (39.9C) */   {61062u, 59889u, 58727u, 57574u, 56432u, 55300u, 54177u, 53065u, 51962u, 50869u, 49786u, 48713u, 47649u, 46594u, 45549u, 44513u, 43487u, 42470u, 41462u, 40463u, 39473u, 38493u, 37521u, 36558u, 35603u, 34658u, 33721u, 32793u, 31873u, 30962u, 30059u, 29165u, 28279u, 27401u, 26532u, 25670u, 24817u, 23972u, 23134u, 22305u, 21483u, 20669u, 19863u, 19065u, 18274u, 17491u, 16715u, 15947u, 15186u, 14433u, 13686u, 12947u, 12216u, 11491u, 10773u, 10063u},
 /* T=323K (49.9C) */   {60880u, 59745u, 58619u, 57503u, 56397u, 55300u, 54212u, 53133u, 52064u, 51004u, 49953u, 48911u, 47878u, 46854u, 45839u, 44833u, 43836u, 42847u, 41867u, 40895u, 39932u, 38977u, 38031u, 37093u, 36164u, 35242u, 34329u, 33424u, 32527u, 31638u, 30757u, 29884u, 29019u, 28162u, 27312u, 26470u, 25636u, 24809u, 23990u, 23178u, 22374u, 21577u, 20787u, 20005u, 19230u, 18462u, 17701u, 16947u, 16201u, 15461u, 14728u, 14002u, 13283u, 12570u, 11865u, 11166u},
  },
  { /* QNH=103400 Pa */
 /* T=263K (-10.1C) */   {62293u, 60885u, 59492u, 58114u, 56750u, 55400u, 54064u, 52742u, 51434u, 50140u, 48859u, 47592u, 46339u, 45098u, 43872u, 42658u, 41457u, 40269u, 39094u, 37932u, 36782u, 35645u, 34520u, 33407u, 32307u, 31218u, 30142u, 29077u, 28025u, 26983u, 25954u, 24936u, 23929u, 22934u, 21950u, 20977u, 20015u, 19063u, 18123u, 17193u, 16274u, 15365u, 14467u, 13580u, 12702u, 11835u, 10977u, 10130u, 9292u, 8465u, 7647u, 6838u, 6039u, 5250u, 4470u, 3699u},
 /* T=273K (-0.1C) */   {62034u, 60680u, 59340u, 58013u, 56700u, 55400u, 54112u, 52838u, 51577u, 50328u, 49093u, 47869u, 46659u, 45460u, 44275u, 43101u, 41939u, 40790u, 39652u, 38526u, 37412u, 36310u, 35219u, 34139u, 33071u, 32014u, 30969u, 29934u, 28911u, 27898u, 26896u, 25905u, 24925u, 23955u, 22996u, 22047u, 21108u, 20179u, 19261u, 18353u, 17454u, 16566u, 15687u, 14818u, 13959u, 13109u, 12269u, 11438u, 10616u, 9803u, 9000u, 8206u, 7421u, 6644u, 5877u, 5118u},
 /* T=283K (9.9C) */   {61794u, 60490u, 59199u, 57920u, 56654u, 55400u, 54158u, 52928u, 51710u, 50504u, 49310u, 48128u, 46957u, 45798u, 44650u, 43514u, 42389u, 41276u, 40173u, 39082u, 38001u, 36931u, 35873u, 34825u, 33787u, 32760u, 31744u, 30738u, 29742u, 28756u, 27781u, 26815u, 25860u, 24914u, 23979u, 23053u, 22137u, 21230u, 20333u, 19445u, 18567u, 17698u, 16838u, 15987u, 15146u, 14313u, 13489u, 12674u, 11868u, 11071u, 10282u, 9502u, 8730u, 7966u, 7211u, 6464u},
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
