c4deszes/bike-rotor-sensor/(commit log)

2021-10-30 Initial hardware commit (#2)
    [rotor-sensor.kicad_pcb, rotor-sensor.sch]
2021-10-30 Software refactoring and documentation (#1)
    * Moves software workflow to the correct folder
    * Adds signals and rpc code generator tool
    * Scheduler changed to only have 1ms and 10ms tasks
    * Documents a bunch of low level components
    * Merges sensor library into application
    * Adds RTC component
    * Documentation changes
    * Usart configuration
    * Adds devcontainer configuration
    [board.c, config.h, init.c, tasks.c, usart.c]
2021-11-05 Second hardware iteration (#3)
    Cleaned up the schematic and reworked the entire PCB.
    Replaced EE-SX1083 with EE-SX199, added 3D model and new component.
    Added modified worksheet so that the PCB origin can be 0, 0.
    Added scripts to execute certain tasks locally and updated the workflow accordingly.
    Workflow now runs for the different variants.
    The KiBot configuration has been merged into a single file.
    *Increased clearance between Slot sensor and PCB edge
    Assigned component values to remaining components.
    Connectors will now only be placed in the DEBUG variant
    Rotated input filter capacitor for better ground connection
    Adds panelization and panel configuration
    Adds fiducials to boa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
    [rotor-sensor.kicad_pcb, rotor-sensor.sch]
2021-11-06 Documentation changes (#4)
    CMakePresets and configuration mechanism have been updated
    BSP UART config now depends on the board variant
    BSP correctly selects the MCU type based on board type
    [board.c, init.c, tasks.c, usart.c]
2021-11-14 Bootloader development (#5)
    Updated existing profiles and added build presets for bootloader development.
    Application can be merged with the bootloader hex file.
    Scheduler now has default task, so 1ms and 10ms don't have to be defined.
    Added CPUINT component to HAL that allows Interrupt vector table selection.
    Software reset uses CCP to access the SWRR register.
    Working bootloader with jump functionality
    Removes option to enable the bootloader in the application code.
    Adds application helper cmake file that can generate hex, bin, etc.
    Renamed bootloader target to isolate it from the application.
    LTO is now enabled for all non debug variants.
    Removes debug variant as it's out of fla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
    [board.c, tasks.c]
2022-05-01 Adds LIN Transceiver to the design (#7)
    Updates layout and schematic, replaced test point labels on schematic
    Adds overcurrent protection IC and removes sense line
    Hardware container version downgrade, KiKit downgrade
    Hardware workflow retention day set to 5 days and
    STEP generation step is skipped due to errors
    Fixes track clearance issue on panelized layout
    Tight frame and 1x4 panel layout
    [rotor-sensor.kicad_pcb, rotor-sensor.sch]
2022-11-30 New sensor settings (#8)
    * Making the software work again
    Fixes application region size in the Bootloader
    Implements User LED functions
    Fixes typo in Input stage handler analog variant
    TCB now uses the syncup feature and ISH will also initialize TCA
    Fixes Usart byte size in full duplex mode
    * Sensors working, added temp. sensing
    * LIN Trans. power down mode
    Consolidates VCOM pins, added CS pin
    Disables temperature measurement
    Removes OSH current measurement
    * Sensor calculation
    Changed sensor parameter flow
    Disabled position estimator
    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
    [board.c, config.h, init.c, tasks.c, usart.c]
2022-11-30 PCB test probe schematic (#10)
    [pcb-probe.sch]
2023-01-01 Mechanical parts and tools
    [Assembly.stl, Base.stl, Cover.stl, Hinge.stl, MotorHolder.stl, Mount.stl, PcbCover.stl, ProbeBottomHolder.stl]
2024-10-27 Gen2 development halt (#17)
    * Gen2 Hardware design (#11)
    - Dual PCB construction
    - 2 Channel speed sensing using 2 or 3 wire hall/optical sensors
    - Included IMU
    - More powerful processor
    * Prototype software (#12)
    * TC3-4 captures period and width in us resolution
    * Working scheduler
    * Working output stage control
    * SEC - sensor initialization startup and state readback
    * DFLL - Initialization moved to SYSCTRL
    * PM - CPU and Bus clock division function
    * BSP - Moved clock settings out of Init
    * BSP - Moved pin settings to pinout.h
    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
    [B02B-JWPF-SK-R.step, B03B-JWPF-SK-R.STEP, B04B-JWPF-SK-R.step, board.cfg, connector-pcb.kicad_pcb, connector-pcb.kicad_sch, factory-flash.cfg, optical-sensor.kicad_pcb]
2025-10-19 Dev/gen2.1 (#19)
    * New schematic done
    Works with TLIN1028-Q1 transceiver
    Added BMP581 pressure sensor
    Removed 3wire output stage
    * FInal ordered hardware
    New 3pin connector
    Extra 2pin connector for cadence measurement
    No 3pin sensor variant
    DC/DC converter for MCU
    Pressure sensor
    [BMI088.step, BMP581.step, TPS629210DRLR.step, VLS3015CX-1R0M-1.step, connector-pcb.kicad_pcb, connector-pcb.kicad_sch, pcba_outline.dxf, rotor-sensor.kicad_pcb]
2025-10-19 Sw/gen2.1 (#20)
    * Pressure sensor and IMU
    Integrated both Bosch drivers
    Bootloader is disabled for now as it doesn't support
    the pins used in this project
    * Working pressure sensor and IMU
    Integrated new bootloader
    * Mostly working altitude measurement
    * New signals
    * Altitude estimation (chatgpt code)
    * Mostly working software
    Still has issues with speed measurement, works okayish above 15km/h
    Altitude measurement is not very accurate and the increments in large jumps
    Distance/Gear/Cadence not yet tested
    IMU does read the data but it's not used yet
    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
    [Assembly.stl, Base.stl, Base_v23.stl, Base_v54_2wire.stl, Base_v9_3wire.stl, BearingFlange.stl, CenterLockCarrier.stl, Cover.stl]
2025-10-19 Fixes BMI088 and BMP581 3d models using absolute paths (#22)
    [rotor-sensor.kicad_pcb]
